psas/rocket-tracks/Documentation/poster/Rocket_Tracks_Overall.png

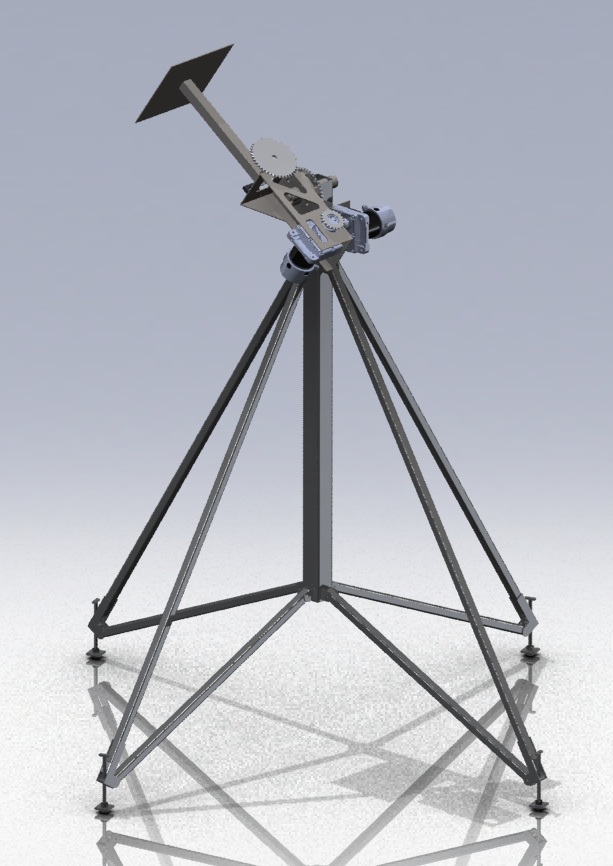
Documentation/poster/Rocket_Tracks_Overall.png
