psas/rocket-tracks/README.md

rocket-tracks
=============

CAD files for the Rocket Tracks project
