psas/rocket-tracks/Documentation/poster/RTx_pp_presentation.pptx

## RocketTracks Capstone

Rob Gaskell Robert Corkran Robin Davis

## Problem or Need

- What good is a high tech rocket if you can’t track it?
  - Current PSAS methods of tracking are limited by dependence on human eye
- Rockets move fast
  - Keeping antennas and cameras pointed at them during flight is a challenge
- RocketTracks was originally conceptualized in 2011as a mechanical structure controlled by a manual control box
  - While this was an improvement on earlier handheld models, it still left too much room for human error

Idea

Eliminate human error by adding automatic tracking capabilities to the existing RocketTracks system

## Implementation

- Create RocketTracks controller board to interface mechanical system with automatic and manual control boards
- Implement Ethernet for communication between different blocks of RocketTracks system
- Interface with Sightline SLA-1500 to add automatic tracking
- Improve control loop for manual controller and interface via Ethernet
- Implement power pre-charge circuitry
- Create safety protocols and perform FMEA analysis to protect from personal injury or damage to system

## Top-Level Requirements

- Be capable of tracking the PSAS launch vehicle throughout the duration of its boost stage of flight
- Be portable / self-powered
- Withstand exposure to rain while powered down (Excluding payload)
- Be operable in temperatures typical of Brothers, OR year-round
- Prevent single points of failure from causing injury or permanent damage to the unit or properly attached payloads
- Allow manual control of individual axes
- Interface with existing mechanical design and motor drivers
- Support remote operation
- The system will contain an API for relevant communications via Ethernet
- Interface with Sightline SLA1500 via Ethernet
- Provide power over Ethernet to payload devices

## Design & Implementation

## System Level Block Diagram

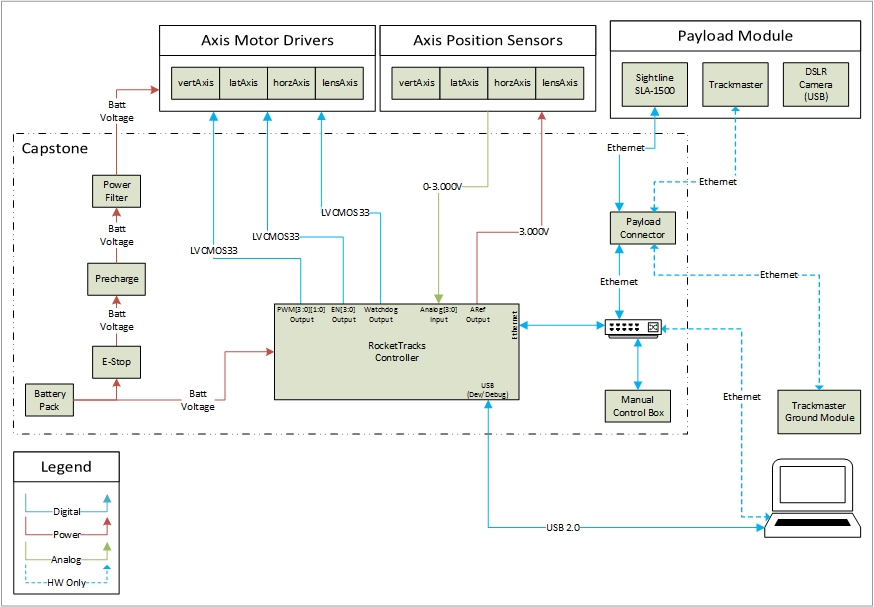
[picture p3: figure]

## RTx Controller Block Diagram

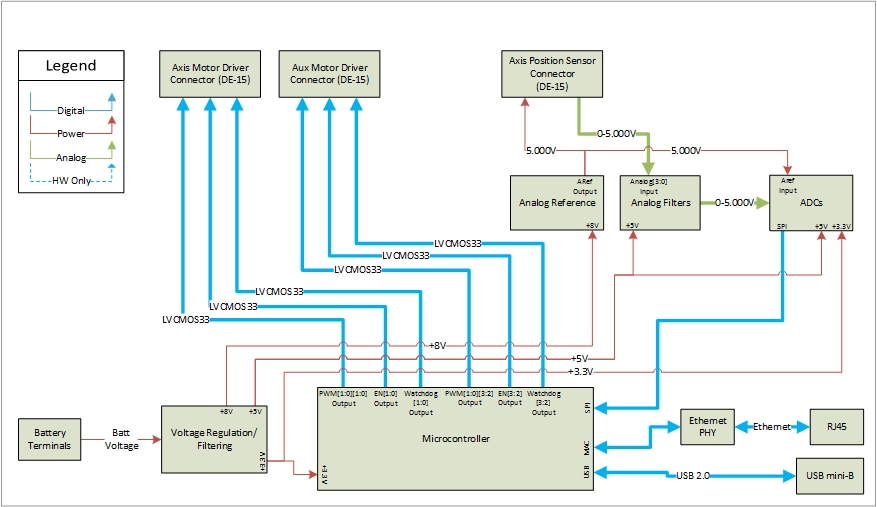
[picture p4: figure]

## Implementation: RTx Controller ADC Circuitry

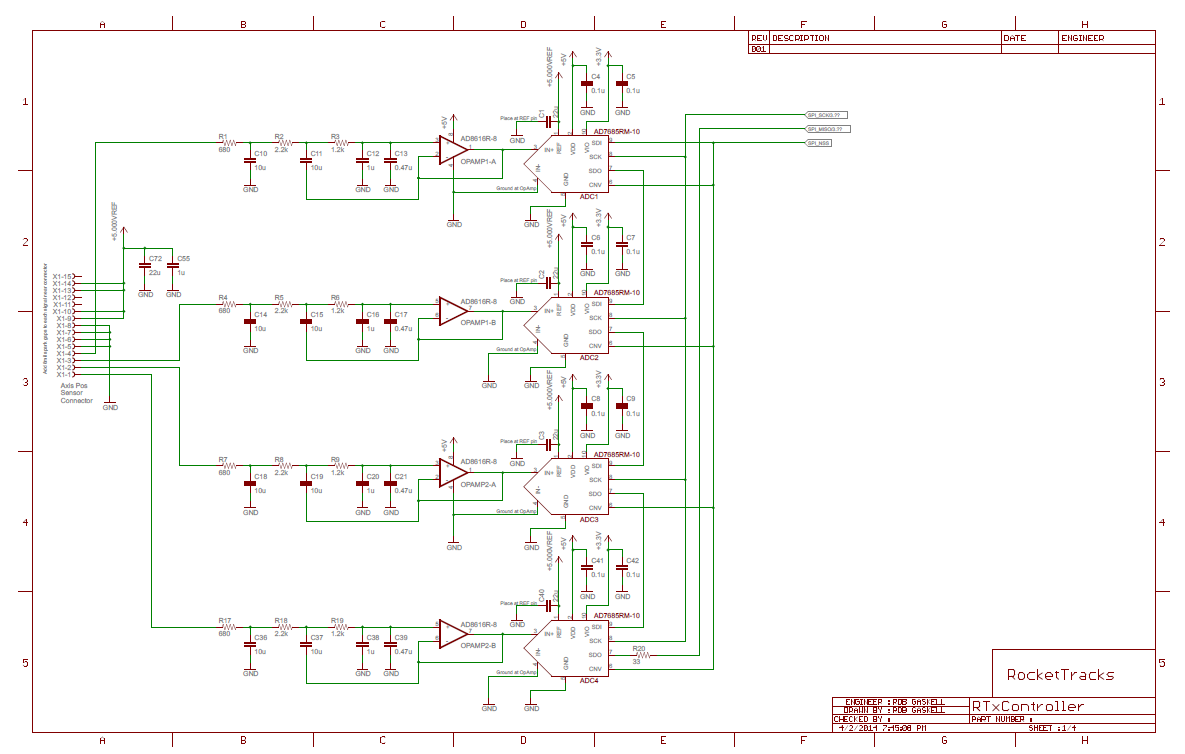
[picture p5: figure]

## Implementation: RTx Controller Power Circuitry

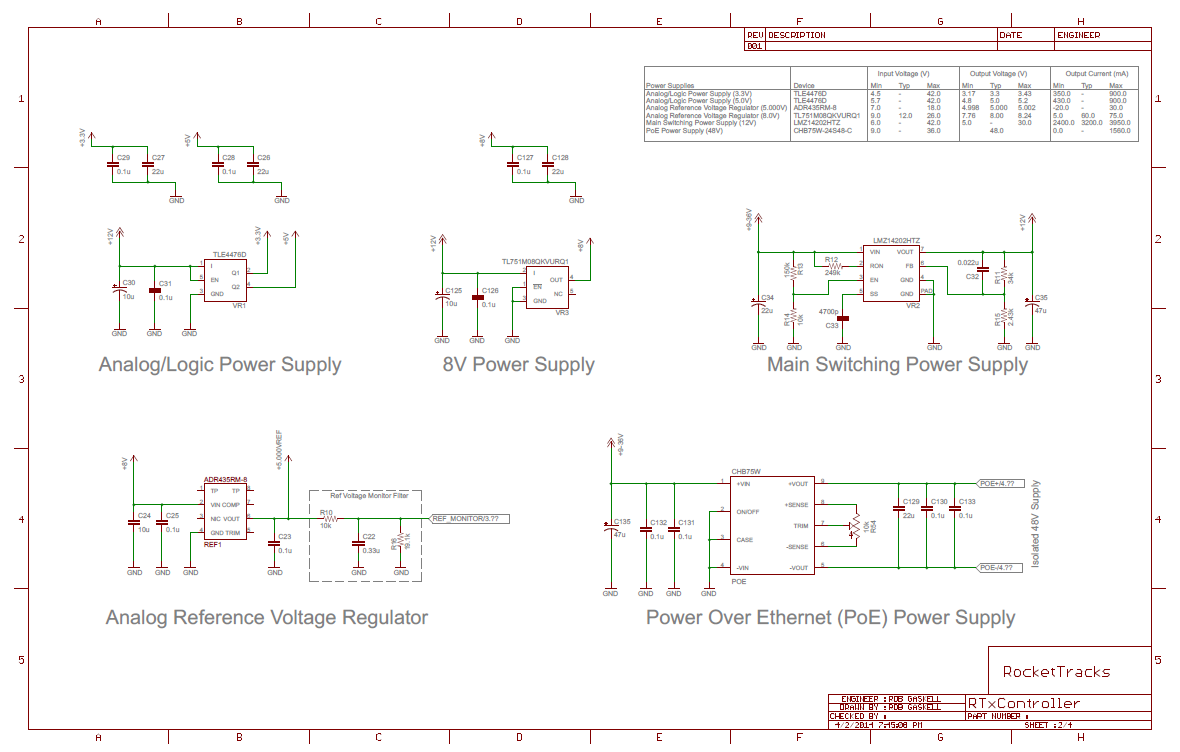
[picture p6: figure]

## Implementation: RTx Controller μC Circuitry

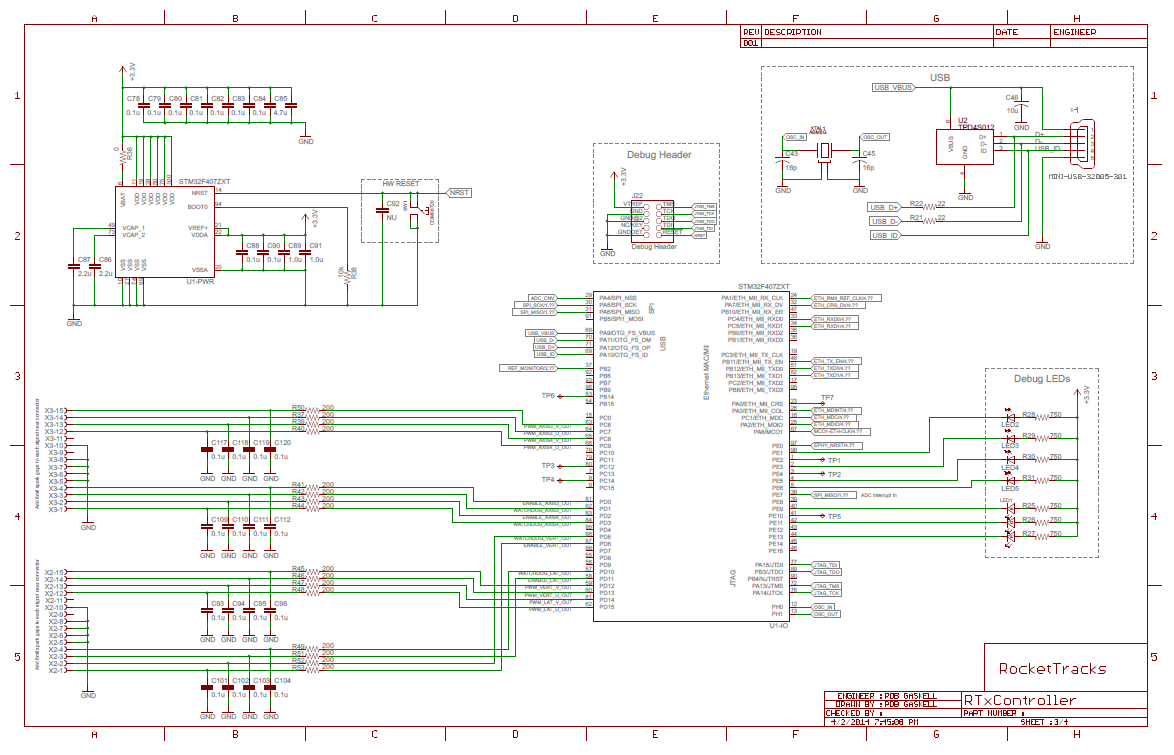
[picture p7: figure]

## Implementation: RTx Controller Ethernet Circuitry

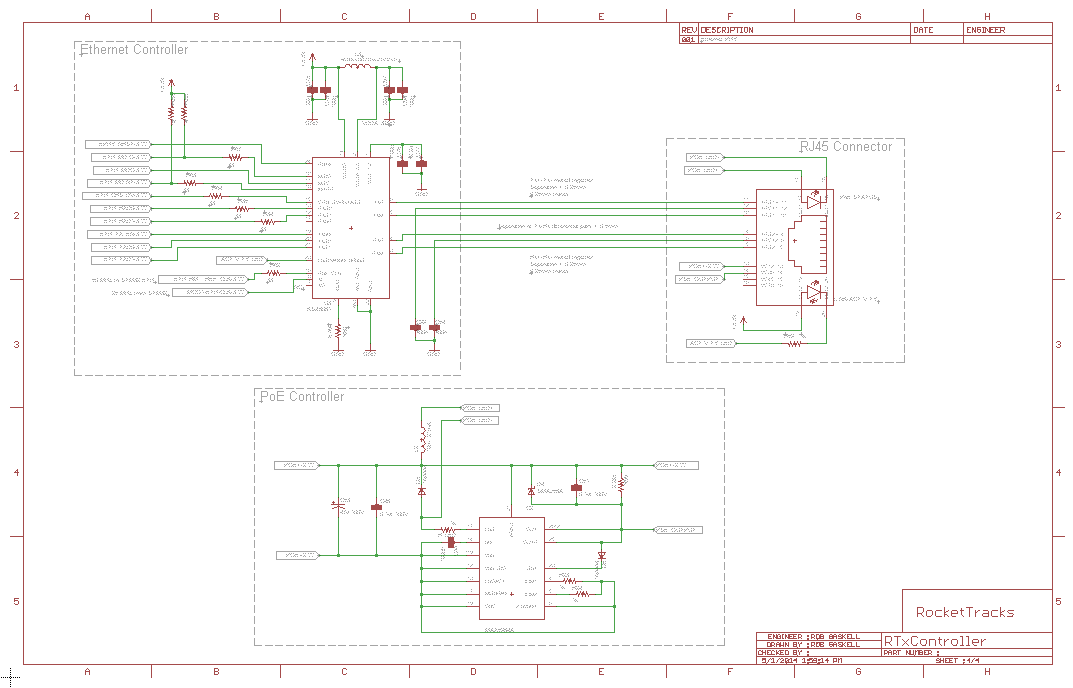
[picture p8: figure]

## Implementation: Manual Remote

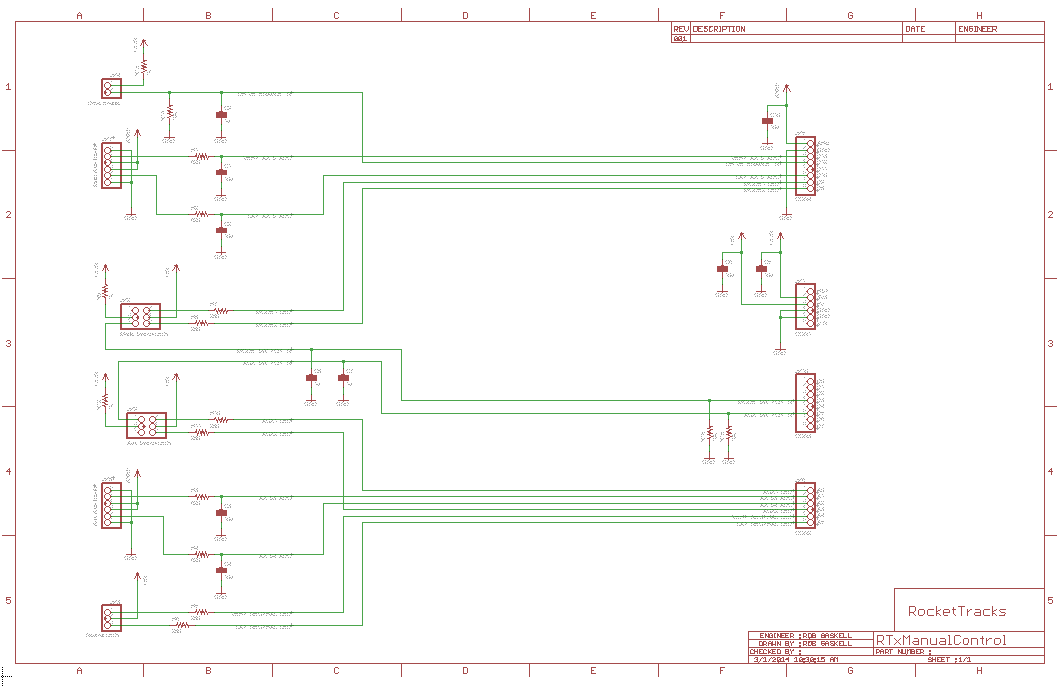
[picture p9: figure]

## Implementation: Precharge Circuit

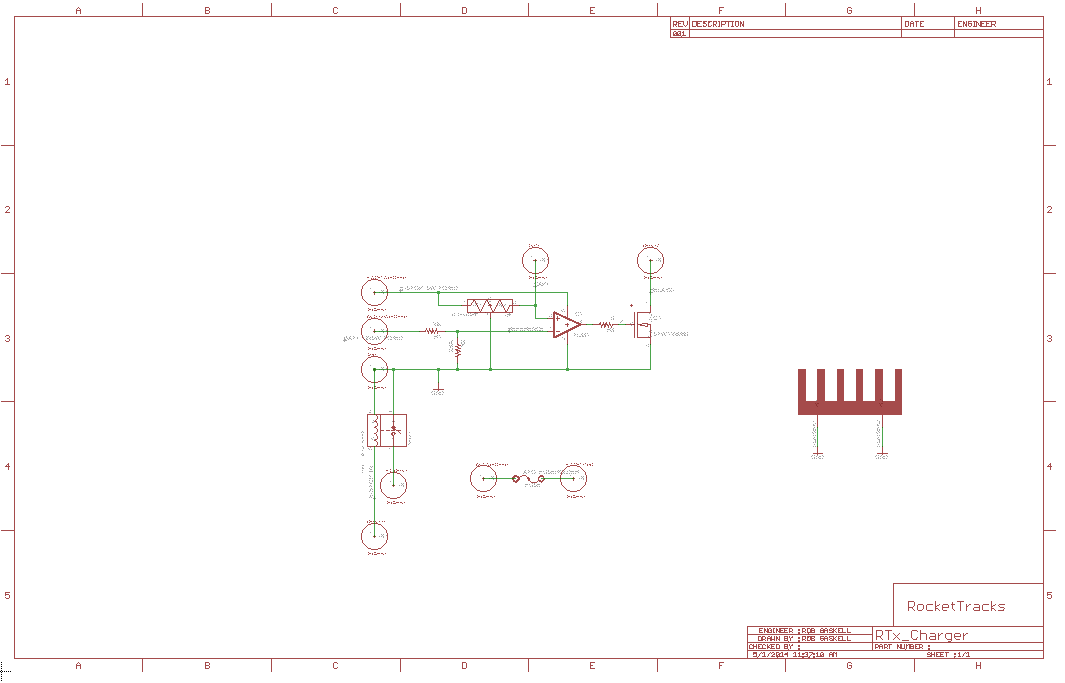
[picture p10: figure]

## Issues Encountered

## Issues Encountered: Hardware

- USB connector case not properly grounded
- Relays’ cases needed to be connected to power and isolated from enclosure
- Wrong capacitor footprint used so cap bank needs to be reworked
- Incorrect connector pinouts from motor driver boards to RTx controller
- PoE not performing at full potential

## Issues Encountered: Software

- Ethernet message passing errors
- High-latency on the receiver end of Ethernet packets
- SPI config and interrupt triggering

## Future Work/Expansion and Improvement

## Next Steps

- Test at launch 11 on July 20th
- Provide data to Sightline to improve their tracking algorithm
- Update board files to correct for issues found
- Build safety perimeter
- Design and build payload connector

Expansion and Improvement

Possibly create cellphone app to interface with system
removes need for physical proximity to mechanical structure

## Q&A
