psas/rocket-tracks/Documentation/poster/poster2.pptx

## RocketTracks

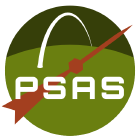
[picture p13: figure]

Portland State
Aerospace Society

Sponsor: Andrew Greenberg

Rob Gaskell, Robin Davis, Robert Corkran

Portland State
University

Advisor: Malgorzata Jeske

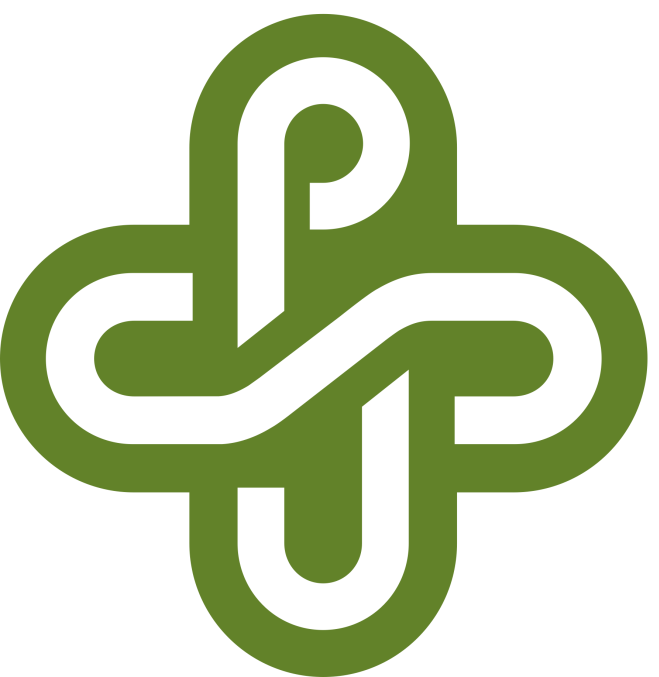
[picture p14: figure]

PROBLEM

What good is a high tech rocket if you can’t track it?
Current PSAS methods of tracking are limited by dependence on human eye.

Rockets move fast.
Keeping antennas and cameras pointed at them during flight is a challenge.

RocketTracks was originally conceptualized in 2011 as a mechanical structure controlled by a manual control box.

While this was an improvement over earlier handheld models, it still left too much room for human error.

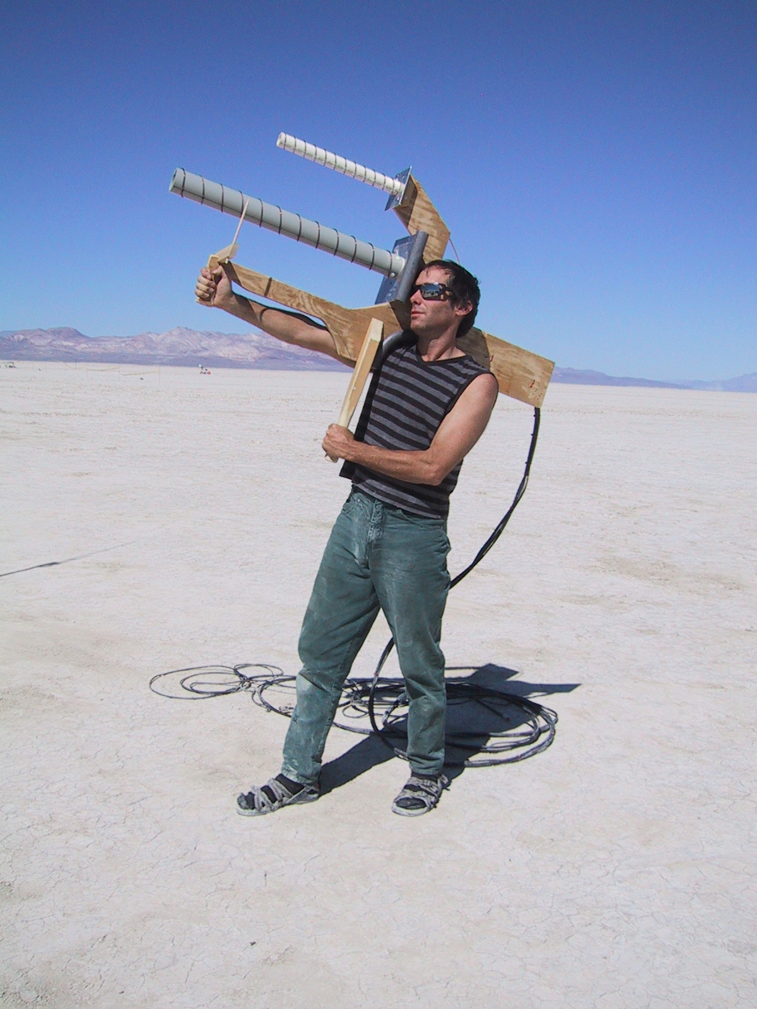
[picture p15: figure]
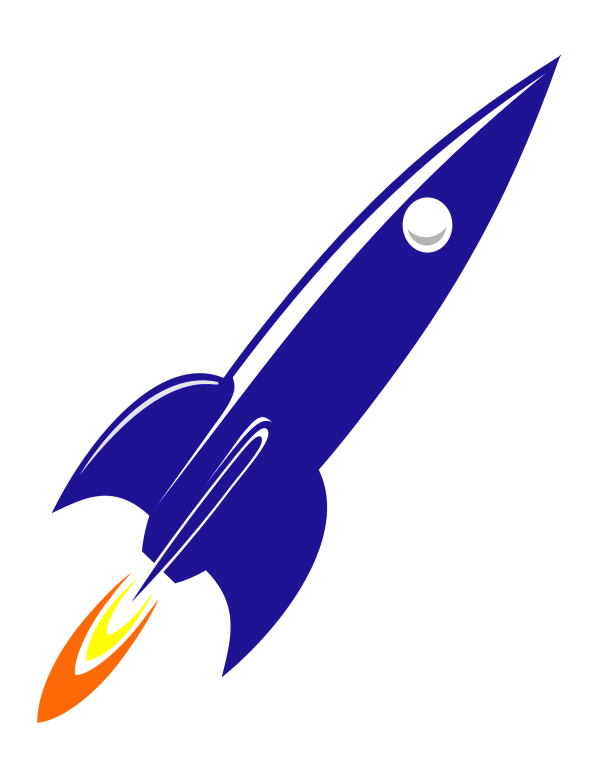
[picture p16: figure]
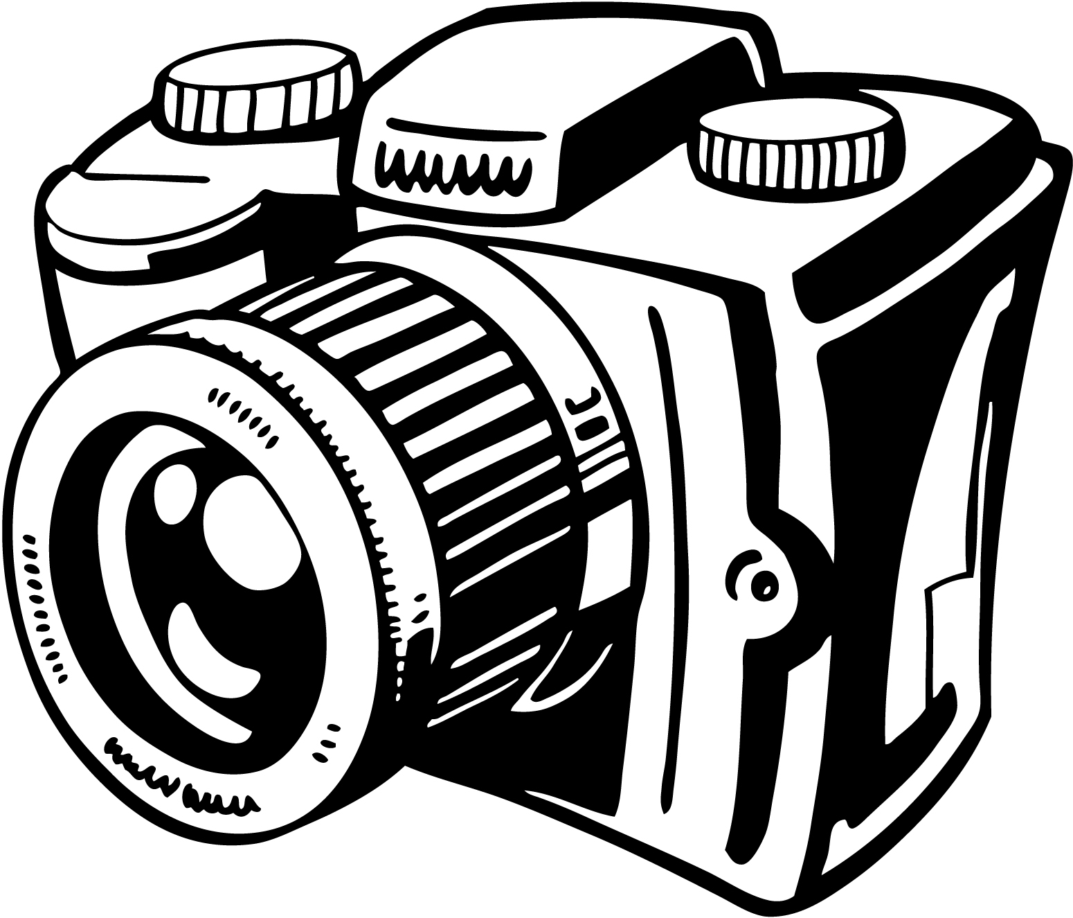
[picture p17: figure]

HOW IT WORKS

User selects mode

Manual Mode:
User can adjust the direction that RocketTracks points by turning two nobs corresponding to the horizontal and vertical axes

Automatic Mode:
- User selects object to track using laptop.
- Camera provides feedback to Sightline® as to position of the object.
- RTx Controller adjusts mechanical position accordingly

Emergency Stop
Automatic removal of power to system if:
- Big red button is pushed
- User gets too close to system
- Any single component breaks that could result in loss of system control

RTx
Controller

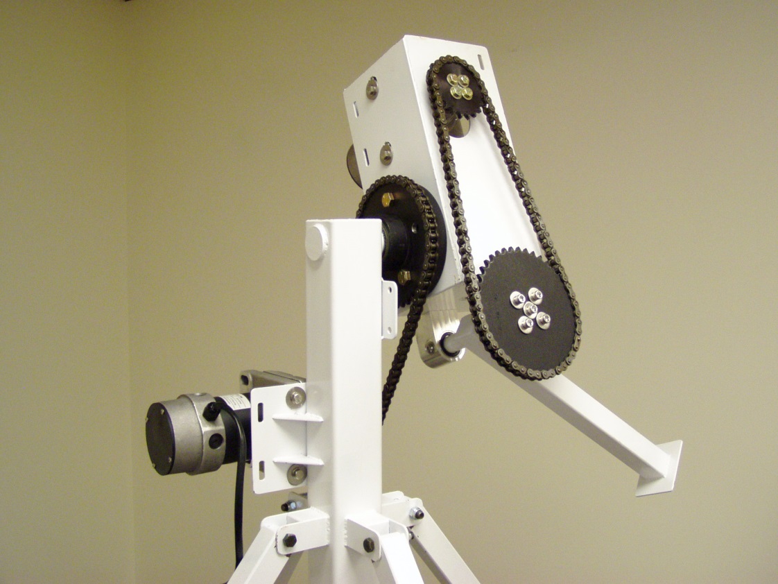
[picture p18: figure]

IDEA

Eliminate human error by adding automatic tracking capabilities to the existing RocketTracks system.

Manual
Control

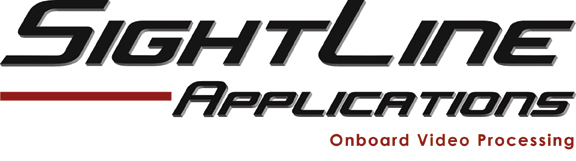
[picture p19: figure]

IMPLEMENTATION

- Create RocketTracks controller board to interface mechanical system with automatic and manual control boards
- Implement Ethernet for communication between different blocks of RocketTracks system
- Interface with Sightline SLA-1500 to add automatic tracking
- Improve control loop for manual controller and interface via Ethernet
- Create safety protocols and perform FMEA analysis to protect from personal injury or damage to system

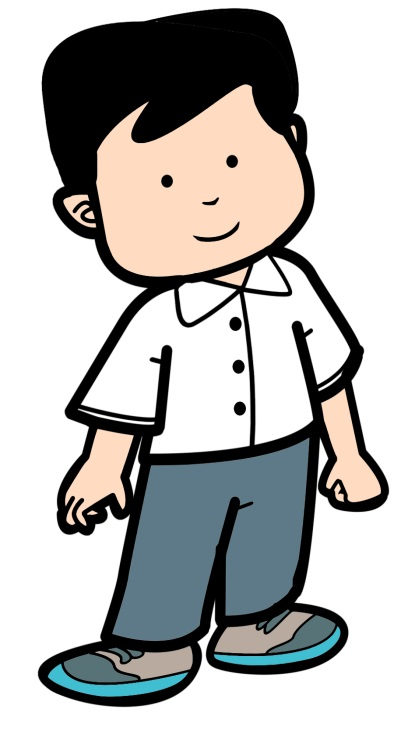
[picture p20: figure]
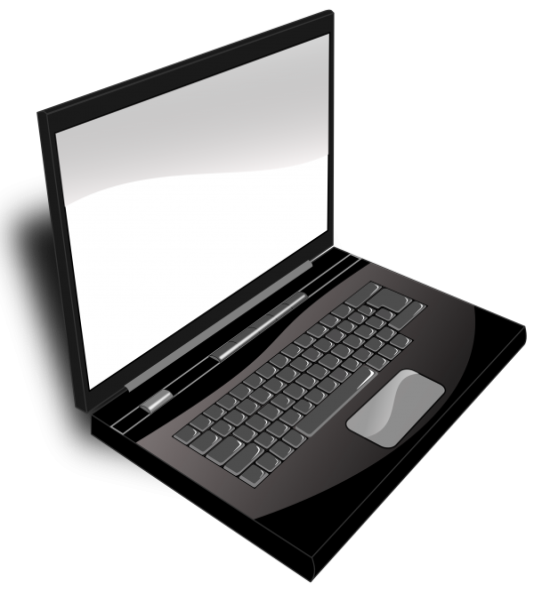
[picture p21: figure]

RTX CONTROLLER BLOCK DIAGRAM

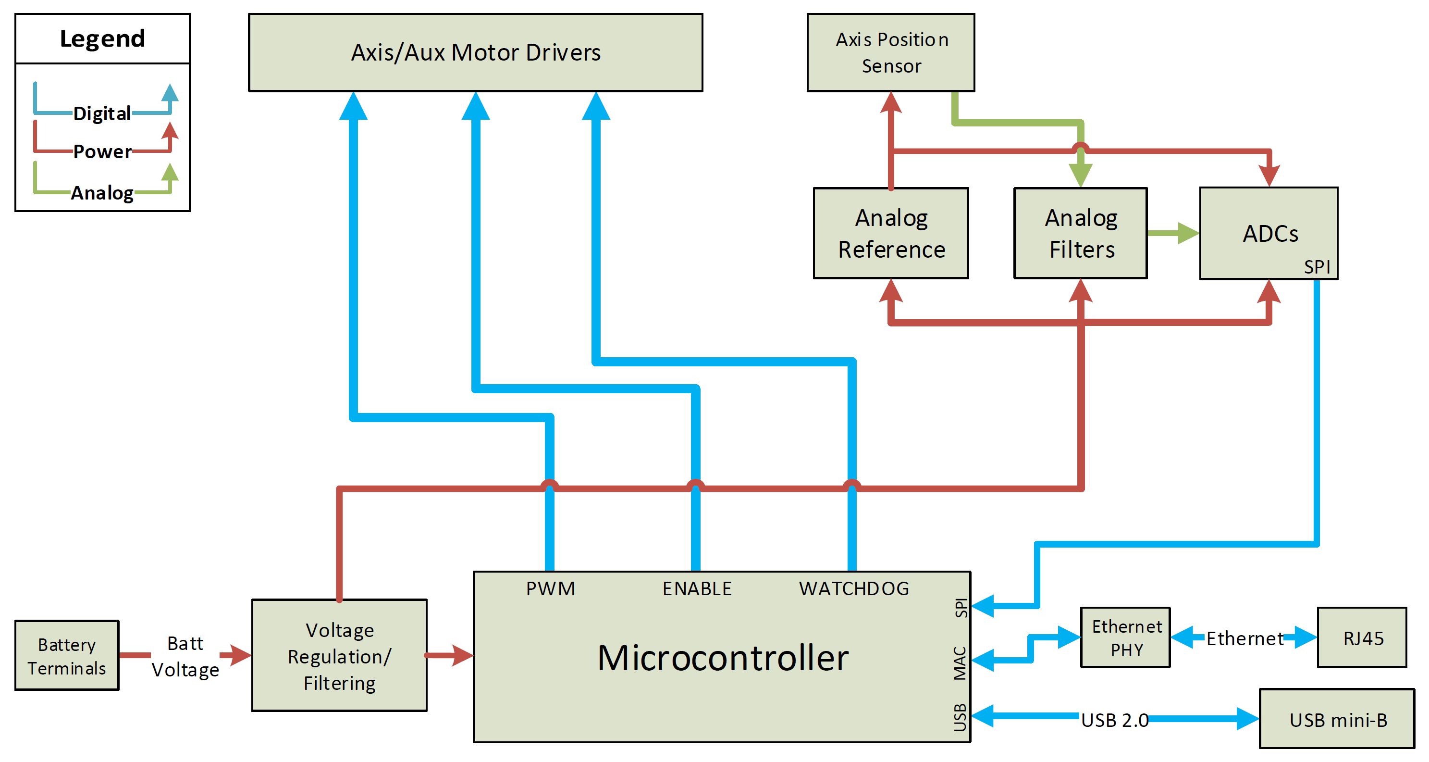
[picture p22: figure]
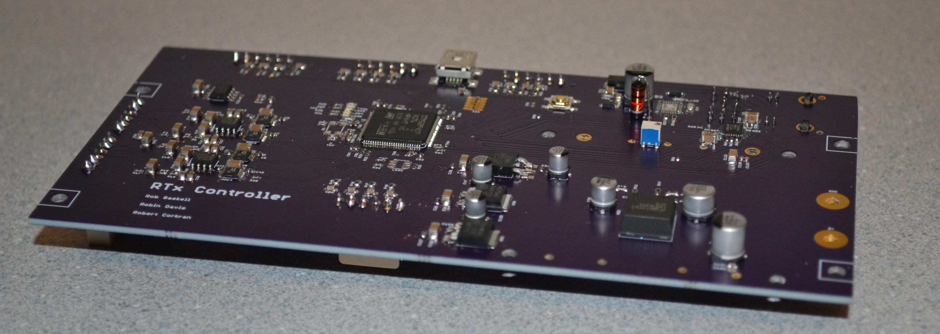
[picture p23: figure]
RTx controller board
