psas/rocket-tracks/Documentation/poster/YWMSy_Poster_V5 (4).pptx

## You Watch My Stuff

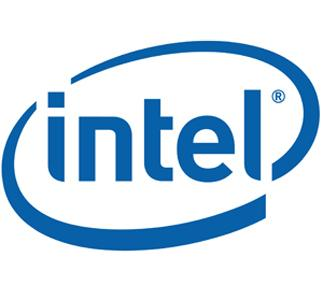
[picture p24: figure]

Sponsor: Chris Wilkerson

Team Members: Hussain Alsaffar, Richard Atwood, Amrutha Doosa, Raed Alkhaldi, Randy Duran


Adviser: Malgorzata Jeske

Theft is very common nowadays especially between college students. Today students can’t guarantee that their belongings will not be stolen while leaving it unattended. So?

Then you need YWMSy!

The Project You Watch My Stuff was Created and Sponsored by Chris Wilkerson from Intel. The Project is an Alarm Device that can be attached or placed on to any item you would like to secure. The Alarm Device is used in conjunction with a cell phone application. The phone application is used to turn “ON” the device and enable the Alarm.

A security device that will alert the user and keep a thief from stealing your belongings is a necessity in these days.

- Bluetooth Type 2 Range is about 30ft /10m in sight
- User friendly Android GUI
- Secure Communication via Bluetooth
- Alarm Triggered when device is Moved
- Panic/Finder Enabled
- Portable
- Battery life time more then 12 hours and less than122 hours

PROBLEM

Has this ever happened to you

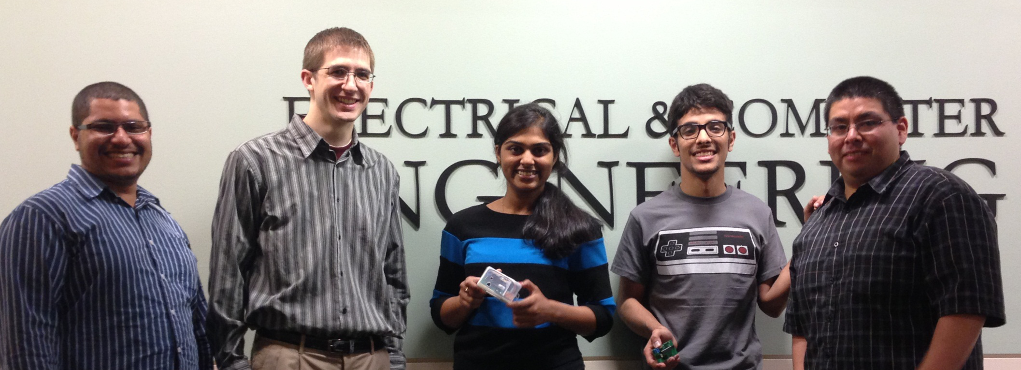
[picture p26: figure]

HYPOTHETICAL VISION

The You watch my Stuff Project has Future plans in expanding the many feature possibilities. The Future objective of this Project will be to create a smaller, affordable and Interactive device such as the designs shown below

Features:
- Pedometer
- GPS Tracker
- Waterproof package
- Small package using surface mount components
- Close to Out of Range area cell phone notification
- Rechargeable batteries

ACKNOWLEDGEMENTS

We want to thank the following people for their support and feedback on Our Progress
Sponsor: Chris Wilkerson
Adviser: Malgorzata Jeske
Professor: Mark Faust

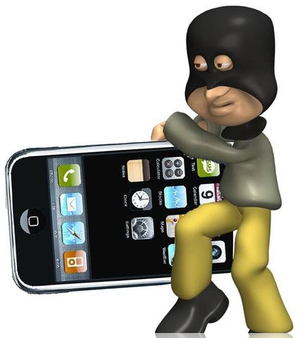
[picture p27: figure]

IMPLEMENTATION

The alarm device has a multicolor LED that Interacts with the user. Below is a chart of how the Alarm device Turns on the LED.

-Alarm is Detecting Movement
- Alarm is ‘ON’ state
- Alarm is Activated
-Triggered Alarm (Blink .5 sec)

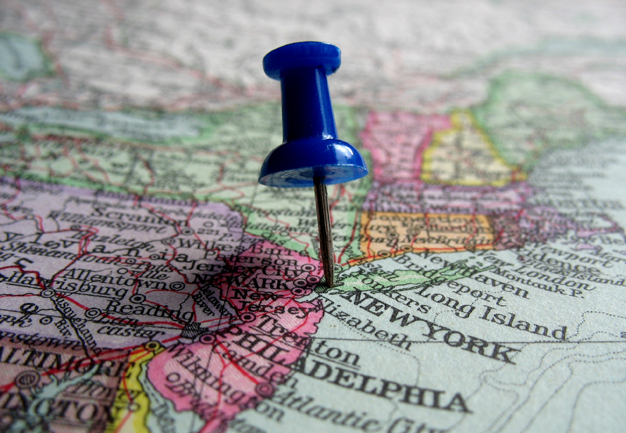
[picture p28: figure]

IDEA

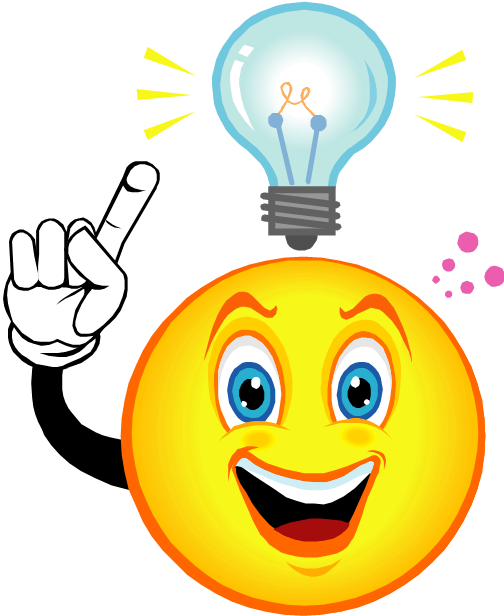
[picture p29: figure]

ANDROID APPLICATION

The Alarm device is controlled via cell phone and the Pictures below shows Graphic User Interface that controlled the Alarm device. The application has buttons to ON/OFF, Enable/Disabled and Panic the Alarm Device

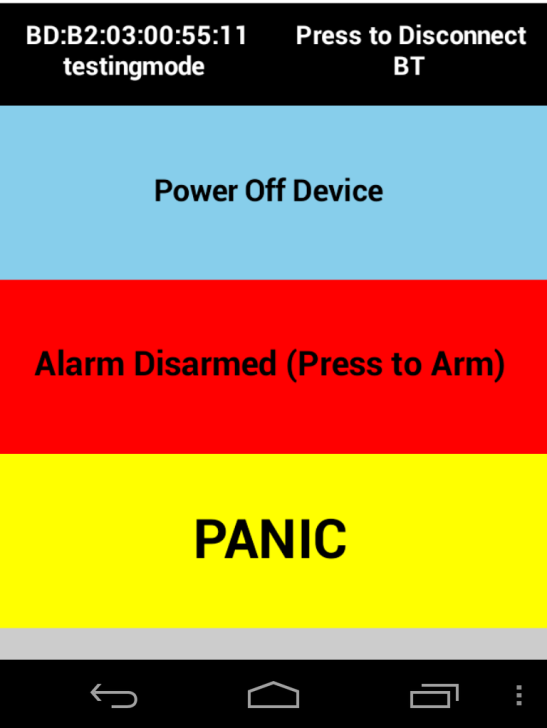
[picture p30: figure]
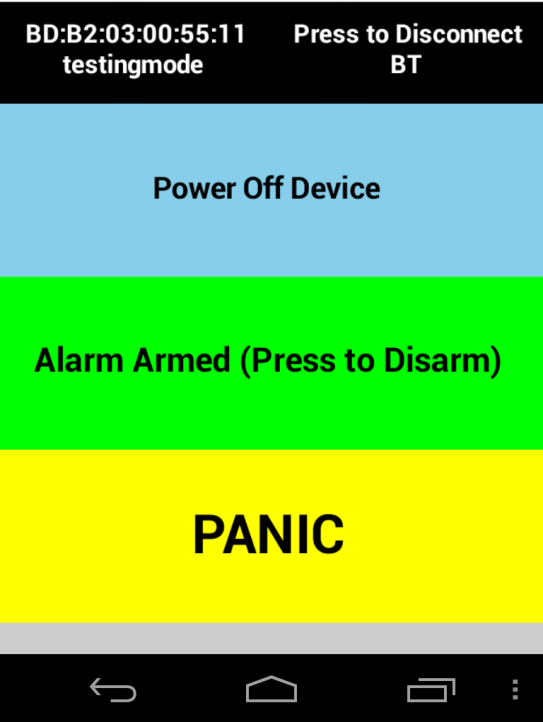
[picture p31: figure]
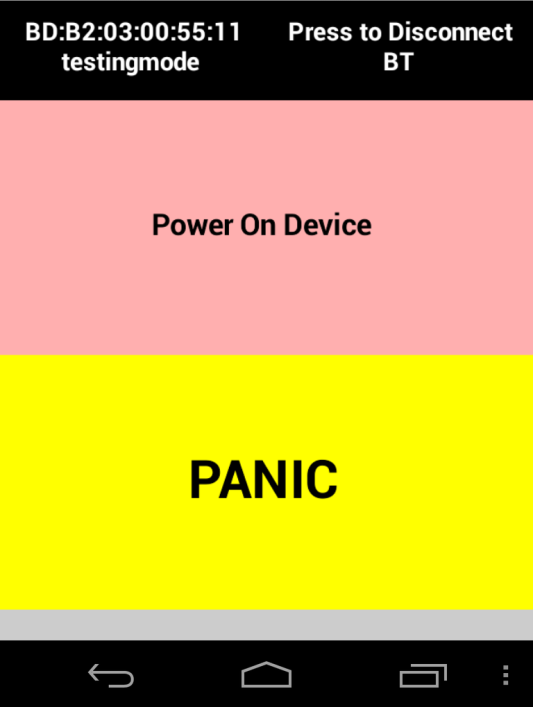
[picture p32: figure]

Pen Design

Alarm Ball Design

GOALS

DESIGN BLOCK DIAGRAM

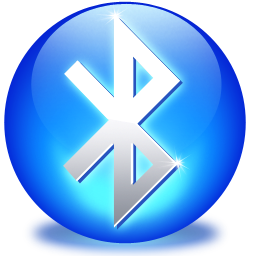
[picture p33: figure]

MCECS Department of Electrical and Computer Engineering
