psas/rocket-tracks/Documentation/RocketTracks SOP.docx

RocketTracks SOP

I. Setting up the system
1) Before approaching the RocketTracks mechanical structure:
  a. Ensure Main Power Box is disconnected from battery, if not please follow instructions for section IV before proceeding to step 2.
  b. Ensure Main Power Box is disconnected from RTx Controller Box, if not please follow instructions for section IV before proceeding to step 2.
2) Make sure the axis position sensors (D-sub connector) to RTx Controller Box (mounted on physical structure) are connected. Make sure the screws are snug.
3) Make sure motor drivers are connected to RTx Controller Box. Make sure connector is snapped into place.
4) Connect Ethernet cable from manual remote to Rtx controller port 3 or 4.
5) Optional Step: If you will be operating in Automatic Mode, connect Laptop with Sightline software installed to the RTx Controller Box via Ethernet port 3 or 4.
6) Connect Power from Main Power Box to RTx Controller Box.
7) Ensure main power switch is in OFF position.
8) Connect Main Power Box to batteries
9) Ensure E-stop button is released
10) Switch power switch to on position
11) Now that the system is on do not approach the mechanical structure. If you need to do so for any reason follow procedure from section IV first.
II. To operate in Manual mode:
1) Enable Drive enable Switch
  a. Lift guard
  b. Toggle the switch
2) Switch mode switch to manual position
3) Control using vertical and lateral axis position knobs
4) Should odd behavior occur or an emergency arise push the E-stop button and then proceed to section IV.
5) See section IV to shut system down.
III. To operate in Automatic Mode:
1) Enable Drive enable Switch
  a. Lift guard
  b. Switch the switch
2) Switch mode switch to automatic position
3) There are not currently steps for this procedure; they will be updated after the automatic tracking capabilities of RocketTracks are tested.
4) See section IV to shut system down.
IV. Shutting down the system
1) Disable the drive enable switch by closing the guard
2) Switch power to off on Main Power Box
3) Disconnect Main Power Box from battery
4) Disconnect Main Power Box from RTx Controller Box
5) Disconnect Manual Control from RTx Controller Box
6) If laptop is connected disconnect it from RTx Controller Box
