psas/rocket-tracks/Documentation/poster/rocket-512.gif

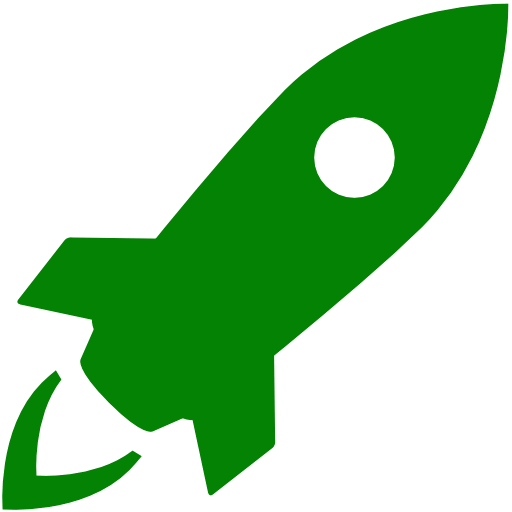
Documentation/poster/rocket-512.gif
