psas/rocket-tracks/Generic_Motor_Driver_Board/Motor Controller Board.png

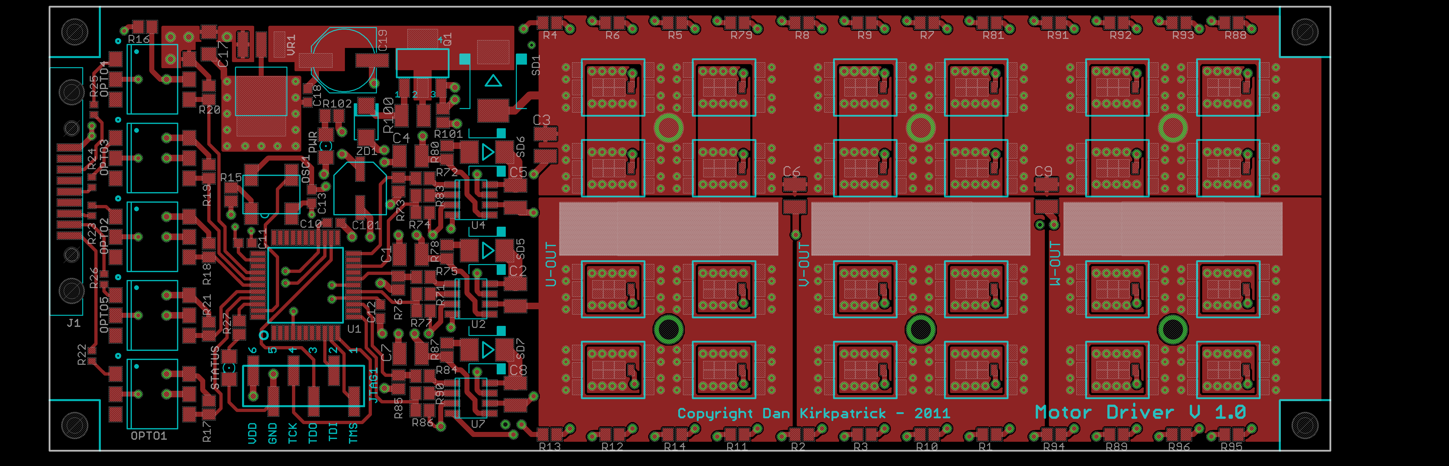
Generic_Motor_Driver_Board/Motor Controller Board.png
