psas/rocket-tracks/RTx_Controller_Board/Pictures/RTx Controller 001.JPG

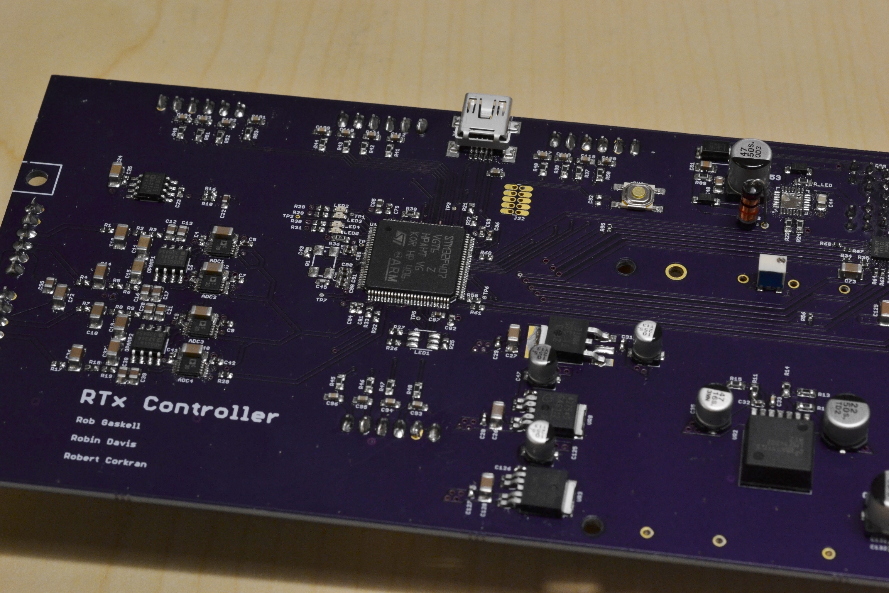
RTx_Controller_Board/Pictures/RTx Controller 001.JPG
