psas/rocket-tracks/RTx_Controller_Board/Pictures/RTx Controller 002.JPG

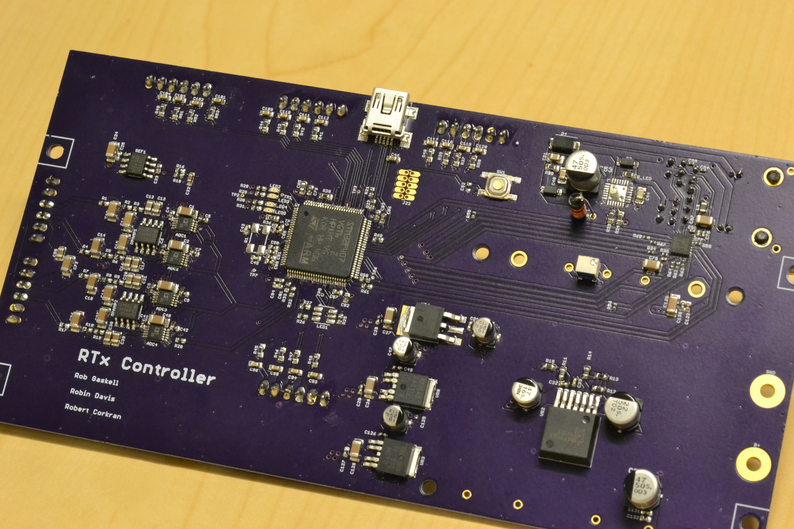
RTx_Controller_Board/Pictures/RTx Controller 002.JPG
