psas/rocket-tracks/RTx_Controller_Board/Pictures/RTx Controller 003.JPG

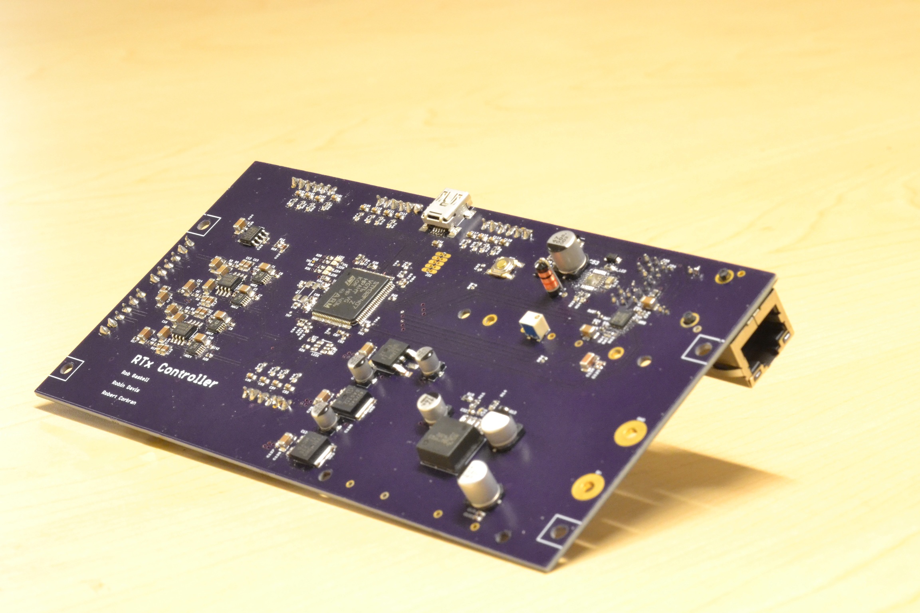
RTx_Controller_Board/Pictures/RTx Controller 003.JPG
