psas/rocket-tracks/RTx_Controller_Board/Pictures/RTx Controller 004.JPG

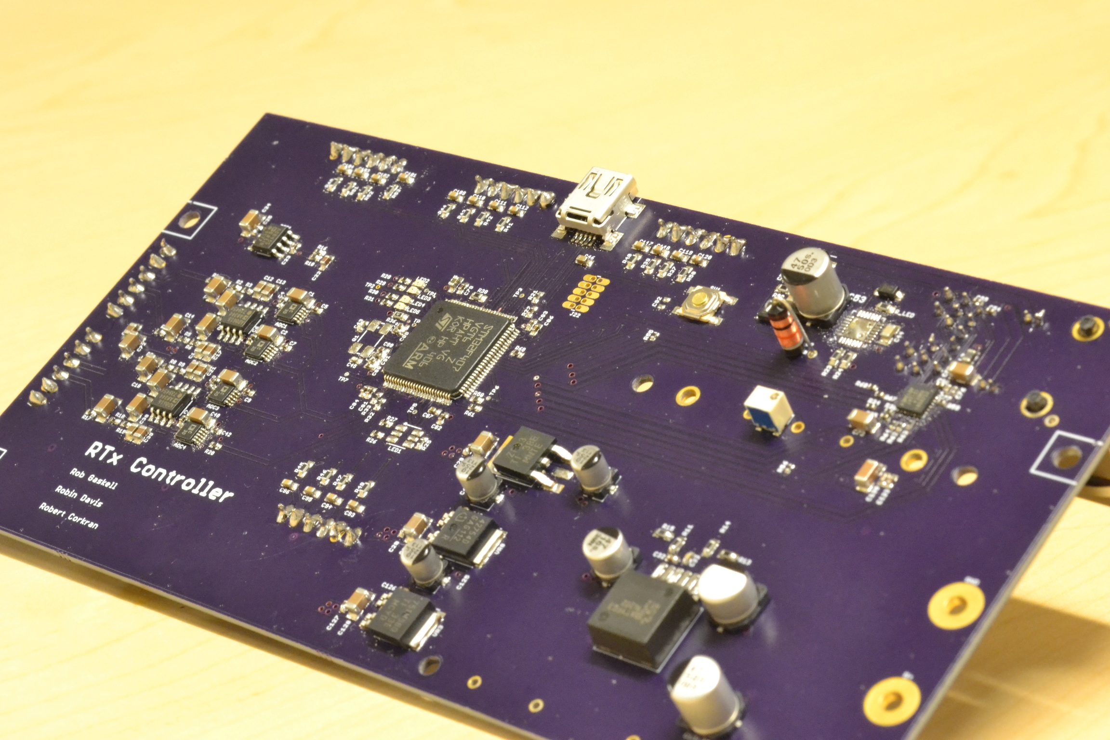
RTx_Controller_Board/Pictures/RTx Controller 004.JPG
