psas/rocket-tracks/RTx_Controller_Board/Pictures/RTx Controller 005.JPG

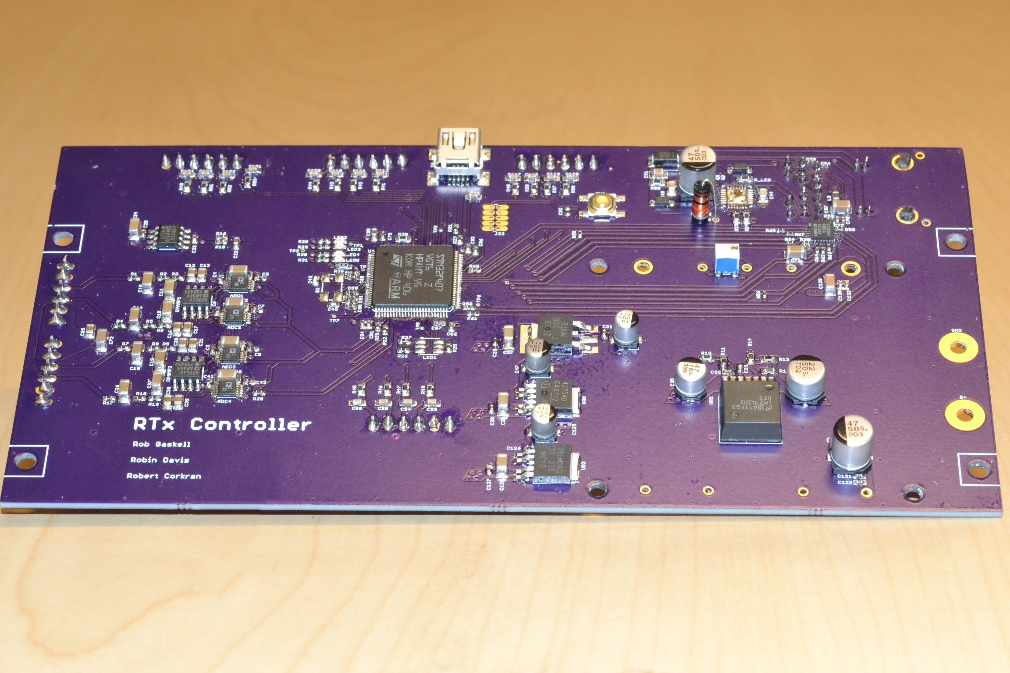
RTx_Controller_Board/Pictures/RTx Controller 005.JPG
