psas/rocket-tracks/RTx_Controller_Board/Pictures/RTx Controller 006.JPG

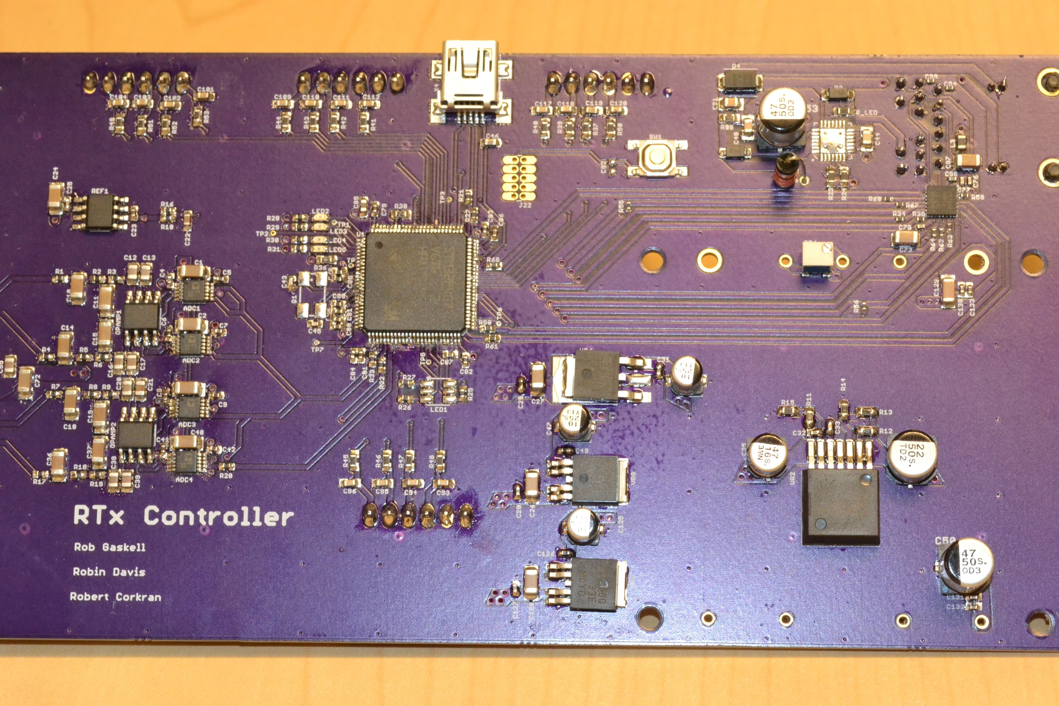
RTx_Controller_Board/Pictures/RTx Controller 006.JPG
