psas/rocket-tracks/RTx_Controller_Board/Pictures/RTx Controller 007.JPG

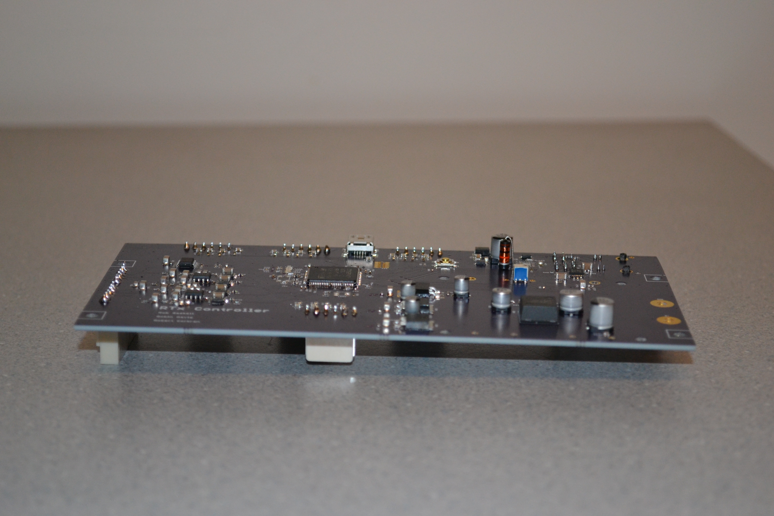
RTx_Controller_Board/Pictures/RTx Controller 007.JPG
