psas/rocket-tracks/RTx_Controller_Board/Pictures/RTx Controller 008.JPG

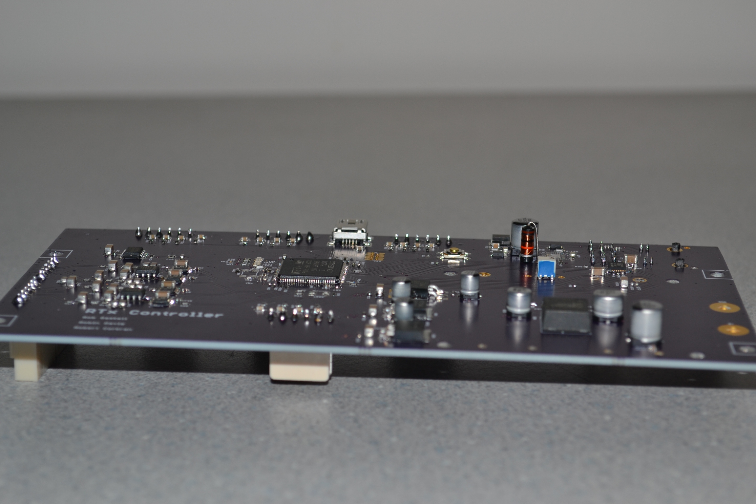
RTx_Controller_Board/Pictures/RTx Controller 008.JPG
