psas/rocket-tracks/RTx_Controller_Board/Pictures/RTx Controller 009.JPG

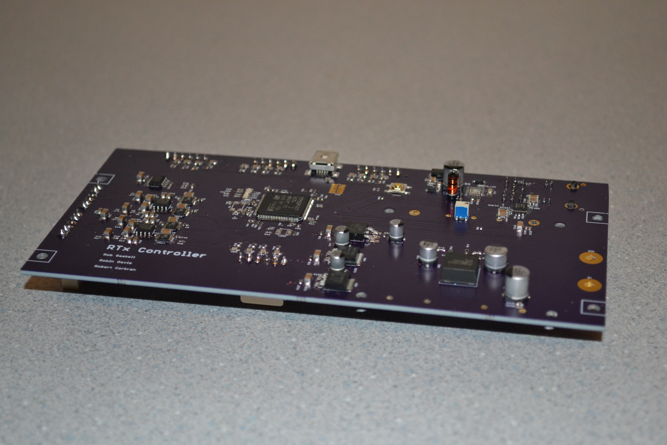
RTx_Controller_Board/Pictures/RTx Controller 009.JPG
