psas/rocket-tracks/RTx_Controller_Board/RTxControllerBoardBOM.xlsx

Sheet: Sheet1
RTx ID | Order Qty | Order PN | Notes | Value | Device | Package | Qty | Parts | Description | MF | MPN | OC_FARNELL | OC_NEWARK | TP_SIGNAL_NAME | VARIANT
1 | 10 | 1276-1119-1-ND | 0603 | 10u | C-USC0402 | C0402 | 1 | C46 | CAPACITOR, American symbol
2 | 10 | 1276-1571-1-ND |  | 4700p | C-EUC0402 | C0402 | 1 | C33 | CAPACITOR, European symbol
3 | 30 | 1276-1804-1-ND |  | 10u | C-EUC1206 | C1206 | 9 | C10, C11, C14, C15, C18, C19, C24, C36, C37 | CAPACITOR, European symbol
4 | 35 | 1276-3047-1-ND |  | 22u | C-EUC1206 | C1206 | 10 | C1, C2, C3, C26, C27, C40, C72, C128, C73, C97 | CAPACITOR, European symbol
5 | 12 | 160-1445-1-ND |  |  | LEDCHIP-LED0603 | CHIP-LED0603 | 4 | LED2, LED3, LED4, LED5 | LED
6 | 10 | 1N4448W-FDICT-ND |  | 1N4448 | 1N4448 | SOD-123 | 2 | D3, D5
7 | 3 | 296-20658-1-ND |  | TLV1117-33IKVU | TLV1117-33IKVU | PG-TO252-3-11 | 1 | VR6
8 | 3 | 296-28078-1-ND |  | TL751M08QKVURQ1 | TL751M08QKVURQ1 | PG-TO252-5-11 | 1 | VR3 | 8V power supply.
9 | 10 | 311-1142-1-ND |  | 100nF | C-EUC0805K | C0805K | 1 | C44 | CAPACITOR, European symbol
10 | 10 | 3223W-1-103-ND | Robert | 10k | TRIM_US-3223W | 3223W | 1 | R54 | POTENTIOMETER
11 | 50 | 399-1096-1-ND |  | 0.1u | C-EUC0603 | C0603 | 16 | C93, C94, C95, C96, C101, C102, C103, C104, C109, C110, C111, C112, C117, C118, C119, C120 | CAPACITOR, European symbol
12 | 10 | 399-11118-1-ND |  | 16p | C-USC0402 | C0402 | 2 | C43, C45 | CAPACITOR, American symbol
13 | 20 | 399-1284-1-ND |  | 1u | C-EUC0805 | C0805 | 5 | C12, C16, C20, C38, C55 | CAPACITOR, European symbol
14 | 10 | 399-3486-1-ND |  | 0.1uf 100V | C-EUC0805K | C0805K | 2 | C48, C51 | CAPACITOR, European symbol
15 | 10 | 445-5126-1-ND |  | 0.33u | C-EUC0603 | C0603 | 1 | C22 | CAPACITOR, European symbol
16 | 12 | 445-5942-1-ND |  | 0.1u 50V | C-EUC0402 | C0402 | 4 | C131, C132, C130, C133 | CAPACITOR, European symbol
17 | 5 | 445-5998-1-ND |  | 10u 50V | C-EUC1206 | C1206 | 1 | C129 | CAPACITOR, European symbol
18 | 15 | 445-6847-1-ND |  | 2.2u | C-EU0402-C-NOSILK | 0402-C-NOSILK | 3 | C77, C86, C87 | CAPACITOR, European symbol
19 | 3 | 490-1046-1-ND | Robert | FB0805/600R/200mA(201209-601) | L-US0805-C-NOSILK | 0805-C-NOSILK | 1 | L3 | INDUCTOR, American symbol
20 | 3 | 497-11605-ND |  | STM32F407ZXT | STM32F407ZXT | LQFP-100 | 1 | U1
21 | 10 | 507-1569-ND | Robert | 0826-1X1T-GJ-F | 0826-1X1T-GJ-F | MAGJACK-RJ45 | 1 | X8
22 | 3 | 576-4177-1-ND |  | KSZ8081 | KSZ8081 | QFN-24 | 1 | U3
23 | 10 | 587-1224-1-ND |  | 0.022u | C-EUC0402 | C0402 | 1 | C32 | CAPACITOR, European symbol
24 | 80 | 587-1227-1-ND |  | 0.1u | C-EUC0402 | C0402 | 25 | C4, C5, C6, C7, C8, C9, C23, C25, C28, C29, C31, C41, C42, C49, C78, C79, C80, C81, C82, C83, C84, C88, C90, C126, C127 | CAPACITOR, European symbol
25 | 25 | 587-1231-1-ND |  | 1.0u | C-EUC0402 | C0402 | 7 | C89, C91, C54, C75, C76, C98, C99 | CAPACITOR, European symbol
26 | 15 | 587-1282-1-ND |  | 0.47u | C-EUC0805 | C0805 | 4 | C13, C17, C21, C39 | CAPACITOR, European symbol
27 | 10 | 587-1441-1-ND |  | 4.7u | C-EUC0603 | C0603 | 1 | C85 | CAPACITOR, European symbol
28 | 3 | 670-1190-1-ND | Robin | MINI-USB-32005-301 | MINI-USB-32005-301 | 32005-301 | 1 | X4 | MINI USB-B Conector |  |  | unknown | unknown
29 | 12 | AD7685BRMZRL7CT-ND |  | AD7685RM-10 | AD7685RM-10 | MSOP-10 | 4 | ADC1, ADC2, ADC3, ADC4
30 | 6 | AD8616ARZ-REEL7CT-ND |  | AD8616R-8 | AD8616R-8 | SOIC8 | 2 | OPAMP1, OPAMP2
31 | 3 | ADR435BRZ-REEL7CT-ND |  | ADR435RM-8 | ADR435RM-8 | SOIC8 | 1 | REF1
32 | 10 | AIAP-01-103-K-TCT-ND | Robert | 10m, 21mA | L-US0204V | 0204V | 1 | L2 | INDUCTOR, American symbol
33 | 3 | CKN9104CT-ND | Robin | COM08720 | COM08720 | COM08720 | 1 | SW1
34 | 3 | LMZ14202HTZ/NOPBCT-ND |  | LMZ14202HTZ | LMZ14202HTZ | PFM-7 | 1 | VR2
35 | 3 | MAX5984AETI+-ND | Robert | MAX5984A | MAX5984 | TQFN-28 | 1 | IC2 |  |  |  |  |  |  | C
36 | 10 | P0.0GCT-ND |  | 0 | R-US_R0603 | R0603 | 1 | R36 | RESISTOR, American symbol
37 | 15 | P1.00KHCT-ND |  | 1k | R-US_R0603 | R0603 | 3 | R23, R24, R_LED | RESISTOR, American symbol
38 | 15 | P1.00KLCT-ND |  | 1k | R-US_0402-C-NOSILK | 0402-C-NOSILK | 3 | R55, R56, R59 | RESISTOR, American symbol
39 | 15 | P1.20KLCT-ND |  | 1.2k | R-US_R0402 | R0402 | 4 | R3, R6, R9, R19 | RESISTOR, American symbol
40 | 10 | P10.0KHCT-ND |  | 10k | R-US_R0603 | R0603 | 2 | R14, R38 | RESISTOR, American symbol
41 | 10 | p10.0KLCT-ND |  | 10k | R-US_R0402 | R0402 | 1 | R10 | RESISTOR, American symbol
42 | 10 | P150KHCT-ND |  | 150k | R-US_R0603 | R0603 | 1 | R13 | RESISTOR, American symbol
43 | 10 | P19.1KLCT-ND |  | 19.1k | R-US_R0402 | R0402 | 1 | R16 | RESISTOR, American symbol
44 | 15 | P2.20KLCT-ND |  | 2.2k | R-US_R0402 | R0402 | 4 | R2, R5, R8, R18 | RESISTOR, American symbol
45 | 10 | P2.20MHCT-ND |  | 2.2M | R-US_R0603 | R0603 | 1 | R99 | RESISTOR, American symbol
46 | 10 | P2.43KHCT-ND |  | 2.43k | R-US_R0603 | R0603 | 1 | R15 | RESISTOR, American symbol
47 | 55 | P200-HCT-ND |  | 200 | R-US_R0603 | R0603 | 16 | R37, R39, R40, R41, R42, R43, R44, R45, R46, R47, R48, R49, R50, R51, R52, R53 | RESISTOR, American symbol
48 | 10 | P22.0LCT-ND |  | 22 | R-US_R0402 | R0402 | 2 | R21, R22 | RESISTOR, American symbol
49 | 5 | P249KHCT-ND |  | 249k | R-US_R0603 | R0603 | 1 | R12 | RESISTOR, American symbol
50 | 55 | P33.0LCT-ND |  | 33 | R-US_R0402 | R0402 | 15 | R20, R32, R33, R34, R35, R57, R58, R61, R62, R63, R64, R65, R66, R67, R68 | RESISTOR, American symbol
51 | 10 | P34.0KHCT-ND |  | 34k | R-US_R0603 | R0603 | 1 | R11 | RESISTOR, American symbol
52 | 10 | P6.49KLCT-ND |  | 6.49k | R-US_0402-C-NOSILK | 0402-C-NOSILK | 1 | R60 | RESISTOR, American symbol
53 | 15 | P680LCT-ND |  | 680 | R-US_R0402 | R0402 | 4 | R1, R4, R7, R17 | RESISTOR, American symbol
54 | 25 | P750LCT-ND |  | 750 | R-US_R0402 | R0402 | 7 | R25, R26, R27, R28, R29, R30, R31 | RESISTOR, American symbol
55 | 10 | PCE3497CT-ND |  | 47uf 100V | CPOL-USB | PANASONIC_B | 1 | C52 | CAPACITOR, European symbol
56 | 10 | PCE3890CT-ND |  | 47u 16V | CPOL-USB | PANASONIC_B | 1 | C35 | POLARIZED CAPACITOR, American symbol
57 | 10 | PCE3895TR-ND |  | 10u | CPOL-USB | PANASONIC_B | 3 | C30, C47, C125 | POLARIZED CAPACITOR, American symbol
58 | 5 | PCE3920TR-ND |  | 22u 50V | CPOL-USB | PANASONIC_B | 1 | C34 | POLARIZED CAPACITOR, American symbol
59 | 10 | PCE3929CT-ND |  | 47u 50V | CPOL-USB | PANASONIC_B | 1 | C135 | POLARIZED CAPACITOR, American symbol
60 | 18 | S9414-ND | SWR25X |  | PINHD-1X6 | 1X06 | 6 | JP1, JP2, JP3, JP4, JP5, JP6 | PIN HEADER
61 | 12 | S9436-ND | SWH25X |  | Female-1X6 Polarized |  | 6
62 | 180 | S9473CT-ND |  |  | Connector Terminals |  | 53
63 | 3 | SMAJ58ALFTR-ND |  | SMAJ58A | SUPPRESSOR-SMBJ | SMBJ | 1 | D4 | Suppressor diode
64 | 3 | TLE42754DINCT-ND |  | TLE4275-QKVU | TLE4275-QKVU | PG-TO252-5-11 | 1 | VR8
65 | 3 |  | Andrew |  | CRYSTALCTS406 | CTS406 | 1 | Q1 | CRYSTAL |  |  | unknown | unknown
66 | 3 |  | Andrew |  | LED_RGB_PLCC-6 | PLCC-6 | 1 | LED1 | RGB LED with separate contacts for all 3 chips
67 | 3 |  | Andrew | Debug Header | 1.27MM_HDR_2X5 | 1.27MM_2X5 | 1 | J22
68 | 3 |  | Not populated | NU | C-EUC0402 | C0402 | 1 | C92 | CAPACITOR, European symbol
NON-DIGIKEY ITEMS
 | 1 | CHB75W-24S48 | http://www.psui.com/ | CHB75W-24S48 | CHB75W | CHB75W | 1 | POE

Sheet: Sheet2
Qty | Value | Device | Package | Parts | Description | MF | MPN | OC_FARNELL | OC_NEWARK | TP_SIGNAL_NAME | VARIANT
1 |  | CRYSTALCTS406 | CTS406 | Q1 | CRYSTAL |  |  | unknown | unknown
4 |  | LEDCHIP-LED0603 | CHIP-LED0603 | LED2, LED3, LED4, LED5 | LED
1 |  | LED_RGB_PLCC-6 | PLCC-6 | LED1 | RGB LED with separate contacts for all 3 chips
6 |  | PINHD-1X6 | 1X06 | JP1, JP2, JP3, JP4, JP5, JP6 | PIN HEADER
1 | 0 | R-US_R0603 | R0603 | R36 | RESISTOR, American symbol
1 | 0.022u | C-EUC0402 | C0402 | C32 | CAPACITOR, European symbol
25 | 0.1u | C-EUC0402 | C0402 | C4, C5, C6, C7, C8, C9, C23, C25, C28, C29, C31, C41, C42, C49, C78, C79, C80, C81, C82, C83, C84, C88, C90, C126, C127 | CAPACITOR, European symbol
16 | 0.1u | C-EUC0603 | C0603 | C93, C94, C95, C96, C101, C102, C103, C104, C109, C110, C111, C112, C117, C118, C119, C120 | CAPACITOR, European symbol
2 | 0.1u 50V | C-EUC0402 | C0402 | C131, C132 | CAPACITOR, European symbol
2 | 0.1u 63V | C-EUC0402 | C0402 | C130, C133 | CAPACITOR, European symbol
2 | 0.1uf 100V | C-EUC0805K | C0805K | C48, C51 | CAPACITOR, European symbol
1 | 0.33u | C-EUC0603 | C0603 | C22 | CAPACITOR, European symbol
4 | 0.47u | C-EUC0805 | C0805 | C13, C17, C21, C39 | CAPACITOR, European symbol
1 | 0826-1X1T-GJ-F | 0826-1X1T-GJ-F | MAGJACK-RJ45 | X8
2 | 1.0u | C-EUC0402 | C0402 | C89, C91 | CAPACITOR, European symbol
4 | 1.2k | R-US_R0402 | R0402 | R3, R6, R9, R19 | RESISTOR, American symbol
5 | 100n | C-EU0402-C-NOSILK | 0402-C-NOSILK | C54, C75, C76, C98, C99 | CAPACITOR, European symbol
1 | 100nF | C-EUC0805K | C0805K | C44 | CAPACITOR, European symbol
1 | 10k | R-US_R0402 | R0402 | R10 | RESISTOR, American symbol
2 | 10k | R-US_R0603 | R0603 | R14, R38 | RESISTOR, American symbol
1 | 10k | TRIM_US-3223W | 3223W | R54 | POTENTIOMETER
1 | 10m, 21mA | L-US0204V | 0204V | L2 | INDUCTOR, American symbol
9 | 10u | C-EUC1206 | C1206 | C10, C11, C14, C15, C18, C19, C24, C36, C37 | CAPACITOR, European symbol
1 | 10u | C-USC0402 | C0402 | C46 | CAPACITOR, American symbol
3 | 10u | CPOL-USB | PANASONIC_B | C30, C47, C125 | POLARIZED CAPACITOR, American symbol
1 | 150k | R-US_R0603 | R0603 | R13 | RESISTOR, American symbol
2 | 16p | C-USC0402 | C0402 | C43, C45 | CAPACITOR, American symbol
1 | 19.1k | R-US_R0402 | R0402 | R16 | RESISTOR, American symbol
2 | 1N4448 | 1N4448 | SOD-123 | D3, D5
3 | 1k | R-US_0402-C-NOSILK | 0402-C-NOSILK | R55, R56, R59 | RESISTOR, American symbol
3 | 1k | R-US_R0603 | R0603 | R23, R24, R_LED | RESISTOR, American symbol
5 | 1u | C-EUC0805 | C0805 | C12, C16, C20, C38, C55 | CAPACITOR, European symbol
1 | 2.2M | R-US_R0603 | R0603 | R99 | RESISTOR, American symbol
4 | 2.2k | R-US_R0402 | R0402 | R2, R5, R8, R18 | RESISTOR, American symbol
1 | 2.2u | C-EU0402-C-NOSILK | 0402-C-NOSILK | C77 | CAPACITOR, European symbol
2 | 2.2u | C-EUC0402 | C0402 | C86, C87 | CAPACITOR, European symbol
1 | 2.43k | R-US_R0603 | R0603 | R15 | RESISTOR, American symbol
16 | 200 | R-US_R0603 | R0603 | R37, R39, R40, R41, R42, R43, R44, R45, R46, R47, R48, R49, R50, R51, R52, R53 | RESISTOR, American symbol
2 | 22 | R-US_R0402 | R0402 | R21, R22 | RESISTOR, American symbol
2 | 22u | C-EU1206-C | 1206-C | C73, C97 | CAPACITOR, European symbol
8 | 22u | C-EUC1206 | C1206 | C1, C2, C3, C26, C27, C40, C72, C128 | CAPACITOR, European symbol
1 | 22u 50V | CPOL-USB | PANASONIC_B | C34 | POLARIZED CAPACITOR, American symbol
1 | 22u 63V | C-EUC1206 | C1206 | C129 | CAPACITOR, European symbol
1 | 249k | R-US_R0603 | R0603 | R12 | RESISTOR, American symbol
6 | 33 | R-US_0402-C-NOSILK | 0402-C-NOSILK | R34, R35, R62, R63, R64, R67 | RESISTOR, American symbol
9 | 33 | R-US_R0402 | R0402 | R20, R32, R33, R57, R58, R61, R65, R66, R68 | RESISTOR, American symbol
1 | 34k | R-US_R0603 | R0603 | R11 | RESISTOR, American symbol
1 | 4.7u | C-EUC0603 | C0603 | C85 | CAPACITOR, European symbol
1 | 4700p | C-EUC0402 | C0402 | C33 | CAPACITOR, European symbol
1 | 47u 16V | CPOL-USB | PANASONIC_B | C35 | POLARIZED CAPACITOR, American symbol
1 | 47u 50V | CPOL-USB | PANASONIC_B | C135 | POLARIZED CAPACITOR, American symbol
1 | 47uf 100V | C-EUC0805K | C0805K | C50 | CAPACITOR, European symbol
1 | 6.49k | R-US_0402-C-NOSILK | 0402-C-NOSILK | R60 | RESISTOR, American symbol
4 | 680 | R-US_R0402 | R0402 | R1, R4, R7, R17 | RESISTOR, American symbol
7 | 750 | R-US_R0402 | R0402 | R25, R26, R27, R28, R29, R30, R31 | RESISTOR, American symbol
4 | AD7685RM-10 | AD7685RM-10 | MSOP-10 | ADC1, ADC2, ADC3, ADC4
2 | AD8616R-8 | AD8616R-8 | SOIC8 | OPAMP1, OPAMP2
1 | ADR435RM-8 | ADR435RM-8 | SOIC8 | REF1
1 | CHB75W | CHB75W | CHB75W | POE
1 | COM08720 | COM08720 | COM08720 | SW1
1 | Debug Header | 1.27MM_HDR_2X5 | 1.27MM_2X5 | J22
1 | FB0805/600R/200mA(201209-601) | L-US0805-C-NOSILK | 0805-C-NOSILK | L3 | INDUCTOR, American symbol
1 | KSZ8081 | KSZ8081 | QFN-24 | U3
1 | LMZ14202HTZ | LMZ14202HTZ | PFM-7 | VR2
1 | MAX5984C | MAX5984 | TQFN-28 | IC2 |  |  |  |  |  |  | C
1 | MINI-USB-32005-301 | MINI-USB-32005-301 | 32005-301 | X4 | MINI USB-B Conector |  |  | unknown | unknown
1 | NU | C-EUC0402 | C0402 | C92 | CAPACITOR, European symbol
1 | SMAJ58A | SUPPRESSOR-SMBJ | SMBJ | D4 | Suppressor diode
1 | STM32F407ZXT | STM32F407ZXT | LQFP-100 | U1
2 | TERMINAL | TERMINAL | TERMINAL_RELAY | B+, GND
1 | TL751M08QKVURQ1 | TL751M08QKVURQ1 | PG-TO252-5-11 | VR3 | 8V power supply.
1 | TLE4275-QKVU | TLE4275-QKVU | PG-TO252-5-11 | VR8
1 | TLV1117-33IKVU | TLV1117-33IKVU | PG-TO252-3-11 | VR6
7 | TPTP06R | TPTP06R | TP06R | TP1, TP2, TP3, TP4, TP5, TP6, TP7 | Test pad
