psas/rocket-tracks/RTx_Main_Power/RTxChargerBOM.xlsx

Order Qty | Digi-Key Part Number | Notes | Value | Device | Package | Qty | Parts | Description
3 | 311-0.0LICT-ND |  | 0 | R-US_R1206 | R1206 | 1 | R3 | RESISTOR, American symbol
3 | TEH70P10R0JE-ND |  | 10 | TEH70 | TEH70 | 1 | R_CHARGE
3 | 311-10.0KFRCT-ND |  | 10k | R-US_R1206 | R1206 | 1 | R1 | RESISTOR, American symbol
3 | 311-226KFRCT-ND | Using 226k resistor which is a standard size down | 230k | R-US_R1206 | R1206 | 1 | R2 | RESISTOR, American symbol
3 | 497-4420-5-ND |  | STW11NM80 | STW11NM80 | TO-247 | 1 | Q1 | N-Channel MOSFET transistor
3 | 296-10168-1-ND |  | TL331 | TL331 | DBV-R-PDSO-G5 | 1 | IC1 | SINGLE DIFFERENTIAL COMPARATOR
3 | WA-T247-101E-ND |  | WA-T247-101E | WA-T247-101E | WA-T247-101E | 1 | HEATSINK | HEATSINK
3 | F5187-ND |  | ATO_FUSEHOLDER | FUSEATO_FUSEHOLDER | ATO_BLADE_FUSE | 1 | FUSE | Fuse Holder
3 | Z962-ND |  | G4W-1114P-US-TV8-HP | G4W-1114P-US-TV8-HP | G4W-1114P-US-TV8-HP | 1 | RELAY | SPST Relay
1 | AE10114-ND |  |  | D-Sub for enclosure
