psas/rocket-tracks/RTx_Manual_Control/RTxManualControlBOM.xlsx

RTx ID | Order Qty | Order PN | Notes | Value | Device | Package | Qty | Parts | Description
 | 21 | 311-1376-1-ND |  | 10u | C-EUC1206 | C1206 | 7 | C1, C2, C3, C4, C5, C6, C10 | CAPACITOR, European symbol
 | 10 | 311-1181-1-ND |  | 1u | C-EUC1206 | C1206 | 3 | C7, C8, C9 | CAPACITOR, European symbol
 | 10 | 311-10.0KFRCT-ND |  | 10k | R-US_R1206 | R1206 | 3 | R14, R15, R16 | RESISTOR, American symbol
 | 10 | 311-1.00KFRCT-ND |  | 1k | R-US_R1206 | R1206 | 3 | R9, R12, R13 | RESISTOR, American symbol
 | 18 | 311-280FRCT-ND |  | 280 | R-US_R1206 | R1206 | 6 | R5, R6, R7, R8, R10, R11 | RESISTOR, American symbol
 | 12 | 311-620FRCT-ND |  | 620 | R-US_R1206 | R1206 | 4 | R1, R2, R3, R4 | RESISTOR, American symbol
 | 6 | 609-3406-ND |  |  | PINHD-1X6 | 1X06 | 2 | JP1, JP6 | PIN HEADER
 | 6 | S7039-ND |  |  | Female-1X6
 | 6 | 609-3406-ND |  |  | PINHD-1X8 | 1X08 | 2 | JP5, JP10 | PIN HEADER
 | 6 | S7041-ND |  |  | Female-1X8
 | 3 | S9407-ND |  | Drive Enable | PINHD-1X2 | 1X02 | 1 | JP4 | PIN HEADER
 | 3 | S9435-ND |  |  | Female-1X2
 | 6 | S9414-ND | SWR25X |  | PINHD-1X6 Polarized | 1X06 | 2 | JP7, JP8 | PIN HEADER POLARIZED
 | 6 | S9436-ND | SWH25X |  | Female-1X6 Polarized
 | 6 | 609-2845-ND |  |  | PINHD-2X3 Polarized | 2X03 | 2 | JP2, JP9 | PIN HEADER POLARIZED
 | 6 | 609-2841-ND |  |  | Female-2X3 Polarized
 | 3 | S9411-ND | SWR25X | Neutral LEDs | PINHD-1X3 Polarized | 1X03 | 1 | JP3 | PIN HEADER POLARIZED
 | 3 | S9434-ND | SWH25X |  | Female-1X3 Polarized
