psas/rocket-tracks/Documentation/Hardware/Power Requirements - Controller Board.xlsx

Sheet: Power Supplies
Power Supplies | Device | Input Voltage (V) |  |  | Output Voltage (V) |  |  | Output Current (mA)
 |  | Min | Typ | Max | Min | Typ | Max | Min | Typ | Max
Analog/Logic Power Supply (3.3V) | TLE4476D | 4.5 | - | 42.0 | 3.17 | 3.3 | 3.43 | 350.0 | - | 900.0
Analog/Logic Power Supply (5.0V) | TLE4476D | 5.7 | - | 42.0 | 4.8 | 5.0 | 5.2 | 430.0 | - | 900.0
Analog Reference Voltage Regulator (5.000V) | ADR435RM-8 | 7.0 | - | 18.0 | 4.998 | 5.000 | 5.002 | -20.0 | - | 30.0
Analog Reference Voltage Regulator (8.0V) | TL751M08QKVURQ1 | 9.0 | 12.0 | 26.0 | 7.76 | 8.00 | 8.24 | 5.0 | 60.0 | 75.0
Main Switching Power Supply (12V) | LMZ14202HTZ | 6.0 | - | 42.0 | 5.0 | - | 30.0 | 2400.0 | 3200.0 | 3950.0
PoE Power Supply (48V) | CHB75W-24S48-C | 9.0 | - | 36.0 |  | 48.0 |  | 0.0 | - | 1560.0

Sheet: Devices
Part Description | Device | Required Voltage (V) |  |  | Required Current (mA) | Power Dissipation (mW) | Switcher/ LDO
 |  | Min | Nom | Max
ADC | AD768RM-10 | 2.3 | 5.0 | 5.5 | 3.0 | 15 | LDO
ADC | AD768RM-10 | 2.3 | 5.0 | 5.5 | 3.0 | 15 | LDO
ADC | AD768RM-10 | 2.3 | 5.0 | 5.5 | 3.0 | 15 | LDO
ADC | AD768RM-10 | 2.3 | 5.0 | 5.5 | 3.0 | 15 | LDO
OPAMP | AD8616R-8 | 2.7 |  | 5.5 | 150.0 |  | LDO
OPAMP | AD8616R-8 | 2.7 |  | 5.5 | 150.0 |  | LDO
OPAMP | AD8616R-8 | 2.7 |  | 5.5 | 150.0 |  | LDO
OPAMP | AD8616R-8 | 2.7 |  | 5.5 | 150.0 |  | LDO
MICROCONTROLLER | STM32F407 | 1.8 | 3.3 | 3.6 | 152.0 | 500 | LDO
ETHERNET PHY | KSZ8081 | 3.13 | 3.3 | 3.46 | 47.00 | 155 | LDO
PoE REGULATOR | MAX5984C | 32.0 | 54.0 | 60.0 | 740.0 | 40000 | Switcher
