psas/rocket-tracks/Generic_Motor_Driver_Board/Generic_Motor_Driver_HDL/RocketTracks/h_bridge_pad.csv

Release 8.1i - Fit O.61xd
Copyright(c) 1995-2003 Xilinx Inc. All rights reserved
8-29-2011 9:33PM
NOTE: This file is designed to be imported into a spreadsheet program
such as Microsoft Excel for viewing | printing and sorting. The comma ' | '
character is used as the data field separator.
This file is also designed to support parsing.
Input file: h_bridge.ngd
output file: h_bridge_pad.csv
Part type: xc9572xl
Speed grade: -7
Package: vq44
Pinout by Pin Number:
----- | ----- | ----- | ----- | ----- | ----- | ----- | ----- | ----- | -----
Pin Number | Signal Name | Pin Usage | Pin Name | Direction | IO Standard | IO Bank Number | {blank} | Slew Rate | Termination | {blank} | Voltage | Constraint
P1 | TIE |  | I/O/GCK3
P2 | TIE |  | I/O
P3 | TIE |  | I/O
P4 | GND |  | GND
P5 | sw3_n | O | I/O | OUTPUT
P6 | TIE |  | I/O
P7 | TIE |  | I/O
P8 | enable | I | I/O | INPUT
P9 | TDI |  | TDI
P10 | TMS |  | TMS
P11 | TCK |  | TCK
P12 | TIE |  | I/O
P13 | sw3_p | O | I/O | OUTPUT
P14 | TIE |  | I/O
P15 | VCC |  | VCCINT
P16 | TIE |  | I/O
P17 | GND |  | GND
P18 | TIE |  | I/O
P19 | sw1_n | O | I/O | OUTPUT
P20 | TIE |  | I/O
P21 | TIE |  | I/O
P22 | TIE |  | I/O
P23 | TIE |  | I/O
P24 | TDO |  | TDO
P25 | GND |  | GND
P26 | VCC |  | VCCIO
P27 | TIE |  | I/O
P28 | sw1_input | I | I/O | INPUT
P29 | sw1_p | O | I/O | OUTPUT
P30 | TIE |  | I/O
P31 | sw2_input | I | I/O | INPUT
P32 | sw2_n | O | I/O | OUTPUT
P33 | sw3_input | I | I/O/GSR | INPUT
P34 | watchdog | I | I/O/GTS2 | INPUT
P35 | VCC |  | VCCINT
P36 | TIE |  | I/O/GTS1
P37 | TIE |  | I/O
P38 | TIE |  | I/O
P39 | sw2_p | O | I/O | OUTPUT
P40 | TIE |  | I/O
P41 | TIE |  | I/O
P42 | TIE |  | I/O
P43 | clk | GCK | I/O/GCK1
P44 | TIE |  | I/O/GCK2
To preserve the pinout above for future design iterations in
Project Navigator simply execute the (Lock Pins) process
located under the (Implement Design) process in a toolbox named
(Optional Implementation Tools) or invoke PIN2UCF from the
command line. The location constraints will be written into your
specified UCF file
