psas/rocket-tracks/Documentation/Test plan.xlsx

Hardware, Firmware and System Integration Testing
Power supplies within voltages specifications
Device: | Acceptable Range (volts): | Passed:
TLE4476D | 3.17 - 3.43
TLE4476D | 4.8 - 5.2
ADR435RM-8 | 4.998 - 5.002
TL751M08QKVURQ1 | 7.76 - 8.24
LMZ14202HTZ | 11 - 13
CHB75W-24S48-C | 46 - 52
Devices power up
Device: | Power up state | Passed:
MCU | On
Ethernet PHY | On
PoE Controller | On
ADCs | On
Proper communication between devices:
Devices: | Communication: | Passed:
Motor Axis Pos Sensors to ADCs | Analog reference
ADCs to MCU | SPI
Ethernet PHY to Ethernet Switch | Ethernet
Sightline to Laptop | Ethernet
Sightline to Ethernet Switch | Ethernet
Sightline to Controller board | Ethernet
PoE Controller to Ethernet Switch | PoE+
MCU to GMDs | PWM
MCU to Ethernet PHY | RMII mode
MCU to USB | USB
RTx Controller Board
Functionality: | Expected outcome: | Passed:
Ethernet Switch
PoE: |  | Passed:
Powers on from injector
Provides power to splitter
Powers on from controller board
Provides power to splitter
Communication:
Links a laptop, Sightline and controller board
Sightline Communications:
Connection: | Data | Passed:
Laptop to Sightline | Command packets
Sightline to Controller board | Pixel position packets
RTx Controller Firmware
Timer Callbacks: | Expected outcome: | Passed:
ADC Conversion timer | Callback function begins
Control Loop timer | Callback function begins
SPI: | Expected outcome:
ADC DONE interrupt | Interrupt callback begins
SPI read | SPI read fetches ADC data
Ethernet: | Expected outcome:
Receive from Manual | Manual Packets Received
Receive from SLA | SLA Packets Received
Send to Manual | Manual Packets Sent
Digital Outputs: | Expected outcome:
PWM | PWM Outputs to GMD
Enable | Enable Outputs to GMD
Watchdog | Watchdog Outputs to GMD
Manual Control Box Firmware
Timer Callbacks: | Expected outcome: | Passed:
ADC Conversion timer | Callback function begins
Control Loop timer | Callback function begins
ADC: | Expected outcome:
ADC Conversion Callback | Interrupt callback begins
ADC Results | ADC results in range
Ethernet: | Expected outcome:
Receive from RTx | RTx Packets Received
Send to RTx | Manual Packets Sent
LED Outputs: | Expected outcome:
Neutral | Neutral LEDs Operate
Mode | Mode LEDs Operate
Aux | Aux LEDs Operate
Digital Inputs: | Expected outcome:
Enable | Enable State Correct
Mode | Mode State Correct
Aux | Aux State Correct
