psas/rocket-tracks/Documentation/FMEA/fmea_external.xlsx

Sheet: FMEA - RTx Controller
RTx Controller Board FMEA Analysis - External Influences
FMEA Ref. # | Item | Potential failure mode | Potential cause(s) | local effects of failure | next higher level effect | system level end effect | (P) Probability (estimate) | (S) Severity | Risk Level | Actions for further Investigation | Mitigation / Requirements | Fix in FW
 |  | person gets too close |  |  |  | injury | B | VI | Unacceptable |  | Create e-stop perimeter also plug in away box to controller box before plugging in batteries to away box
 |  | Something breaks and comes flying off |  |  |  | injury | A | VI | High |  | will be addressed by safety protocol - have people remain a certain distance away
 |  | dropping the unit |  |  |  | permanent damage | C | VI | Unacceptable
 |  | hooking up battery in reverse (from batteries to away box) |  |  |  | permanent damage | C | VI | Unacceptable |  | polarized connectors
 |  | hook up power in reverese (from that away to controller box) |  |  |  | permanent damage | C | VI | Unacceptable |  | polarized connectors
 |  | something gets stuck in the chain |  |  |  | permanent damage or injury | A | VI | High |  | If driving at max torque for greater than certain length of time remove power to motor? | Y

Sheet: KEY
Probability |  | Risk Level
Rating | Meaning | Probability \ Severity | I | II | III | IV | V | VI
A | Extremely Unlikely (Virtually impossible or No known occurrences on similar products or processes, with many running hours) | A | Low | Low | Low | Low | Moderate | High
B | Remote (Relatively few failures) | B | Low | Low | Low | Moderate | High | Unacceptable
C | Occasioinal (occasional failures) | C | Low | Low | Moderate | Moderate | High | Unacceptable
D | Reasonably Possible (repeated failures) | D | Low | Moderate | Moderate | High | Unacceptable | Unacceptable
E | Frequent (failure is almost inevitable) | E | Moderate | Moderate | High | Unacceptable | Unacceptable | Unacceptable
Severity (note: only grading on safety)
Rating | Meaning
I | No relevant effect on reliability or safety
II | Very minor, no damage, no injuries, only results in a maintenance action (only noticed by discriminating customers)
III | Minor, low damage, light injuries (affects very little of the system, noticed by average customer)
IV | Moderate, moderate damage, injuries possible (most customers are annoyed, mostly financial damage)
V | Critical (causes a loss of primary function; Loss of all safety Margins, 1 failure away from a catastrophe, severe damage, severe injuries, max 1 possible death )
VI | Catastrophic (product becomes inoperative; the failure may result complete unsafe operation and possible multiple deaths)
Detection
Rating | Meaning
1 | Certain - fault will be caught on test
2 | Almost certain
3 | High
4 | Moderate
5 | Low
6 | Fault is undetected by Operators or Maintainers
