psas/rocket-tracks/Documentation/FMEA/fmea_system_level.xlsx

Sheet: FMEA - RTx Controller
System Level FMEA
I. RTx Controller Board
FMEA Ref. # | Signal | Input/Output/Supply | Potential failure mode | local effects of failure | next higher level effect | system level end effect | (P) Probability (estimate) | (S) Severity | Risk Level | Actions for further Investigation | Mitigation / Requirements | Fix in FW
SYS-1 | Battery Voltage (+) | Supply | Too High | CHB75W Fails, LMZ1402 Fails | everything fails | damaged system | A | V | Moderate |  |  | N
SYS-2 | Battery Voltage (+) | Supply | Too Low |  | nothing turns on |  | A | I | Low |  |  | N
SYS-3 | Battery Voltage (+) | Supply | disconnected at board | no current | motor drivers will be powered up but the controller that drives its signals will not |  | A | II | Low |  |  | N
SYS-4 | Battery GND | Supply | disconnected at board | no current | motor drivers will be powered up but the controller that drives its signals will not |  | A | II | Low |  |  | N
SYS-5 | USB_VBUS | input | Too high (>VDD+4V) |  | pin PA9 fried |  | A | I | Low |  |  | N
SYS-6 | USB D+ | input |  | usb doesn't work | no damage |  | A | I | Low |  |  | N
SYS-7 | USB D- | input |  | usb doesn't work | no damage |  | A | I | Low |  |  | N
SYS-8 | USB_ID | input |  | usb doesn't work | no damage |  | A | I | Low |  |  | N
SYS-9 | USB GND | Supply |  | usb doesn't work | no damage |  | A | I | Low |  |  | N
SYS-10 | POE+ | Supply |  | no POE | no damage |  | A | I | Low |  |  | N
SYS-11 | PSE_OUTPUT | Supply |  | no POE | no damage |  | A | I | Low |  |  | N | notes: the case where ethernet commands are not being received from manual controlled needs to be addressed in firmware
SYS-12 | TX+ | output |  | wouldn't provide neutral indication | no damage |  | A | I | Low |  |  | N | tx - sends neutral axis indicators to manual controller to turn on leds indicating access is neutral
SYS-13 | TX- | output |  | wouldn't provide neutral indication | no damage |  | A | I | Low |  |  | N | rx - manual: enable for whole system
SYS-14 | RX+ | input |  | wouldn't receive position data from sightline, or manual controller, wouldn't receive mode data | unpredicatable motion of axes |  | A | VI | High |  | need to have a firmware fix that verifies we are receiving information via ethernet before altering position of axes | Y | - mode - manual or sightline
SYS-15 | RX- | input |  | wouldn't receive position data from sightline, or manual controller, wouldn't receive mode data | unpredicatable motion of axes |  | A | VI | High |  | need to have a firmware fix that verifies we are receiving information via ethernet before altering position of axes | Y | - position data - desired position data
SYS-16 | Ethernet GND | Supply |  | wouldn't receive position data from sightline, or manual controller, wouldn't receive mode data | unpredicatable motion of axes |  | A | VI | High |  | need to have a firmware fix that verifies we are receiving information via ethernet before altering position of axes | Y | - pixel data from sightline
SYS-17 | Lat_axis_in | input | would read 0 | think the actual position is whatever corresponds to 0 and will try to drive the axis away from that postion |  |  | A | VI | High |  | check for out of range values in FW | Y
SYS-18 | Vert_axis_in | input | would read 0 | think the actual position is whatever corresponds to 0 and will try to drive the axis away from that postion |  |  | A | VI | High |  | check for out of range values in FW | Y
SYS-19 | axis3_in | input | would read 0 | think the actual position is whatever corresponds to 0 and will try to drive the axis away from that postion |  |  | A | VI | High |  | check for out of range values in FW | Y
SYS-20 | axis4_in | input | would read 0 | think the actual position is whatever corresponds to 0 and will try to drive the axis away from that postion |  |  | A | VI | High |  | check for out of range values in FW | Y
SYS-21 | Lat_axis_agnd | Supply | would read high | think the actual position is whatever corresponds to high and will try to drive the axis away from that postion |  |  | A | VI | High |  | check for out of range values in FW | Y | notes: what happenes if potentiomeer gets into a dead zone
SYS-22 | vert_axis_agnd | Supply | would read high | think the actual position is whatever corresponds to high and will try to drive the axis away from that postion |  |  | A | VI | High |  | check for out of range values in FW | Y
SYS-23 | axis3_agnd | Supply | would read high | think the actual position is whatever corresponds to high and will try to drive the axis away from that postion |  |  | A | VI | High |  | check for out of range values in FW | Y
SYS-24 | axis4_agnd | Supply | would read high | think the actual position is whatever corresponds to 0 and will try to drive the axis away from that postion |  |  | A | VI | High |  | check for out of range values in FW | Y
SYS-25 | lat_axis_aref | Supply | would read 0 | think the actual position is whatever corresponds to 0 and will try to drive the axis away from that postion |  |  | A | VI | High |  | check for out of range values in FW | Y
SYS-26 | vert_axis_aref | Supply | would read 0 | think the actual position is whatever corresponds to 0 and will try to drive the axis away from that postion |  |  | A | VI | High |  | check for out of range values in FW | Y
SYS-27 | axis3_aref | Supply | would read 0 | think the actual position is whatever corresponds to 0 and will try to drive the axis away from that postion |  |  | A | VI | High |  | check for out of range values in FW | Y
SYS-28 | axis4_aref | Supply | would read 0 | think the actual position is whatever corresponds to 0 and will try to drive the axis away from that postion |  |  | A | VI | High |  | check for out of range values in FW | Y
SYS-29 | PWM_AXIS3_V_OUT | output | stuck high | could drive motor in a direction at max torque |  |  | A | VI | High |  |  | Y
SYS-30 | PWM_AXIS3_U_OUT | output | stuck high | could drive motor in a direction at max torque |  |  | A | VI | High |  |  | Y
SYS-31 | PWM_AXIS4_V_OUT | output | stuck high | could drive motor in a direction at max torque |  |  | A | VI | High |  |  | Y
SYS-32 | PWM_AXIS4_U_OUT | output | stuck high | could drive motor in a direction at max torque |  |  | A | VI | High |  |  | Y
SYS-33 | ENABLE_AXIS3_OUT | output | stuck high | could drive motor in a direction at max torque |  |  | A | VI | High |  |  | Y
SYS-34 | WATCHDOG_AXIS3_OUT | output | stuck high | could drive motor in a direction at max torque |  |  | A | VI | High |  |  | Y
SYS-35 | ENABLE_AXIS4_OUT | output | stuck high | could drive motor in a direction at max torque |  |  | A | VI | High |  |  | Y
SYS-36 | WATCHDOG_AXIS4_OUT | output | stuck high | could drive motor in a direction at max torque |  |  | A | VI | High |  |  | Y
SYS-37 | WATCHDOG_VERT_OUT | output | stuck high | could drive motor in a direction at max torque |  |  | A | VI | High |  |  | Y
SYS-38 | ENABLE_VERT_OUT | output | stuck high | could drive motor in a direction at max torque |  |  | A | VI | High |  |  | Y
SYS-39 | WATCHDOG_LAT_OUT | output | stuck high | could drive motor in a direction at max torque |  |  | A | VI | High |  |  | Y
SYS-40 | ENABLE_LAT_OUT | output | stuck high | could drive motor in a direction at max torque |  |  | A | VI | High |  |  | Y
SYS-41 | PWM_VERT_V_OUT | output | stuck high | could drive motor in a direction at max torque |  |  | A | VI | High |  |  | Y
SYS-42 | PWM_VERT_U_OUT | output | stuck high | could drive motor in a direction at max torque |  |  | A | VI | High |  |  | Y
SYS-43 | PWM_LAT_V_OUT | output | stuck high | could drive motor in a direction at max torque |  |  | A | VI | High |  |  | Y
SYS-44 | PWM_LAT_U_OUT | output | stuck high | could drive motor in a direction at max torque |  |  | A | VI | High |  |  | Y
SYS-45 | PWM_AXIS3_V_OUT | output | stuck low | will not be able to drive motor in one of two directions |  |  | A | I | Low |  |  | N
SYS-46 | PWM_AXIS3_U_OUT | output | stuck low | will not be able to drive motor in one of two directions |  |  | A | I | Low |  |  | N
SYS-47 | PWM_AXIS4_V_OUT | output | stuck low | will not be able to drive motor in one of two directions |  |  | A | I | Low |  |  | N
SYS-48 | PWM_AXIS4_U_OUT | output | stuck low | will not be able to drive motor in one of two directions |  |  | A | I | Low |  |  | N
SYS-49 | ENABLE_AXIS3_OUT | output | stuck low | motors wont work |  |  | A | I | Low |  |  | N
SYS-50 | WATCHDOG_AXIS3_OUT | output | stuck low | motors wont work |  |  | A | I | Low |  |  | N
SYS-51 | ENABLE_AXIS4_OUT | output | stuck low | motors wont work |  |  | A | I | Low |  |  | N
SYS-52 | WATCHDOG_AXIS4_OUT | output | stuck low | motors wont work |  |  | A | I | Low |  |  | N
SYS-53 | WATCHDOG_VERT_OUT | output | stuck low | motors wont work |  |  | A | I | Low |  |  | N
SYS-54 | ENABLE_VERT_OUT | output | stuck low | motors wont work |  |  | A | I | Low |  |  | N
SYS-55 | WATCHDOG_LAT_OUT | output | stuck low | motors wont work |  |  | A | I | Low |  |  | N
SYS-56 | ENABLE_LAT_OUT | output | stuck low | motors wont work |  |  | A | I | Low |  |  | N
SYS-57 | PWM_VERT_V_OUT | output | stuck low | will not be able to drive motor in one of two directions |  |  | A | I | Low |  |  | N
SYS-58 | PWM_VERT_U_OUT | output | stuck low | will not be able to drive motor in one of two directions |  |  | A | I | Low |  |  | N
SYS-59 | PWM_LAT_V_OUT | output | stuck low | will not be able to drive motor in one of two directions |  |  | A | I | Low |  |  | N
SYS-60 | PWM_LAT_U_OUT | output | stuck low | will not be able to drive motor in one of two directions |  |  | A | I | Low |  |  | N
SYS-61 | PWM_LAT_GND1 | Supply | disconected | motors wont work |  |  | A | I | Low |  |  | N
SYS-62 | PWM_LAT_GND2 | Supply | disconected | motors wont work |  |  | A | I | Low |  |  | N
SYS-63 | PWM_VERT_GND1 | Supply | disconected | motors wont work |  |  | A | I | Low |  |  | N
SYS-64 | PWM_VERT_GND2 | Supply | disconected | motors wont work |  |  | A | I | Low |  |  | N
SYS-65 | PWM_AXIS3_GND1 | Supply | disconected | motors wont work |  |  | A | I | Low |  |  | N
SYS-66 | PWM_AXIS3_GND2 | Supply | disconected | motors wont work |  |  | A | I | Low |  |  | N
SYS-67 | PWM_AXIS4_GND1 | Supply | disconected | motors wont work |  |  | A | I | Low |  |  | N
SYS-68 | PWM_AXIS4_GND2 | Supply | disconected | motors wont work |  |  | A | I | Low |  |  | N
II. Precharge Board
FMEA Ref. # | Signal | Input/Output | Potential failure mode | local effects of failure | next higher level effect | system level end effect | (P) Probability (estimate) | (S) Severity | Risk Level | Actions for further Investigation | Mitigation / Requirements | Fix in FW
 | E-STOP_SWITCHED | Supply | high | the system would receive power
 | E-STOP_SWITCHED | Supply | low | capcitors will not be charged | no power to system
 | BAT+_SWITCHED | Supply | low | nothing for comparator to compare against | cause a spike in current to the capacitors only if there was also a short between that signal and gnd before the batteries are plugged in so this is not a single point of failure | cause a big spark
 | GND | Supply |  | nothing would turn on |  |  |  |  |  |  | remove power to stop system
 | E-STOP_IN | input | shorted out | e-stop would not work
 | HC_RELAY- | input
 | BAT_SWITCHED | Supply |  | relay2 would not turn on | system would not receive power
 | E-STOP_PWR | Supply |  | e-stop would not work to turn off system |  |  |  |  |  |  | remove power to stop system
 | CAP+ | Supply |  | capcitors wouldn't charge
 | RELAY2- | Output |  | capcitors would remain in a continual precharge state
III. Sightline
FMEA Ref. # | Signal | Input/Output | Potential failure mode | local effects of failure | next higher level effect | system level end effect | (P) Probability (estimate) | (S) Severity | Risk Level | Actions for further Investigation | Mitigation / Requirements | Fix in FW
SYS-78 | Power | supply |  | would not receive position data from sightline | if in automatic mode could result in unpredicatable motion of axes |  | A | VI | High |  |  | Y
SYS-79 | GND | supply |  | would not receive position data from sightline | if in automatic mode could result in unpredicatable motion of axes |  | A | VI | High |  |  | Y
SYS-80 | TX+ |  |  | lose position data from sightline | if in automatic mode could result in unpredicatable motion of axes |  | A | VI | High |  |  | Y
SYS-81 | TX- |  |  | lose position data from sightline | if in automatic mode could result in unpredicatable motion of axes |  | A | VI | High |  |  | Y | notes: sitghtline uses tx but not rx with our system
SYS-82 | RX+ |  |  | lose the ability to configure the sightline device, wouldn't be able to track |  |  | A | I | Low |  |  | N
SYS-83 | RX- |  |  | lose the ability to configure the sightline device, wouldn't be able to track |  |  | A | I | Low |  |  | N
IV. Manual Remote Board
FMEA Ref. # | Signal | Input/Output | Potential failure mode | local effects of failure | next higher level effect | system level end effect | (P) Probability (estimate) | (S) Severity | Risk Level | Actions for further Investigation | Mitigation / Requirements | Fix in FW
SYS-84 | DRIVE_ENABLE_IN | Input | stuck high |  | can't disable the system |  | A | VI | High |  | If this occurs emergency stop required to remove power | N
SYS-85 | DRIVE_ENABLE_IN | Input | stuck low |  | can't enable system |  | A | I | Low |  |  | N
SYS-86 | VERT_AXIS_AGND | Supply |  | would read high | will think you want to drive it to whatever position corresponds to high |  | A | VI | High |  | need to check for out of range values | Y
SYS-87 | VERT_AXIS_AREF | Supply |  | would read 0 | will think you want to drive it to whatever position corresponds to 0 |  | A | VI | High |  | need to check for out of range values | Y
SYS-88 | VERT_AXIS_ADC | Input |  | would read 0 | will think you want to drive it to whatever position corresponds to 0 |  | A | VI | High |  | need to check for out of range values | Y
SYS-89 | LAT_AXIS_AGND | Supply |  | would read high | will think you want to drive it to whatever position corresponds to high |  | A | VI | High |  | need to check for out of range values | Y
SYS-90 | LAT_AXIS_AREF | Supply |  | would read 0 | will think you want to drive it to whatever position corresponds to 0 |  | A | VI | High |  | need to check for out of range values | Y
SYS-91 | LAT_AXIS_ADC | Input |  | would read 0 | will think you want to drive it to whatever position corresponds to 0 |  | A | VI | High |  | need to check for out of range values | Y
SYS-92 | MODE_SWITCH_IN | Input | stuck high | stuck in one of the two modes |  |  | A | I | Low |  |  | N
SYS-93 | MODE_SWITCH_IN | Input | stuck low | stuck in one of the two modes |  |  | A | I | Low |  |  | N
SYS-94 | AUX_SWITCH_IN | Input | stuck high | stuck in one of two aux |  |  | A | I | Low |  |  | N
SYS-95 | AUX_SWITCH_IN | Input | stuck low | stuck in one of two aux |  |  | A | I | Low |  |  | N
SYS-96 | AXIS3_AGND | Supply |  | would read high | will think you want to drive it to whatever position corresponds to high |  | A | VI | High |  | need to check for out of range values | Y
SYS-97 | AXIS3_AREF | Supply |  | would read 0 | will think you want to drive it to whatever position corresponds to 0 |  | A | VI | High |  | need to check for out of range values | Y
SYS-98 | AXIS3_ADC | Input |  | would read 0 | will think you want to drive it to whatever position corresponds to 0 |  | A | VI | High |  | need to check for out of range values | Y
SYS-99 | AXIS4_AGND | Supply |  | would read high | will think you want to drive it to whatever position corresponds to high |  | A | VI | High |  | need to check for out of range values | Y
SYS-100 | AXIS4_AREF | Supply |  | would read 0 | will think you want to drive it to whatever position corresponds to 0 |  | A | VI | High |  | need to check for out of range values | Y
SYS-101 | AXIS4_ADC | Input |  | would read 0 | will think you want to drive it to whatever position corresponds to 0 |  | A | VI | High |  | need to check for out of range values | Y
SYS-102 | MODE1_LED | Output |  | don't have confirmation of mode selection |  |  | A | I | Low |  |  | N
SYS-103 | MODE2_LED | Output |  | don't have confirmation of aux selection |  |  | A | I | Low |  |  | N
SYS-104 | AUX1_LED | Output |  | don't have confirmation of aux selection |  |  | A | I | Low |  |  | N
SYS-105 | AUX2_LED | Output |  | don't have confirmation of mode selection |  |  | A | I | Low |  |  | N
SYS-106 | USB power | Supply |  | unable to communicate with main RTx controller. | Wouldn't be able to communicate mode or position data |  | A | VI | High |  |  | Y
SYS-107 | USB GND | Supply |  | unable to communicate with main RTx controller. | Wouldn't be able to communicate mode or position data |  | A | VI | High |  |  | Y
SYS-108 | tx+ | Output |  | unable to communicate with main RTx controller. | Wouldn't be able to communicate mode or position data |  | A | VI | High |  |  | Y
SYS-109 | tx- | Output |  | unable to communicate with main RTx controller. | Wouldn't be able to communicate mode or position data |  | A | VI | High |  |  | Y
SYS-110 | rx+ | Input |  | wouldn't receive data via ethernet | neutral position indicator would not work |  | A | I | Low |  |  | N
SYS-111 | rx- | Input |  | wouldn't receive data via ethernet | neutral position indicator would not work |  | A | I | Low |  |  | N
SYS-112 | ethernet GND | Supply |  | unable to communicate with main RTx controller. | Wouldn't be able to communicate mode or position data |  | A | VI | High |  |  | Y
V. Motor Driver Board
FMEA Ref. # | Signal | Input/Output | Potential failure mode | local effects of failure | next higher level effect | system level end effect | (P) Probability (estimate) | (S) Severity | Risk Level | Actions for further Investigation | Mitigation / Requirements | Fix in FW
SYS-113 | PWM_AXIS3_V_OUT | input | stuck high | could drive motor in a direction at max torque |  |  | A | VI | High |  |  | Y
SYS-114 | PWM_AXIS3_U_OUT | input | stuck high | could drive motor in a direction at max torque |  |  | A | VI | High |  |  | Y
SYS-115 | PWM_AXIS4_V_OUT | input | stuck high | could drive motor in a direction at max torque |  |  | A | VI | High |  |  | Y
SYS-116 | PWM_AXIS4_U_OUT | input | stuck high | could drive motor in a direction at max torque |  |  | A | VI | High |  |  | Y
SYS-117 | PWM_AXIS3_V_OUT | input | stuck low | will not be able to drive motor in one of two directions |  |  | A | I | Low |  |  | N
SYS-118 | PWM_AXIS3_U_OUT | input | stuck low | will not be able to drive motor in one of two directions |  |  | A | I | Low |  |  | N
SYS-119 | PWM_AXIS4_V_OUT | input | stuck low | will not be able to drive motor in one of two directions |  |  | A | I | Low |  |  | N
SYS-120 | PWM_AXIS4_U_OUT | input | stuck low | will not be able to drive motor in one of two directions |  |  | A | I | Low |  |  | N
SYS-121 | ENABLE_AXIS3_OUT | input | pulled low |  |  |  | A |  | Low |  |  | N
SYS-122 | ENABLE_AXIS3_OUT | input | pulled high |  |  |  | A |  |  |  | watchdog only toggles if enabled | Y
SYS-123 | WATCHDOG_AXIS3_OUT | input | stuck high or low |  |  |  | A |  |  |  |  | N
SYS-124 | WATCHDOG_AXIS3_OUT | input | stuck high or low |  |  |  | A |  |  |  |  | N
SYS-125 | ENABLE_AXIS4_OUT | input | pulled low |  |  |  | A |  |  |  |  | N
SYS-126 | ENABLE_AXIS4_OUT | input | pulled high |  |  |  | A |  |  |  | watchdog only toggles if enabled | Y
SYS-127 | WATCHDOG_AXIS4_OUT | input | stuck high or low |  |  |  | A |  |  |  |  | N
SYS-128 | WATCHDOG_AXIS4_OUT | input | stuck high or low |  |  |  | A |  |  |  |  | N
SYS-129 | WATCHDOG_VERT_OUT | input | stuck high or low |  |  |  | A |  |  |  |  | N
SYS-130 | WATCHDOG_VERT_OUT | input | stuck high or low |  |  |  | A |  |  |  |  | N
SYS-131 | ENABLE_VERT_OUT | input | pulled low |  |  |  | A |  |  |  |  | N
SYS-132 | ENABLE_VERT_OUT | input | pulled high |  |  |  | A |  |  |  | watchdog only toggles if enabled | Y
SYS-133 | WATCHDOG_LAT_OUT | input | stuck high or low |  |  |  | A |  |  |  |  | N
SYS-134 | WATCHDOG_LAT_OUT | input | stuck high or low |  |  |  | A |  |  |  |  | N
SYS-135 | ENABLE_LAT_OUT |  | pulled low |  |  |  | A |  |  |  |  | N
SYS-136 | ENABLE_LAT_OUT | input | pulled high |  |  |  | A |  |  |  | watchdog only toggles if enabled | Y
SYS-137 | PWM_VERT_V_OUT | input | stuck high | could drive motor in a direction at max torque |  |  | A | VI | High |  |  | Y
SYS-138 | PWM_VERT_U_OUT | input | stuck high | could drive motor in a direction at max torque |  |  | A | VI | High |  |  | Y
SYS-139 | PWM_LAT_V_OUT | input | stuck high | could drive motor in a direction at max torque |  |  | A | VI | High |  |  | Y
SYS-140 | PWM_LAT_U_OUT | input | stuck high | could drive motor in a direction at max torque |  |  | A | VI | High |  |  | Y
SYS-141 | PWM_VERT_V_OUT | input | stuck low | will not be able to drive motor in one of two directions |  |  | A | I | Low |  |  | N
SYS-142 | PWM_VERT_U_OUT | input | stuck low | will not be able to drive motor in one of two directions |  |  | A | I | Low |  |  | N
SYS-143 | PWM_LAT_V_OUT | input | stuck low | will not be able to drive motor in one of two directions |  |  | A | I | Low |  |  | N
SYS-144 | PWM_LAT_U_OUT | input | stuck low | will not be able to drive motor in one of two directions |  |  | A | I | Low |  |  | N
SYS-145 | CAP+ | Supply |  | can't drive motors |  |  | A | I | Low |  |  | N
VII. Battery Supply
FMEA Ref. # | Signal | Input/Output | Potential failure mode | local effects of failure | next higher level effect | system level end effect | (P) Probability (estimate) | (S) Severity | Risk Level | Actions for further Investigation | Mitigation / Requirements | Fix in FW
SYS-146 | Battery (+) | Supply |  | nothing works |  |  | A | I | Low |  |  | N
SYS-147 | Battery GND | Supply |  | nothing works |  |  | A | I | Low |  |  | N

Sheet: KEY
Probability |  | Risk Level
Rating | Meaning | Probability \ Severity | I | II | III | IV | V | VI
A | Extremely Unlikely (Virtually impossible or No known occurrences on similar products or processes, with many running hours) | A | Low | Low | Low | Low | Moderate | High
B | Remote (Relatively few failures) | B | Low | Low | Low | Moderate | High | Unacceptable
C | Occasioinal (occasional failures) | C | Low | Low | Moderate | Moderate | High | Unacceptable
D | Reasonably Possible (repeated failures) | D | Low | Moderate | Moderate | High | Unacceptable | Unacceptable
E | Frequent (failure is almost inevitable) | E | Moderate | Moderate | High | Unacceptable | Unacceptable | Unacceptable
Severity (note: only grading on safety)
Rating | Meaning
I | No relevant effect on reliability or safety
II | Very minor, no damage, no injuries, only results in a maintenance action (only noticed by discriminating customers)
III | Minor, low damage, light injuries (affects very little of the system, noticed by average customer)
IV | Moderate, moderate damage, injuries possible (most customers are annoyed, mostly financial damage)
V | Critical (causes a loss of primary function; Loss of all safety Margins, 1 failure away from a catastrophe, severe damage, severe injuries, max 1 possible death )
VI | Catastrophic (product becomes inoperative; the failure may result complete unsafe operation and possible multiple deaths)
Detection
Rating | Meaning
1 | Certain - fault will be caught on test
2 | Almost certain
3 | High
4 | Moderate
5 | Low
6 | Fault is undetected by Operators or Maintainers
