psas/rocket-tracks/Documentation/FMEA/fmea.xlsx

Sheet: FMEA - RTx Controller
RTx Controller Board FMEA Analysis
I. Axis Position Feedback
Analog-to-Digital Converters
FMEA Ref. # | Item | Potential failure mode | Potential cause(s) | local effects of failure | next higher level effect | system level end effect | (P) Probability (estimate) | (S) Severity | Risk Level | Actions for further Investigation | Mitigation / Requirements | Fix in FW
ADC-1 | ADC1 |  |  | adc1 gives no output | unable to tell position of axis |  | A | V | Moderate | N/A | firmware fix | YES
ADC-2 | C1 | short | dielectric breakdown | short out +5VREF | unpredictable output | unable to tell position of axis | A | V | Moderate | N/A | firmware fix | YES
ADC-3 | C4 | short | dielectric breakdown | short out +5V |  |  | A | III | low | N/A | N/A
ADC-4 | C5 | short | dielectric breakdown | short out +3.3V |  |  | A | III | low | N/A | N/A
ADC-5 | ADC2 |  |  | adc2 gives no output | unable to tell position of axis |  | A | V | Moderate | N/A | firmware fix | YES
ADC-6 | C2 | short | dielectric breakdown | short out +5VREF | unpredictable output | unable to tell position of axis | A | V | Moderate | N/A | firmware fix | YES
ADC-7 | C6 | short | dielectric breakdown | short out +5V |  |  | A | III | low | N/A | N/A
ADC-8 | C7 | short | dielectric breakdown | short out +3.3V |  |  | A | III | low | N/A | N/A
ADC-9 | ADC3 |  |  | adc3 gives no output | unable to tell position of axis |  | A | V | Moderate | N/A | firmware fix | YES
ADC-10 | C3 | short | dielectric breakdown | short out +5VREF | unpredictable output | unable to tell position of axis | A | V | Moderate | N/A | firmware fix | YES
ADC-11 | C8 | short | dielectric breakdown | short out +5V |  |  | A | III | low | N/A | N/A
ADC-12 | C9 | short | dielectric breakdown | short out +3.3V |  |  | A | III | low | N/A | N/A
ADC-13 | ADC4 |  |  | adc4 gives no output | unable to tell position of axis |  | A | V | Moderate | N/A | firmware fix | YES
ADC-14 | C40 | short | dielectric breakdown | short out +5VREF | unpredictable output | unable to tell position of axis | A | V | Moderate | N/A | firmware fix | YES
ADC-15 | C41 | short | dielectric breakdown | short out +5V |  |  | A | III | low | N/A | N/A
ADC-16 | C42 | short | dielectric breakdown | short out +3.3V |  |  | A | III | Moderate | N/A | N/A
ADC-17 | R20 | open | excessive power | SDO is open | SPI/MISO3 is floating | no powition data | A | V | Moderate | N/A | firmware fix | YES
Low-Pass Filters for Feedback ADCs
FMEA Ref. # | Item | Potential failure mode | Potential cause(s) | local effects of failure | next higher level effect | system level end effect | (P) Probability (estimate) | (S) Severity | Risk Level | Actions for further Investigation | Mitigation / Requirements | Fix in FW
LPF-1 | R1 | open | excessive power | entire opamp system pulled low - no input | unreliable position data |  | A | V | Moderate | N/A | firmware fix | YES
LPF-2 | R2 | open | excessive power | no input to opamp | unreliable position data |  | A | V | Moderate | N/A | firmware fix | YES
LPF-3 | R3 | open | excessive power | capicitors will discharge and '+' on opamp will be pulled low | unreliable position data |  | A | V | Moderate | N/A | firmware fix | YES
LPF-4 | C10 | short | dielectric breakdown | entire opamp system pulled low - no input | unreliable position data |  | A | V | Moderate | N/A | firmware fix | YES
LPF-5 | C11 | short | dielectric breakdown | entire opamp system pulled low - no input | unreliable position data |  | A | V | Moderate | N/A | firmware fix | YES
LPF-6 | C12 | short | dielectric breakdown | +' on opamp shorted out | unreliable position data |  | A | V | Moderate | N/A | firmware fix | YES
LPF-7 | C13 | short | dielectric breakdown | +' on opamp shorted out | unreliable position data |  | A | V | Moderate | N/A | firmware fix | YES
LPF-8 | OPAMP1-A | fail output high or fail output low |  | filter to ADC1 fails | unreliable position data |  | A | V | Moderate | N/A | firmware fix | YES
LPF-9 | R4 | open | excessive power | entire opamp system pulled low - no input | unreliable position data |  | A | V | Moderate | N/A | firmware fix | YES
LPF-10 | R5 | open | excessive power | no input to opamp | unreliable position data |  | A | V | Moderate | N/A | firmware fix | YES
LPF-11 | R6 | open | excessive power | capicitors will discharge and '+' on opamp will be pulled low | unreliable position data |  | A | V | Moderate | N/A | firmware fix | YES
LPF-12 | C14 | short | dielectric breakdown | entire opamp system pulled low - no input | unreliable position data |  | A | V | Moderate | N/A | firmware fix | YES
LPF-13 | C15 | short | dielectric breakdown | entire opamp system pulled low - no input | unreliable position data |  | A | V | Moderate | N/A | firmware fix | YES
LPF-14 | C16 | short | dielectric breakdown | +' on opamp shorted out | unreliable position data |  | A | V | Moderate | N/A | firmware fix | YES
LPF-15 | C17 | short | dielectric breakdown | +' on opamp shorted out | unreliable position data |  | A | V | Moderate | N/A | firmware fix | YES
LPF-16 | OPAMP1-B | fail output high or fail output low |  | filter to ADC2 fails | unreliable position data |  | A | V | Moderate | N/A | firmware fix | YES
LPF-17 | R7 | open | excessive power | entire opamp system pulled low - no input | unreliable position data |  | A | V | Moderate | N/A | firmware fix | YES
LPF-18 | R8 | open | excessive power | no input to opamp | unreliable position data |  | A | V | Moderate | N/A | firmware fix | YES
LPF-19 | R9 | open | excessive power | capicitors will discharge and '+' on opamp will be pulled low | unreliable position data |  | A | V | Moderate | N/A | firmware fix | YES
LPF-20 | C18 | short | dielectric breakdown | entire opamp system pulled low - no input | unreliable position data |  | A | V | Moderate | N/A | firmware fix | YES
LPF-21 | C19 | short | dielectric breakdown | entire opamp system pulled low - no input | unreliable position data |  | A | V | Moderate | N/A | firmware fix | YES
LPF-22 | C20 | short | dielectric breakdown | +' on opamp shorted out | unreliable position data |  | A | V | Moderate | N/A | firmware fix | YES
LPF-23 | C21 | short | dielectric breakdown | +' on opamp shorted out | unreliable position data |  | A | V | Moderate | N/A | firmware fix | YES
LPF-24 | OPAMP2-A | fail output high or fail output low |  | filter to ADC3 fails | unreliable position data |  | A | V | Moderate | N/A | firmware fix | YES
LPF-25 | R17 | open | excessive power | entire opamp system pulled low - no input | unreliable position data |  | A | V | Moderate | N/A | firmware fix | YES
LPF-26 | R18 | open | excessive power | no input to opamp | unreliable position data |  | A | V | Moderate | N/A | firmware fix | YES
LPF-27 | R19 | open | excessive power | capicitors will discharge and '+' on opamp will be pulled low | unreliable position data |  | A | V | Moderate | N/A | firmware fix | YES
LPF-28 | C36 | short | dielectric breakdown | entire opamp system pulled low - no input | unreliable position data |  | A | V | Moderate | N/A | firmware fix | YES
LPF-29 | C37 | short | dielectric breakdown | entire opamp system pulled low - no input | unreliable position data |  | A | V | Moderate | N/A | firmware fix | YES
LPF-30 | C38 | short | dielectric breakdown | +' on opamp shorted out | unreliable position data |  | A | V | Moderate | N/A | firmware fix | YES
LPF-31 | C39 | short | dielectric breakdown | +' on opamp shorted out | unreliable position data |  | A | V | Moderate | N/A | firmware fix | YES
LPF-32 | OPAMP2-B | fail output high or fail output low |  | filter to ADC4 fails | unreliable position data |  | A | V | Moderate | N/A | firmware fix | YES
II. Microcontroller
FMEA Ref. # | Item | Potential failure mode | Potential cause(s) | local effects of failure | next higher level effect | system level end effect | (P) Probability (estimate) | (S) Severity | Risk Level | Actions for further Investigation | Mitigation / Requirements | Fix in FW
MC-1 | R36 | open | excessive power | VBAT floating
MC-2 | R38 | open | excessive power | BOOT0 floating
MC-3 | R168 | open | excessive power | VTREF on debug header floating
MC-4 | C78 | short | dielectric breakdown | +3.3V' shorted to GND
MC-5 | C79 | short | dielectric breakdown | +3.3V' shorted to GND
MC-6 | C80 | short | dielectric breakdown | +3.3V' shorted to GND
MC-7 | C81 | short | dielectric breakdown | +3.3V' shorted to GND
MC-8 | C82 | short | dielectric breakdown | +3.3V' shorted to GND
MC-9 | C83 | short | dielectric breakdown | +3.3V' shorted to GND
MC-10 | C84 | short | dielectric breakdown | +3.3V' shorted to GND
MC-11 | C85 | short | dielectric breakdown | +3.3V' shorted to GND
MC-12 | C86 | short | dielectric breakdown | VCAP_2 shorted to GND
MC-13 | C87 | short | dielectric breakdown | VCAP_1 shorted to GND
MC-14 | C88 | short | dielectric breakdown | +3.3V' shorted to GND
MC-15 | C89 | short | dielectric breakdown | +3.3V' shorted to GND
MC-16 | C90 | short | dielectric breakdown | +3.3V' shorted to GND
MC-17 | C91 | short | dielectric breakdown | +3.3V' shorted to GND
MC-18 | C92 | short | dielectric breakdown | reset constantly pulled low (note that C92 is a no-stuff so extremely low propability)
MC-19 | SW1 | open |  | unable to trigger HW reset
MC-20 | J22 | plugged in backwards | user error |  |  |  |  |  |  |  | Use connector with tab
MC-21 | U1 |  |  |  | nothing will work
MC-22 | R50 | short | excessive power | PWM_AXIS3_V_OUT <- floating
MC-23 | R37 | short | excessive power | PWM_AXIS3_U_OUT <- floating
MC-24 | R39 | short | excessive power | PWM_AXIS4_V_OUT <- floating
MC-25 | R40 | short | excessive power | PWM_AXIS4_U_OUT <- floating
MC-26 | C117 | open | dielectric breakdown | no stuff, but if placed and shorted will gnd signal
MC-27 | C118 | open | dielectric breakdown | no stuff, but if placed and shorted will gnd signal
MC-28 | C119 | open | dielectric breakdown | no stuff, but if placed and shorted will gnd signal
MC-29 | C120 | open | dielectric breakdown | no stuff, but if placed and shorted will gnd signal
MC-30 | C121 | open | dielectric breakdown | no stuff, but if placed and shorted will gnd signal
MC-31 | C122 | open | dielectric breakdown | no stuff, but if placed and shorted will gnd signal
MC-32 | C123 | open | dielectric breakdown | no stuff, but if placed and shorted will gnd signal
MC-33 | C124 | open | dielectric breakdown | no stuff, but if placed and shorted will gnd signal
MC-34 | R41 | short | excessive power | ENABLE_AXIS3_OUT <-floating (or pulled low if no stuff caps are placed)
MC-35 | R42 | short | excessive power | WATCHDOG_AXIS3_OUT <- floating (or pulled low if no stuff caps are placed)
MC-36 | R43 | short | excessive power | ENABLE_AXIS4_OUT <- floating (or pulled low if no stuff caps are placed)
MC-37 | R44 | short | excessive power | EATCHDOG_AXIS4_OUT <- floating (or pulled low if no stuff caps are placed)
MC-38 | C109 | open | dielectric breakdown | no stuff, but if placed and shorted will gnd signal
MC-39 | C110 | open | dielectric breakdown | no stuff, but if placed and shorted will gnd signal
MC-40 | C111 | open | dielectric breakdown | no stuff, but if placed and shorted will gnd signal
MC-41 | C112 | open | dielectric breakdown | no stuff, but if placed and shorted will gnd signal
MC-42 | C113 | open | dielectric breakdown | no stuff, but if placed and shorted will gnd signal
MC-43 | C114 | open | dielectric breakdown | no stuff, but if placed and shorted will gnd signal
MC-44 | C115 | open | dielectric breakdown | no stuff, but if placed and shorted will gnd signal
MC-45 | C116 | open | dielectric breakdown | no stuff, but if placed and shorted will gnd signal
MC-46 | R45 | short | excessive power | PWM_VERT_V_OUT <- floating (or pulled low if no stuff caps are placed)
MC-47 | R46 | short | excessive power | PMW_VERT_U_OUT <- floating (or pulled low if no stuff caps are placed)
MC-48 | R47 | short | excessive power | PWM_LAT_V_OUT <- floating (or pulled low if no stuff caps are placed)
MC-49 | R48 | short | excessive power | PWM_LAT_U_OUT <- floating (or pulled low if no stuff caps are placed)
MC-50 | C93 | open | dielectric breakdown | no stuff, but if placed and shorted will gnd signal
MC-51 | C94 | open | dielectric breakdown | no stuff, but if placed and shorted will gnd signal
MC-52 | C95 | open | dielectric breakdown | no stuff, but if placed and shorted will gnd signal
MC-53 | C96 | open | dielectric breakdown | no stuff, but if placed and shorted will gnd signal
MC-54 | C97 | open | dielectric breakdown | no stuff, but if placed and shorted will gnd signal
MC-55 | C98 | open | dielectric breakdown | no stuff, but if placed and shorted will gnd signal
MC-56 | C99 | open | dielectric breakdown | no stuff, but if placed and shorted will gnd signal
MC-57 | C100 | open | dielectric breakdown | no stuff, but if placed and shorted will gnd signal
MC-58 | R49 | short | excessive power | WATCHDOG_LAT_OUT <- floating (or pulled low if no stuff caps are placed)
MC-59 | R51 | short | excessive power | ENABLE_LAT_OUT <- floating (or pulled low if no stuff caps are placed)
MC-60 | R52 | short | excessive power | WATCHDOG_VERT_OUT <-floating (or pulled low if no stuff caps are placed)
MC-61 | R53 | short | excessive power | ENABLE_VERT_OUT <- floating (or pulled low if no stuff caps are placed)
MC-62 | C101 | open | dielectric breakdown | no stuff, but if placed and shorted will gnd signal
MC-63 | C102 | open | dielectric breakdown | no stuff, but if placed and shorted will gnd signal
MC-64 | C103 | open | dielectric breakdown | no stuff, but if placed and shorted will gnd signal
MC-65 | C104 | open | dielectric breakdown | no stuff, but if placed and shorted will gnd signal
MC-66 | C105 | open | dielectric breakdown | no stuff, but if placed and shorted will gnd signal
MC-67 | C106 | open | dielectric breakdown | no stuff, but if placed and shorted will gnd signal
MC-68 | C107 | open | dielectric breakdown | no stuff, but if placed and shorted will gnd signal
MC-69 | C108 | open | dielectric breakdown | no stuff, but if placed and shorted will gnd signal
MC-70 | X2
MC-71 | X3
III. Ethernet Port
Ethernet PHY
FMEA Ref. # | Item | Potential failure mode | Potential cause(s) | local effects of failure | next higher level effect | system level end effect | (P) Probability (estimate) | (S) Severity | Risk Level | Actions for further Investigation | Mitigation / Requirements | Fix in FW
EP-1 | IC2
EP-2 | JP1
EP-3 | R23 | open | excessive power | TD+,TD- outputs would be useless | no data being sent via ethernet | unable to receive desired position
EP-4 | R24 | open | excessive power | TD+,TD- outputs would be useless | no data being sent via ethernet | unable to receive desired position
EP-5 | R26 | open | excessive power | RBIAS floating | no data being sent via ethernet | unable to receive desired position
EP-6 | R27 | open | excessive power | RESERVED would float | no data being sent via ethernet | unable to receive desired position
EP-7 | R30 | open | excessive power | RD-, RD+ useless | no data being sent via ethernet
EP-8 | R31 | open | excessive power | RD-, RD+ useless | no data being sent via ethernet
EP-9 | R33 | open | excessive power | SW_STRAP floating | no data being sent via ethernet
EP-10 | R34 | open | excessive power | RESET floating | no data being sent via ethernet
EP-11 | R35 | open | excessive power | INT_PWDN floating | no data being sent via ethernet
EP-12 | C52 | short | dielectric breakdown | +3.3V' shorted to GND | no data being sent via ethernet
EP-13 | C53 | short | dielectric breakdown | +3.3V' shorted to GND | no data being sent via ethernet
EP-14 | C56 | short | dielectric breakdown | +3.3V' shorted to GND | no data being sent via ethernet
EP-15 | C57 | short | dielectric breakdown | +3.3V' shorted to GND | no data being sent via ethernet
EP-16 | C58 | short | dielectric breakdown | +3.3V' shorted to GND | no data being sent via ethernet
EP-17 | C59 | short | dielectric breakdown | +3.3V' shorted to GND | no data being sent via ethernet
EP-18 | C60 | short | dielectric breakdown | +3.3V' shorted to GND | no data being sent via ethernet
EP-19 | C61 | short | dielectric breakdown | +3.3V' shorted to GND | no data being sent via ethernet
EP-20 | C62 | short | dielectric breakdown | +3.3V' shorted to GND | no data being sent via ethernet
EP-21 | C63 | short | dielectric breakdown | +3.3V' shorted to GND | no data being sent via ethernet
EP-22 | C64 | short | dielectric breakdown | +3.3V' shorted to GND | no data being sent via ethernet
EP-23 | C65 | short | dielectric breakdown | +3.3V' shorted to GND | no data being sent via ethernet
EP-24 | C66 | short | dielectric breakdown | +3.3V' shorted to GND | no data being sent via ethernet
EP-25 | C67 | short | dielectric breakdown | +3.3V' shorted to GND | no data being sent via ethernet
EP-26 | C68 | short | dielectric breakdown | PFBOUT, PFBIN1, PFBIN2 grounded
EP-27 | C69 | short | dielectric breakdown | PFBOUT, PFBIN1, PFBIN2 grounded
EP-28 | C70 | short | dielectric breakdown | PFBOUT, PFBIN1, PFBIN2 grounded
EP-29 | C71 | short | dielectric breakdown | PFBOUT, PFBIN1, PFBIN2 grounded
Ethernet Connector
FMEA Ref. # | Item | Potential failure mode | Potential cause(s) | local effects of failure | next higher level effect | system level end effect | (P) Probability (estimate) | (S) Severity | Risk Level | Actions for further Investigation | Mitigation / Requirements | Fix in FW
EC-1 | X8
EC-2 | R25 | open | excessive power
EC-3 | R28 | open | excessive power
EC-4 | R29 | open | excessive power
EC-5 | R32 | open | excessive power
EC-6 | C44 | short | dielectric breakdown
EC-7 | C48 | short | dielectric breakdown
EC-8 | C50 | short | dielectric breakdown
EC-9 | C51 | short | dielectric breakdown
PoE
FMEA Ref. # | Item | Potential failure mode | Potential cause(s) | local effects of failure | next higher level effect | system level end effect | (P) Probability (estimate) | (S) Severity | Risk Level | Actions for further Investigation | Mitigation / Requirements | Fix in FW
POE-1 | IC1 |  |  | PoE will not function properly | devices not power, not receiving feedback |  |  |  |  |  | hardware fix (check periodically to confirm) | Yes
POE-2 | F1 |  |  | PoE will not function properly | devices not power, not receiving feedback |  |  |  |  |  | hardware fix (check periodically to confirm) | Yes
POE-3 | LED1
POE-4 | L1 |  |  | PoE will not function properly | devices not power, not receiving feedback |  |  |  |  |  | hardware fix (check periodically to confirm) | Yes
POE-5 | C43 | short | dielectric breakdown | PoE will not function properly | devices not power, not receiving feedback |  |  |  |  |  | hardware fix (check periodically to confirm) | Yes
POE-6 | C47 | short | dielectric breakdown | PoE will not function properly | devices not power, not receiving feedback |  |  |  |  |  | hardware fix (check periodically to confirm) | Yes
POE-7 | C49 | short | dielectric breakdown | PoE will not function properly | devices not power, not receiving feedback |  |  |  |  |  | hardware fix (check periodically to confirm) | Yes
POE-8 | D1 |  |  | PoE will not function properly | devices not power, not receiving feedback |  |  |  |  |  | hardware fix (check periodically to confirm) | Yes
POE-9 | D2 |  |  | PoE will not function properly | devices not power, not receiving feedback |  |  |  |  |  | hardware fix (check periodically to confirm) | Yes
POE-10 | R_LED1
POE-11 | POE |  |  | PoE will not function properly | devices not power, not receiving feedback |  |  |  |  |  | hardware fix (check periodically to confirm) | Yes
POE-12 | C135
POE-13 | C132
POE-14 | C131
POE-15 | R54
POE-16 | C129
POE-17 | C130
POE-18 | C133
IV. USB
FMEA Ref. # | Item | Potential failure mode | Potential cause(s) | local effects of failure | next higher level effect | system level end effect | (P) Probability (estimate) | (S) Severity | Risk Level | Actions for further Investigation | Mitigation / Requirements | Fix in FW
USB-1 | R21 | open | excessive power | cannot connect via usb | cannot program microcontroller |  | A | I | low | N/A | if failure, replace copmonenet
USB-2 | R22 | open | excessive power | cannot connect via usb | cannot program microcontroller |  | A | I | low | N/A | if failure, replace copmonenet
USB-3 | C45 | short | dielectric breakdown | no esd protection |  |  | A | I | low | N/A | if failure, replace copmonenet
USB-4 | C46 | short | dielectric breakdown | no esd protection |  |  | A | I | low | N/A | if failure, replace copmonenet
USB-5 | U2 | internal diode breakdown |  | no esd protection |  |  | A | I | low | N/A | if failure, replace copmonenet
USB-6 | X4 | pin breaks |  | cannot connect via usb | cannot program microcontroller |  | A | I | low | N/A | if failure, replace copmonenet
V. Supply Voltage Regulation / Filtering
FMEA Ref. # | Item | Potential failure mode | Potential cause(s) | local effects of failure | next higher level effect | system level end effect | (P) Probability (estimate) | (S) Severity | Risk Level | Actions for further Investigation | Mitigation / Requirements | Fix in FW
SV-1 | C30 | short | dielectric breakdown | +12V shorted to GND
SV-2 | C31 | short | dielectric breakdown | +12V shorted to GND
SV-3 | VR1 |  |  | would not receive +3.3V or +5V supply | no +3.3V or +5.5V supplied
SV-4 | C125 | short | dielectric breakdown | +12V shorted to GND
SV-5 | C126 | short | dielectric breakdown | +12V shorted to GND
SV-6 | VR3 |  |  | would not receive +8V supply | no +8V supplied
SV-7 | C34 | short | dielectric breakdown | +9-36V shorted to GND
SV-8 | R13 | open | excessive power | EN pulled low | VR2 not enabled
SV-9 | R14 | open | excessive power | EN pulled high | VR2 likely to break? too high of voltage
SV-10 | R12 | open | excessive power | RON floating | on time not set
SV-11 | C33 | short | dielectric breakdown | SS shorted to GND
SV-12 | C32 | short | dielectric breakdown | VOUT shorted to FB
SV-13 | R11 | open | excessive power
SV-14 | R15 | open | excessive power
SV-15 | C35 | short | dielectric breakdown | +12V shorted to GND
SV-16 | VR2
SV-17 | C24 | short | dielectric breakdown | +8V shorted to GND
SV-18 | C25 | short | dielectric breakdown | +8V shorted to GND
SV-19 | REF1
SV-20 | C23 | short | dielectric breakdown | +5.00VREF shorted to GND
SV-21 | R10 | open | excessive power
SV-22 | C22 | short | dielectric breakdown
SV-23 | R16 | open | excessive power
SV-24 | C29 | open | dielectric breakdown | +3.3V' shorted to GND
SV-25 | C27 | open | dielectric breakdown | +3.3V' shorted to GND
SV-26 | C28 | open | dielectric breakdown | +5V' shorted to GND
SV-27 | C26 | open | dielectric breakdown | +5V' shorted to GND
SV-28 | C127 | open | dielectric breakdown | +8V shorted to GND
SV-29 | C128 | open | dielectric breakdown | +8V shorted to GND

Sheet: FMEA - Manual Remote
Rocket Tracks FMEA Analysis
Manual Remote Board
FMEA Ref. # | Item | Potential failure mode | Potential cause(s) | local effects of failure | next higher level effect | system level end effect | (P) Probability (estimate) | (S) Severity | Risk Level | Actions for further Investigation | Mitigation / Requirements | Fix in FW
MR-1 | R1 | open | excessive power | vert_axis_adc would float |  |  | A | II | low | N/A | N/A
MR-2 | R2 | open | excessive power | Lat_axis_adc would float |  |  | A | II | low | N/A | N/A
MR-3 | R3 | open | excessive power | axis3_adc would float |  |  | A | II | low | N/A | N/A
MR-4 | R4 | open | excessive power | axis4_adc would float |  |  | A | II | low | N/A | N/A
MR-5 | R5 | open | excessive power | vert_neatural_LED would float | led would not work |  | A | I | low | N/A | N/A
MR-6 | R6 | open | excessive power | lat_neatral_LED would float | led would not work |  | A | I | low | N/A | N/A
MR-7 | R7 | open | excessive power | mode1_LED would float | led would not work |  | A | I | low | N/A | N/A
MR-8 | R8 | open | excessive power | mode2_LED would float | led would not work |  | A | I | low | N/A | N/A
MR-9 | R9 | open | excessive power | mode_switch_in will always be pulled low | will always be stuck in one of the two modes |  | A | I | low | N/A | N/A
MR-10 | R10 | open | excessive power | aux1_LED would float | led would not work |  | A | I | low | N/A | N/A
MR-11 | R11 | open | excessive power | aux2_LED would float | led would not work |  | A | I | low | N/A | N/A
MR-12 | R12 | open | excessive power | aux_switch_in pulled low | will always be stuck in one of the two modes |  | A | I | low | N/A | N/A
MR-13 | R13 | open | excessive power | drive enable always pulled low | Rtx motor drivers will always be disabled | Manual mode will not work | A | I | low | N/A | N/A
MR-14 | R14 | open | excessive power | floating trace when not enabled | could result in enabling motor drivers when not wanted |  | A | III | low | N/A | Use Active Pull-Down on GPIO (Recalculate external pull-down value) | YES
MR-15 | R15 | open | excessive power | floating trace when not enabled | not sure which mode it will be in |  | A | I | low | N/A | N/A
MR-16 | R16 | open | excessive power | floating trace when not enabled | not sure which mode it will be in |  | A | I | low | N/A | N/A
MR-17 | C1 | short | dielectric breakdown | vert_axis_adc pulled low |  |  | A | I | low | N/A | N/A
MR-18 | C2 | short | dielectric breakdown | Lat_axis_adc pulled low |  |  | A | I | low | N/A | N/A
MR-19 | C3 | short | dielectric breakdown | axis3_adc pulled low |  |  | A | I | low | N/A | N/A
MR-20 | C4 | short | dielectric breakdown | axis4_adc pulled low |  |  | A | I | low | N/A | N/A
MR-21 | C5 | short | dielectric breakdown | Aref shorted to GND | power supply shorted out | Manual mode will not work | A | III | low | N/A | N/A
MR-22 | C6 | short | dielectric breakdown | "+5V" shorted to GND | power supply shorted out | Manual mode will not work | A | III | low | N/A | N/A
MR-23 | C7 | short | dielectric breakdown | aux_switch_in pulled low | will always be stuck in one of the two modes |  | A | I | low | N/A | N/A
MR-24 | C8 | short | dielectric breakdown | mode_switch_in pulled low | will always be stuck in one of the two modes |  | A | I | low | N/A | N/A
MR-25 | C9 | short | dielectric breakdown | drive enable pulled low | Rtx motor drivers will always be disabled | Manual mode will not work | A | I | low | N/A | N/A
MR-26 | C10 | short | dielectric breakdown | "+3.3V" shorted to GND | power supply shorted out | Manual mode will not work | A | III | low | N/A | N/A
MR-27 | JP1 (CON1) | N/A | N/A | N/A | N/A | N/A | N/A | N/A | N/A | N/A | N/A
MR-28 | JP2 (mode switch/LEDs) | plugged in backwards | human error | improper connectivity | shorting power supplies together | manual mode will not work | C | IV | moderate | N/A | use connector with tab
MR-29 | JP3(Neutral LEDs) | plugged in backwards | human error | LEDs not functioning properly |  |  | A | I | low | N/A | N/A
MR-30 | JP4 (drive enable switch) | fails open | excessive power | drive enable always pulled low | Rtx motor drivers will always be disabled | Manual mode will not work | A | I | low | N/A | N/A
MR-31 | JP5 (CON4) | N/A | N/A | N/A | N/A | N/A | N/A | N/A | N/A | N/A | N/A
MR-32 | JP6 (CON2) | N/A | N/A | N/A | N/A | N/A | N/A | N/A | N/A | N/A | N/A
MR-33 | JP7 (Main axis inputs) | plugged in backwards | human error | power and gnd shorted | board wont function | manual mode will not work | C | IV | Moderate | N/A | use connector with tab
MR-34 | JP8 (Aux Axis Inputs) | plugged in backwards | human error | power and gnd shorted | board wont function | manual mode will not work | C | IV | Moderate | N/A | use connector with tab
MR-35 | JP9 (aux switch/ LEDs) | plugged in backwards | human error | improper connectivity | shorting power supplies together | manual mode will not work | C | IV | Moderate | N/A | use connector with tab
MR-36 | JP10 (CON3) | N/A | N/A | N/A | N/A | N/A | N/A | N/A | N/A | N/A | N/A

Sheet: KEY
Probability |  | Risk Level
Rating | Meaning | Probability \ Severity | I | II | III | IV | V | VI
A | Extremely Unlikely (Virtually impossible or No known occurrences on similar products or processes, with many running hours) | A | Low | Low | Low | Low | Moderate | High
B | Remote (Relatively few failures) | B | Low | Low | Low | Moderate | High | Unacceptable
C | Occasioinal (occasional failures) | C | Low | Low | Moderate | Moderate | High | Unacceptable
D | Reasonably Possible (repeated failures) | D | Low | Moderate | Moderate | High | Unacceptable | Unacceptable
E | Frequent (failure is almost inevitable) | E | Moderate | Moderate | High | Unacceptable | Unacceptable | Unacceptable
Severity (note: only grading on safety)
Rating | Meaning
I | No relevant effect on reliability or safety
II | Very minor, no damage, no injuries, only results in a maintenance action (only noticed by discriminating customers)
III | Minor, low damage, light injuries (affects very little of the system, noticed by average customer)
IV | Moderate, moderate damage, injuries possible (most customers are annoyed, mostly financial damage)
V | Critical (causes a loss of primary function; Loss of all safety Margins, 1 failure away from a catastrophe, severe damage, severe injuries, max 1 possible death )
VI | Catastrophic (product becomes inoperative; the failure may result complete unsafe operation and possible multiple deaths)
Detection
Rating | Meaning
1 | Certain - fault will be caught on test
2 | Almost certain
3 | High
4 | Moderate
5 | Low
6 | Fault is undetected by Operators or Maintainers
