psas/rocket-tracks/Documentation/poster/Poster block diagram.pdf

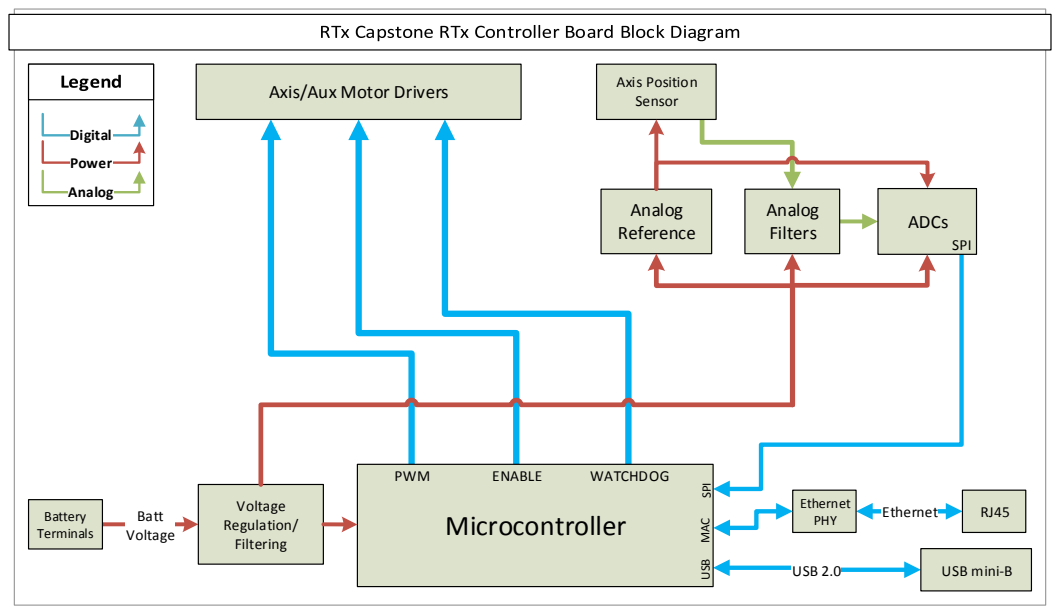
[picture p57: page 1]
Ethernet; Digital; Power; Analog; USB 2.0; Batt Voltage; Ethernet PHY; Axis Position; RJ45 Voltage Regulation/ Filtering; USB mini-B; Battery Terminals; Analog Reference; Filters; ADCs; SPI; Microcontroller; PWM; ENABLE; WATCHDOG

Sensor Axis/Aux Motor Drivers

USB SPI MAC
