psas/rocket-tracks/Documentation/poster/RTx Block Diagram.pdf

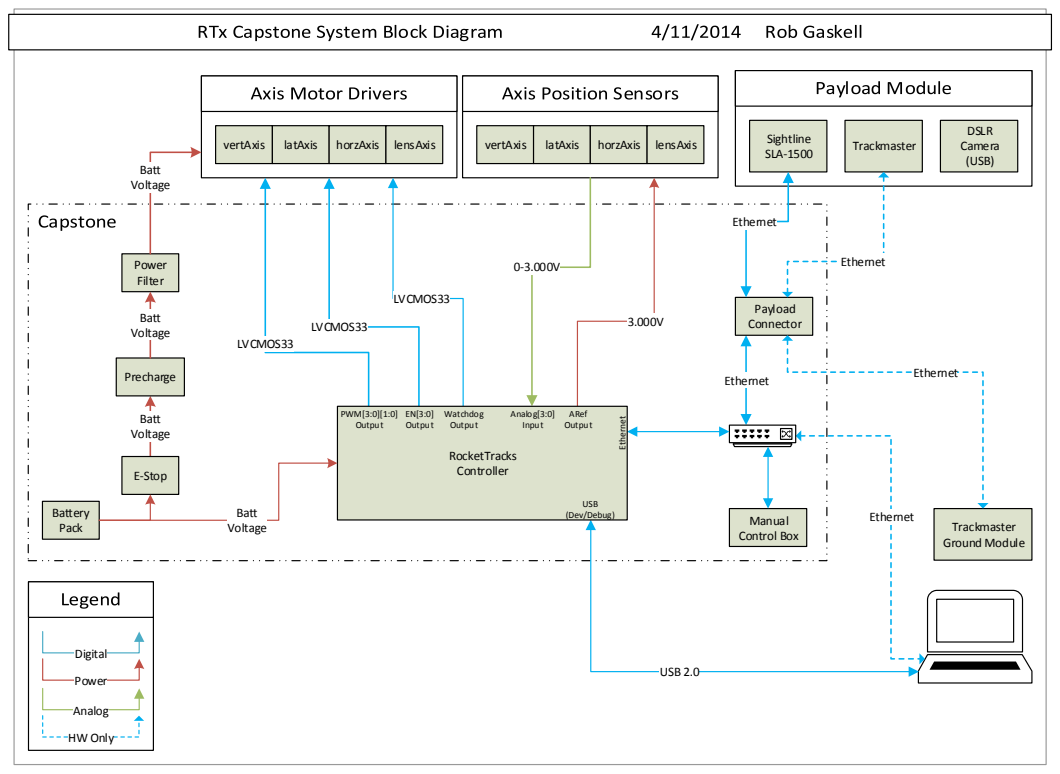
[picture p58: page 1]
vertAxis; latAxis; horzAxis; Sightline; SLA-1500; Battery Pack; Batt Voltage; Ethernet; E-Stop; Digital; Power; Analog; DSLR Camera (USB); HW Only; Trackmaster; Payload Connector; Trackmaster Ground Module; USB 2.0; Power Filter; LVCMOS33; lensAxis; RocketTracks Controller; PWM[3:0][1:0] Output; EN[3:0] Output; Analog[3:0] Input; ARef Output; Watchdog Output; USB; (Dev/Debug); Manual; Control Box; Precharge

LVCMOS33
