psas/rocket-tracks/Documentation/Hardware/RTx Controller Block Diagram.pdf

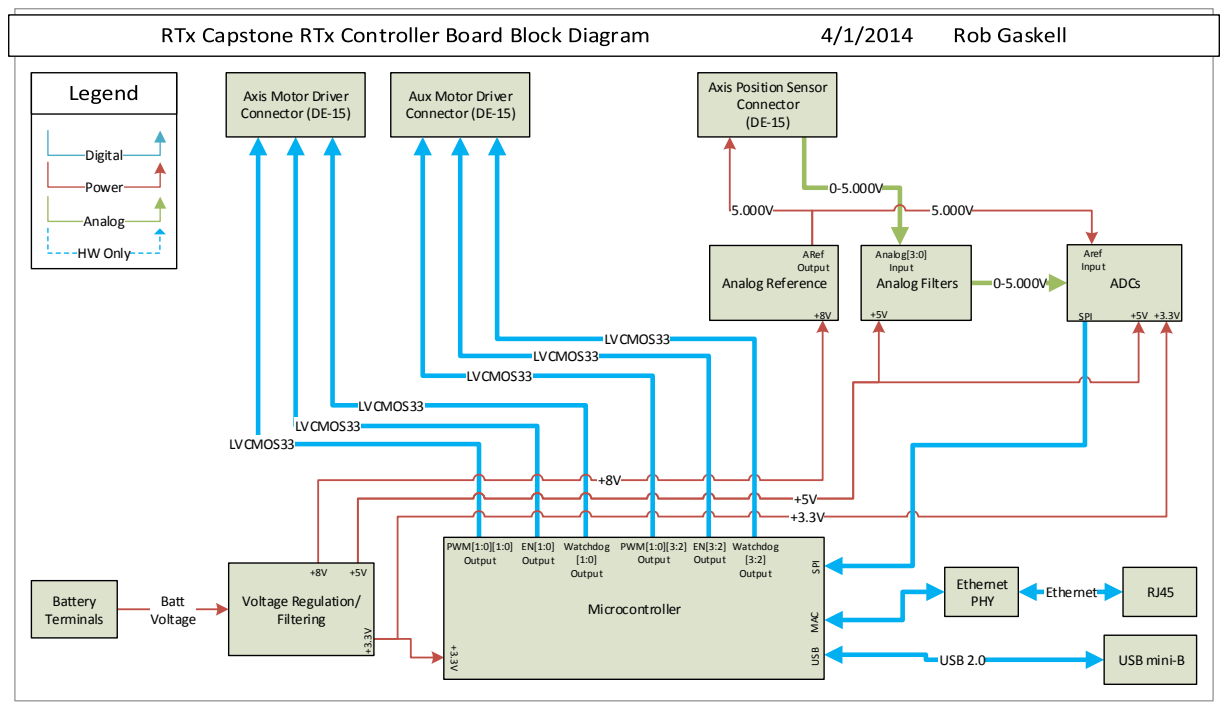
[picture p59: page 1]
Ethernet; Digital; Power; Analog; HW Only; USB 2.0; LVCMOS33; Batt Voltage; Ethernet PHY; RJ45 Voltage Regulation/; Filtering; USB mini-B; Battery Terminals; Analog Reference; ARef Output; Analog Filters; Analog[3:0] Input; ADCs; SPI; Aref Input; Microcontroller; PWM[1:0][1:0] Output; EN[1:0] Output; Watchdog [1:0] Output; PWM[1:0][3:2] Output; EN[3:2] Output; Watchdog [3:2] Output

Axis Position Sensor
Connector

Axis Motor Driver
Connector (DE-15)

Aux Motor Driver

LVCMOS33

USB SPI MAC
