psas/rocket-tracks/RTx_Main_Power/E-Stop Control.pdf

# E-Stop

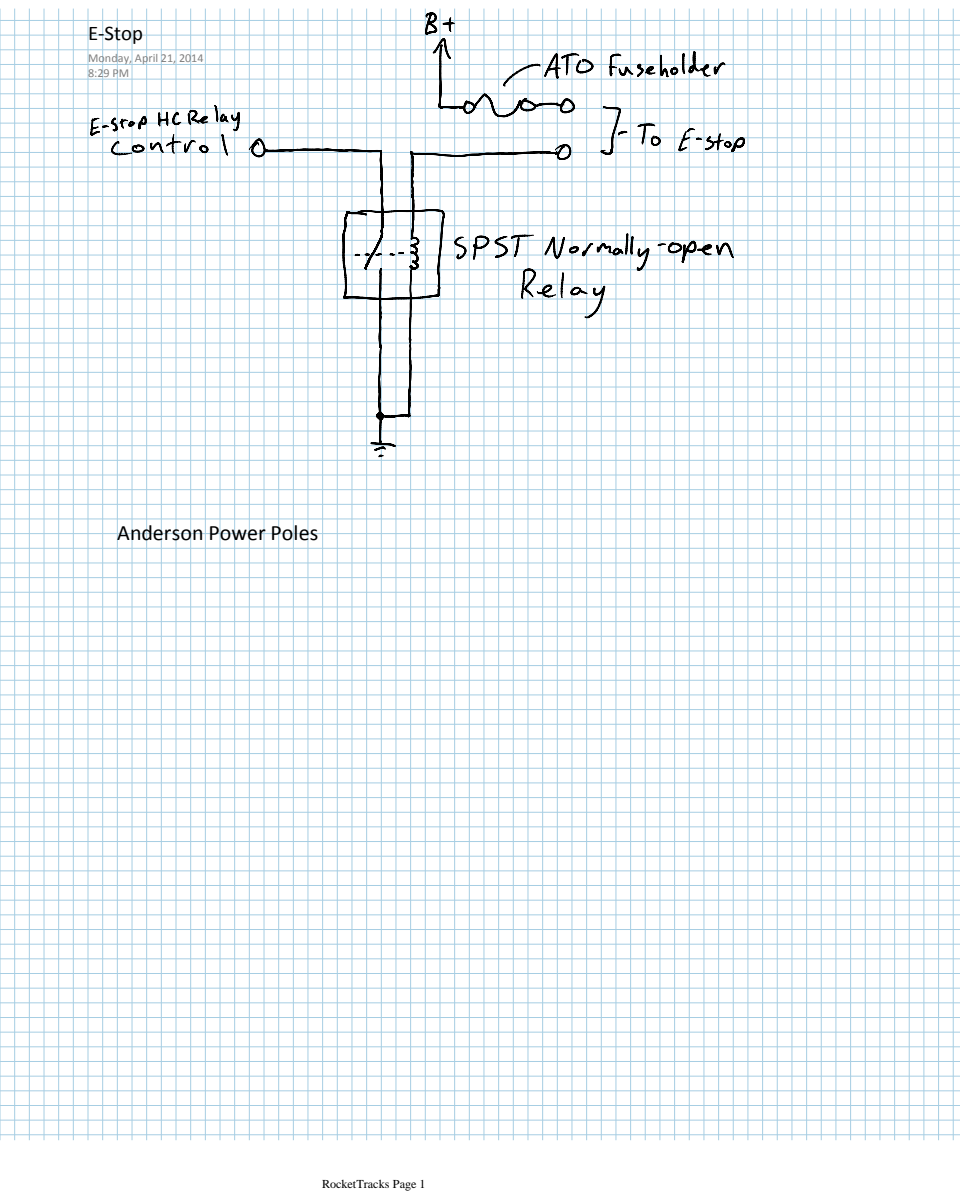
[picture p60: page 1]
Monday, April 21, 2014 8:29 PM; RocketTracks Page 1

Anderson Power Poles

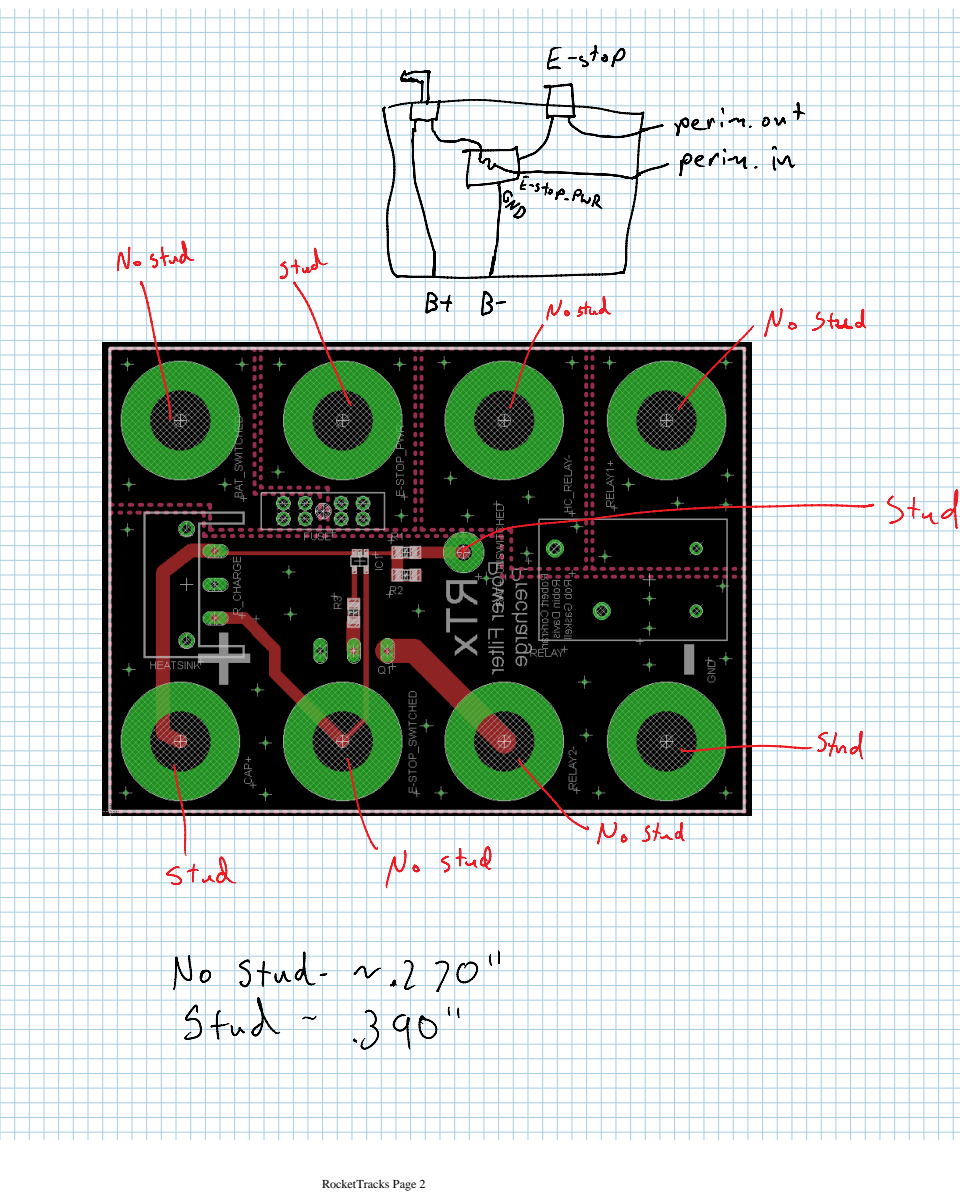
[picture p61: page 2]
RocketTracks Page 2
