psas/rocket-tracks/RTx_Controller_Board/RTxController.pdf

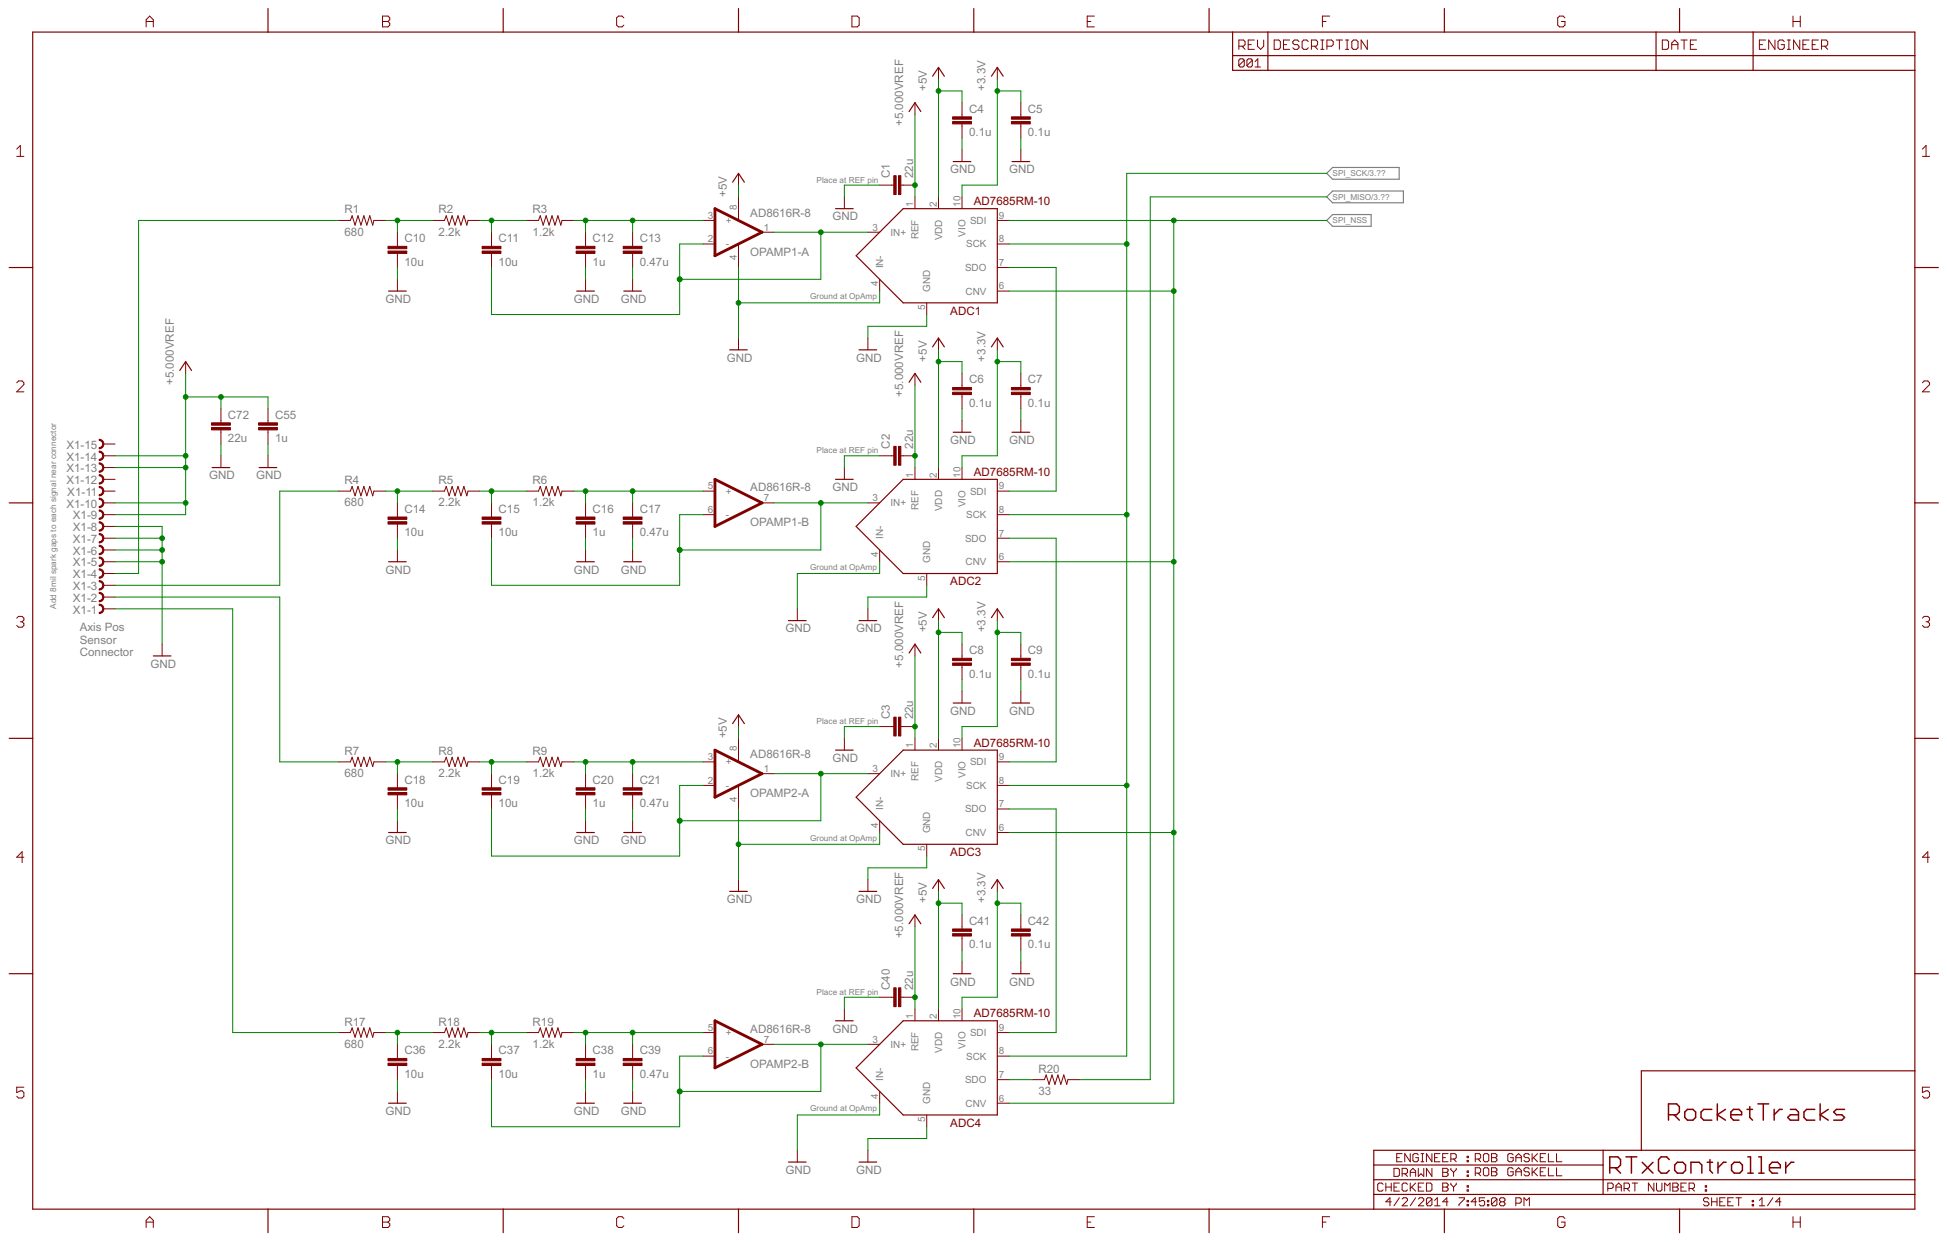
[picture p62: page 1]

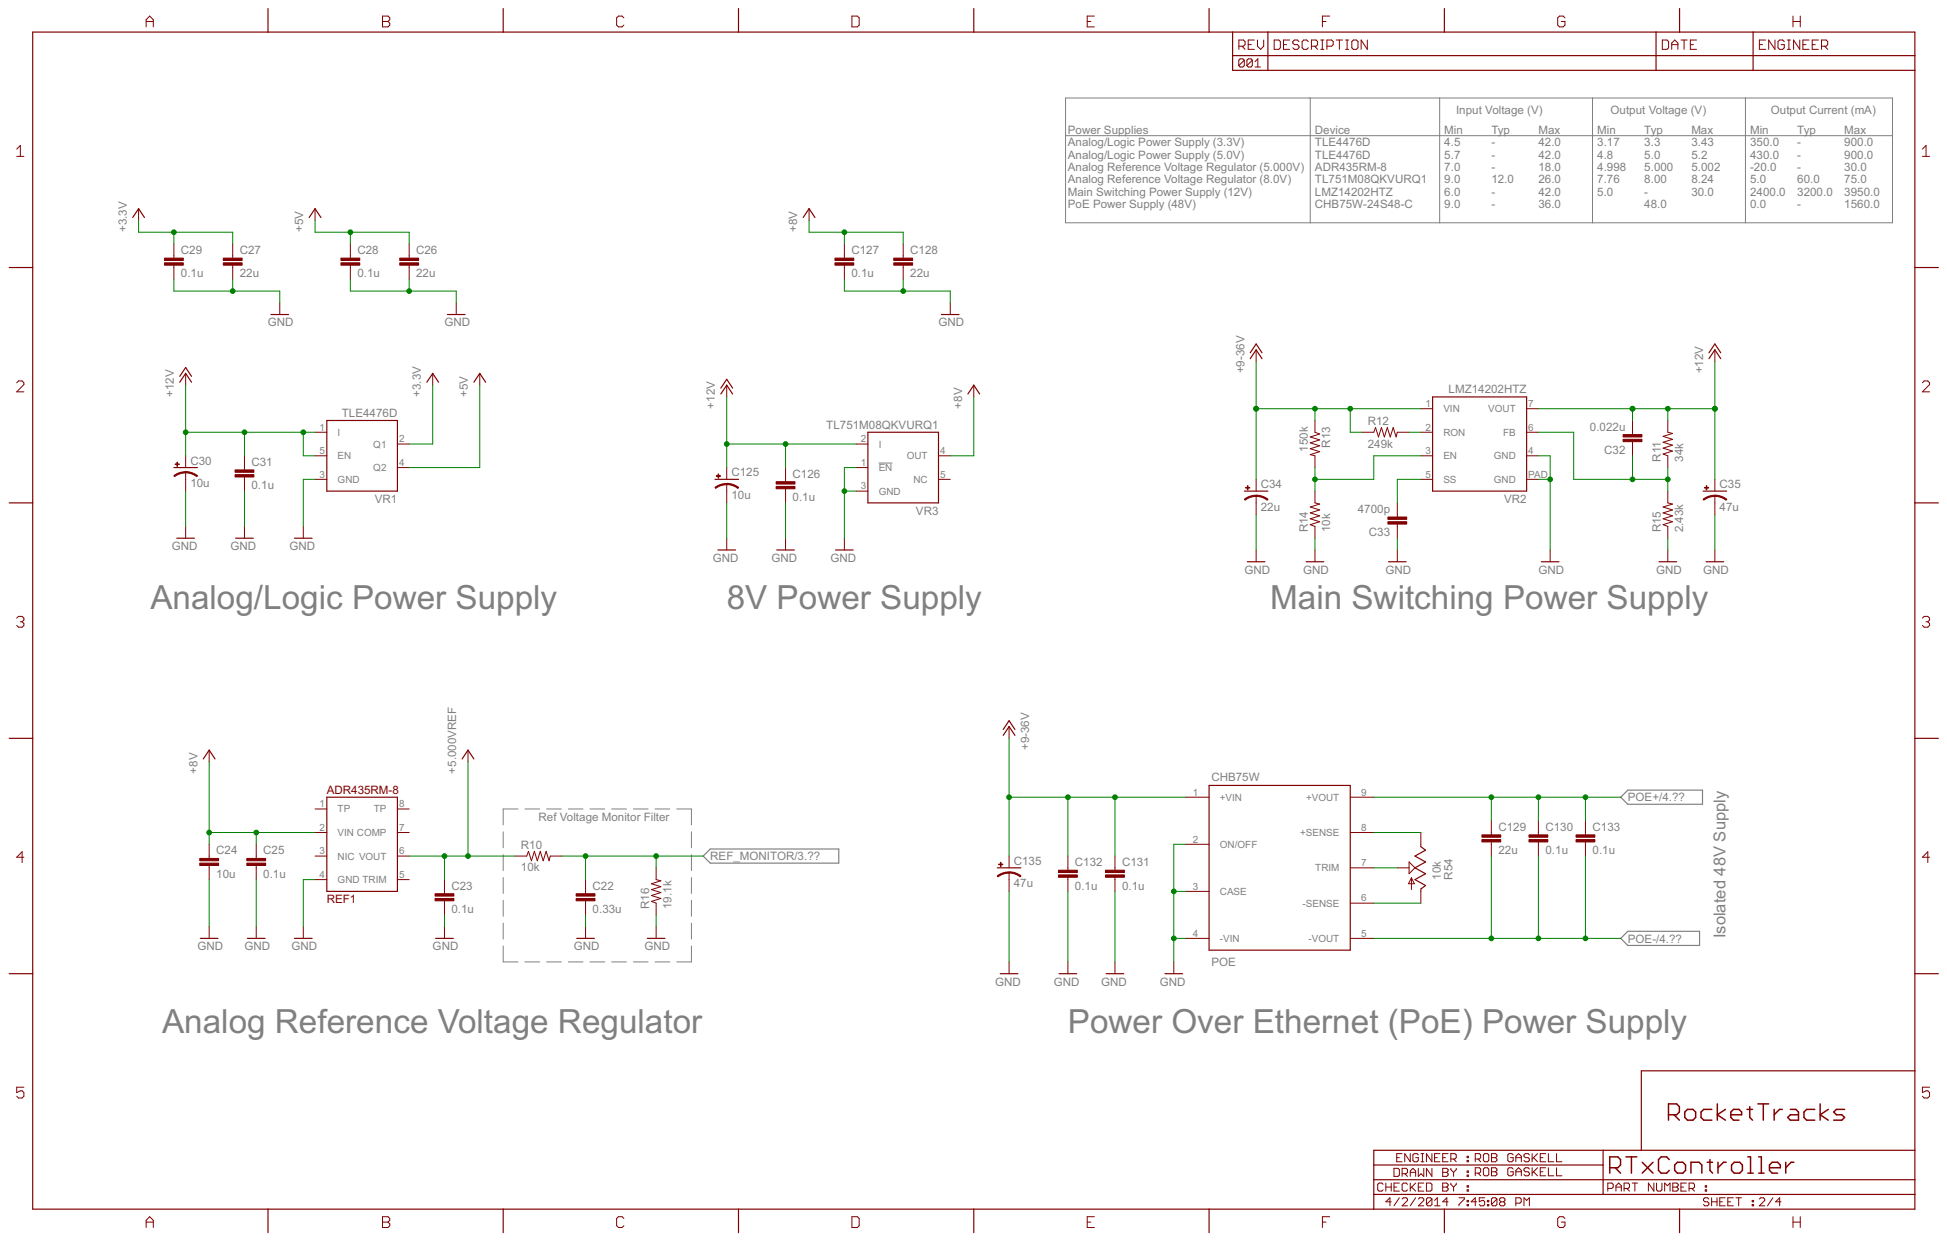
[picture p63: page 2]

Power Supplies Analog/Logic Power Supply (3.3V) | Device TLE4476D | Input Voltage (V) Min Typ | Output Voltage (V) Min Typ Max 3.43 | Output Current (mA) Min Typ
Analog/Logic Power Supply (5.0V) Analog Reference Voltage Regulator (5.000V) Analog Reference Voltage Regulator (8.0V) Main Switching Power Supply (12V) PoE Power Supply (48V) | TLE4476D ADR435RM-8 TL751M08QKVURQ1 LMZ14202HTZ CHB75W-24S48-C | - Max 42.0 4.5 -5.7 -42.0 7.0 -12.0 18.0 9.0 26.0 6.0 -42.0 9.0 36.0 | 3.17 3.3 4.8 5.0 5.2 4.998 5.000 5.002 7.76 8.00 8.24 5.0 -48.0 30.0 | - Max 900.0 350.0 -430.0 -900.0 -20.0 -60.0 30.0 5.0 75.0 2400.0 3200.0 3950.0 0.0 1560.0

Ref Voltage Monitor Filter

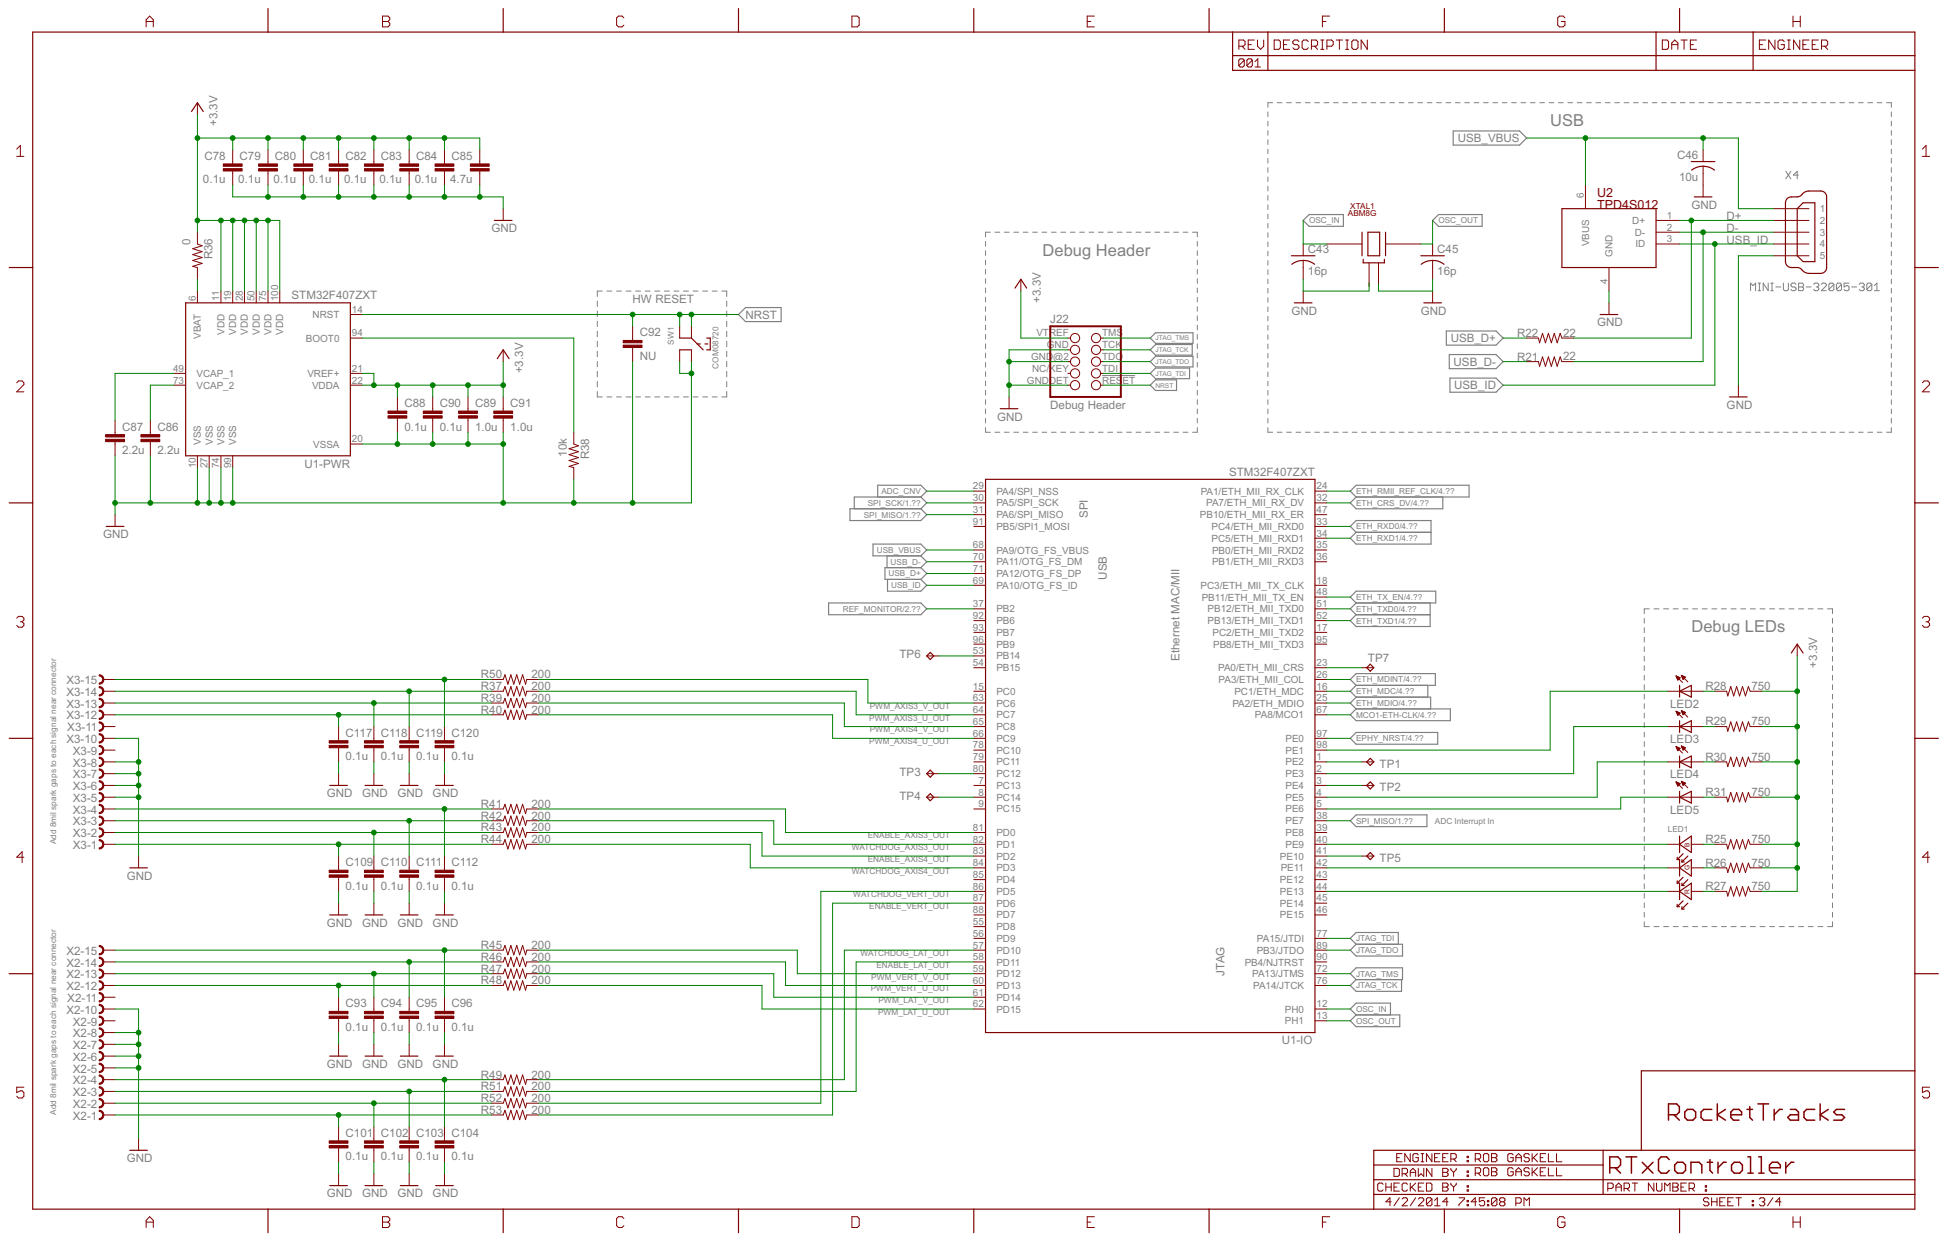
[picture p64: page 3]

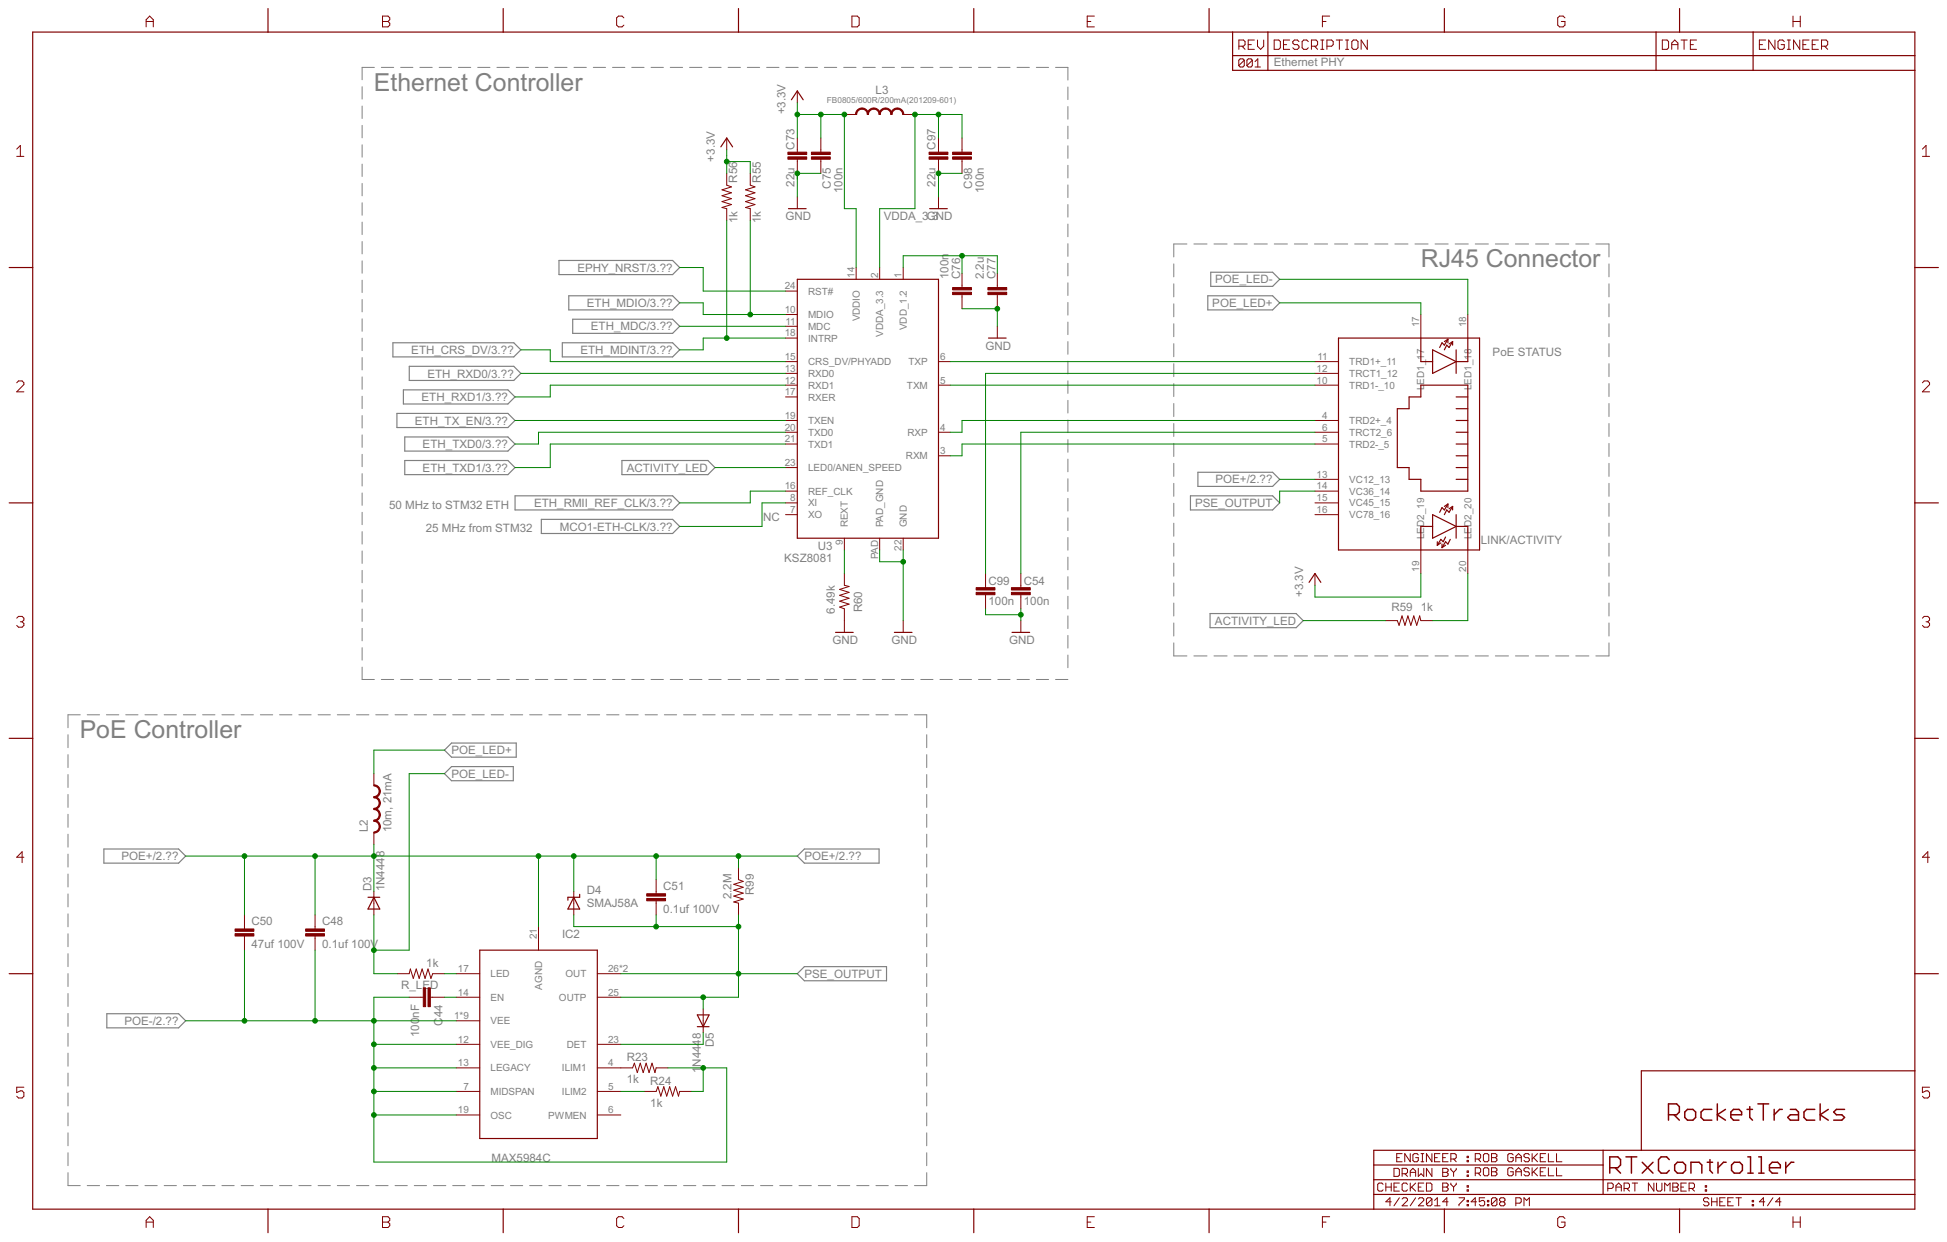
[picture p65: page 4]
