psas/rocket-tracks/Documentation/Firmware/Manual Peripherals.pdf

# Manual Peripherals

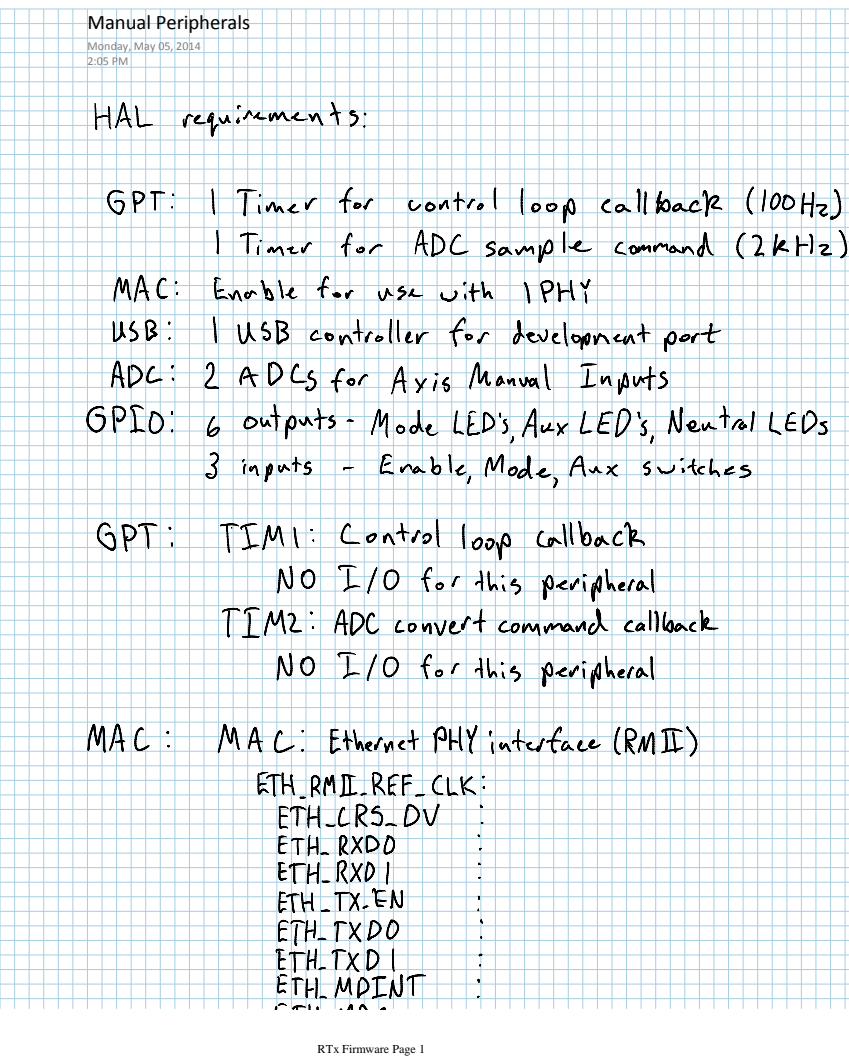
[picture p66: page 1]

Monday, May 05, 2014
2:05 PM

RTx Firmware Page 1

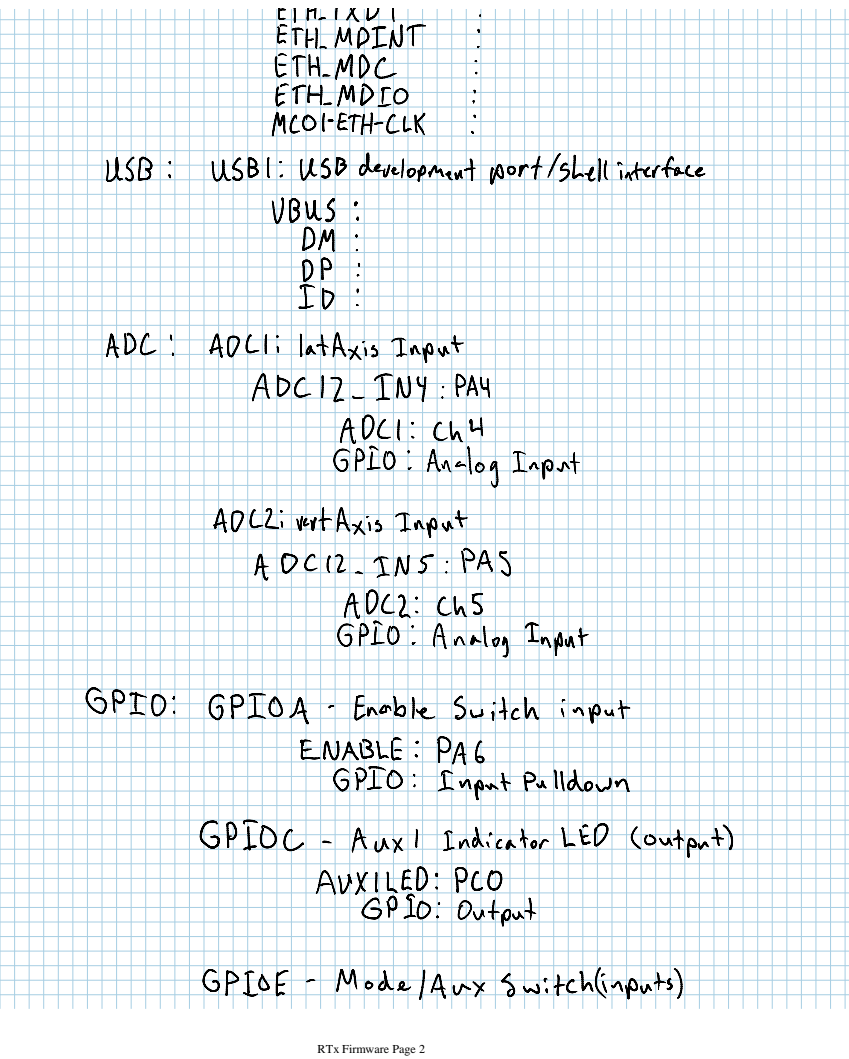
[picture p67: page 2]

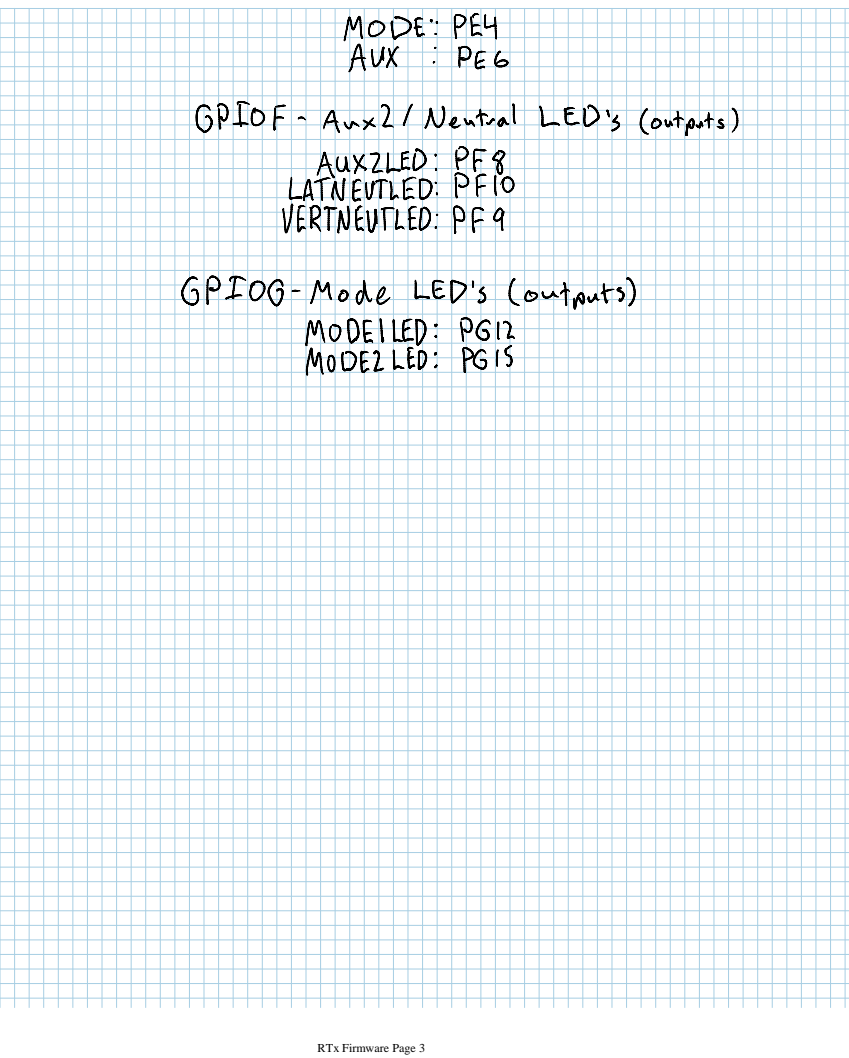
[picture p68: page 3]
