psas/rocket-tracks/Documentation/Firmware/RTx Controller Peripherals.pdf

# Peripherals

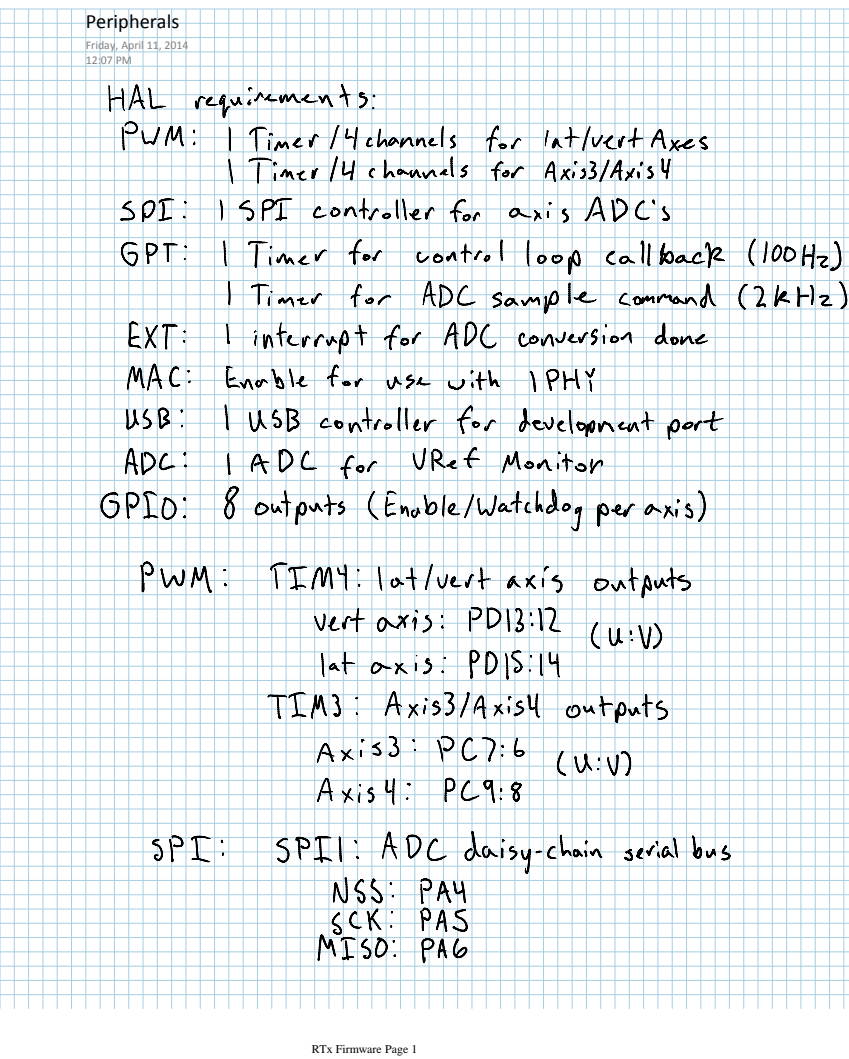
[picture p69: page 1]
Friday, April 11, 2014 12:07 PM

RTx Firmware Page 1

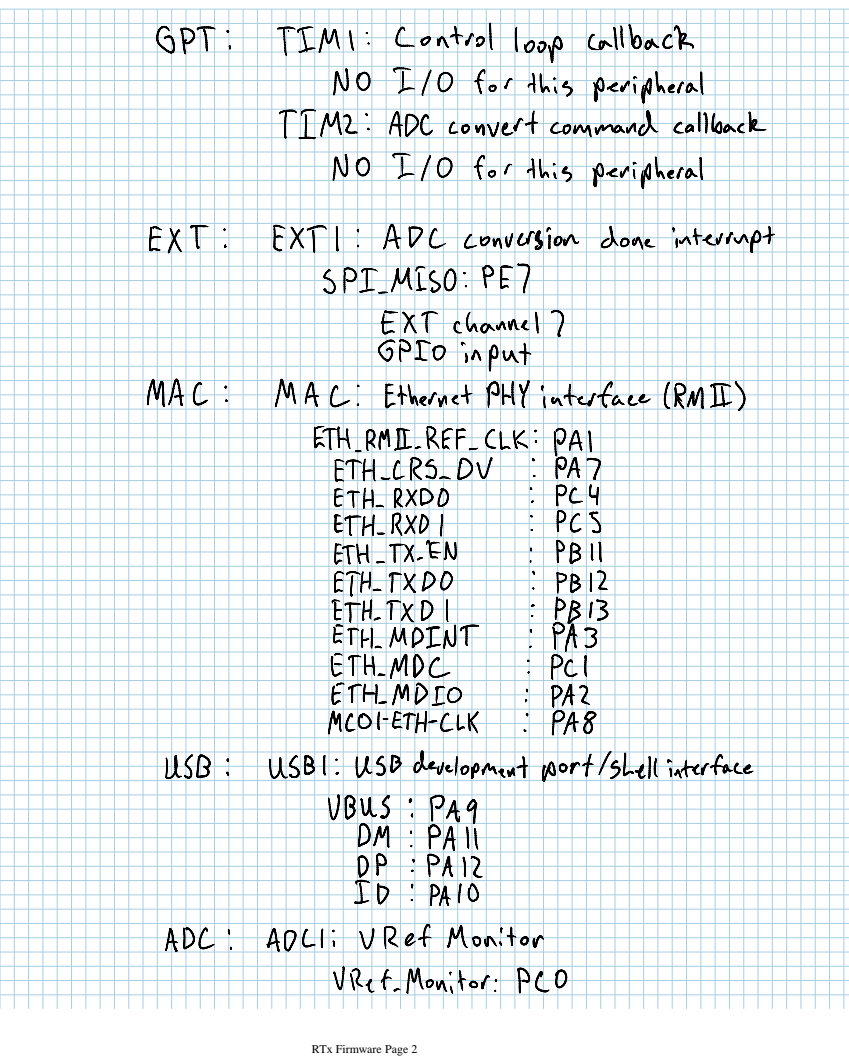
[picture p70: page 2]

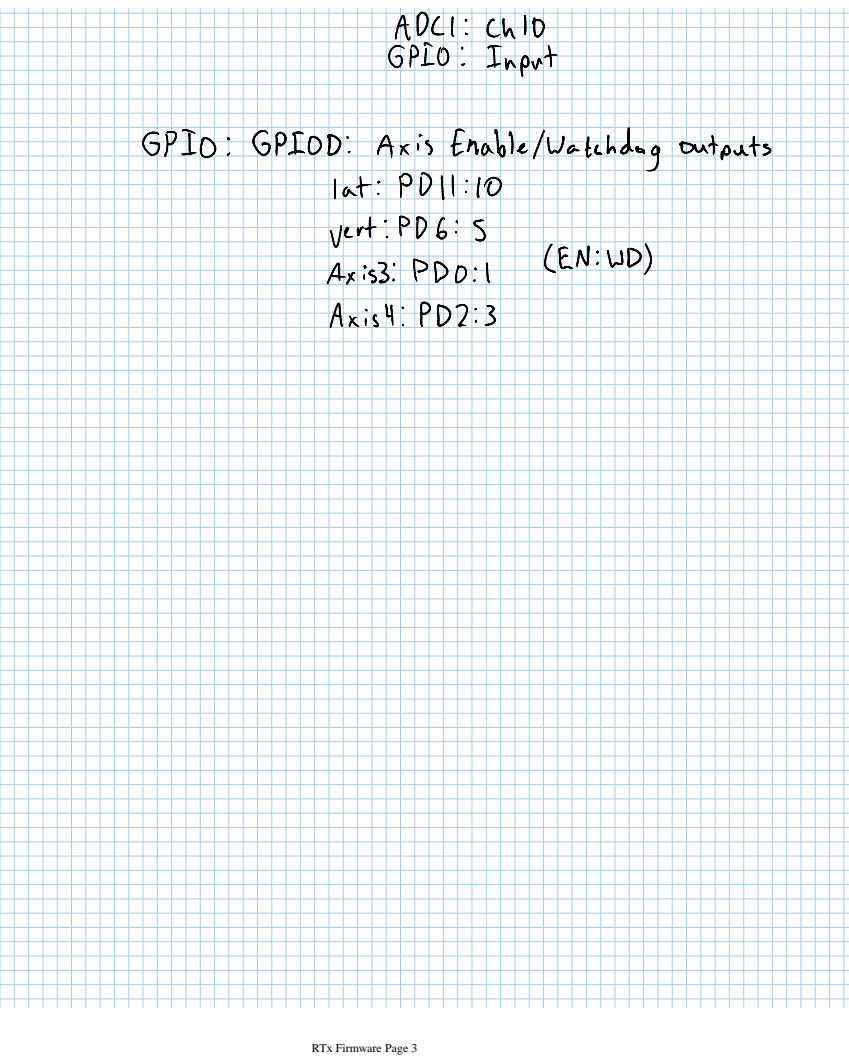
[picture p71: page 3]
