psas/rocket-tracks/Documentation/Firmware/Dynamic Modeling.pdf

# Dynamic Modeling

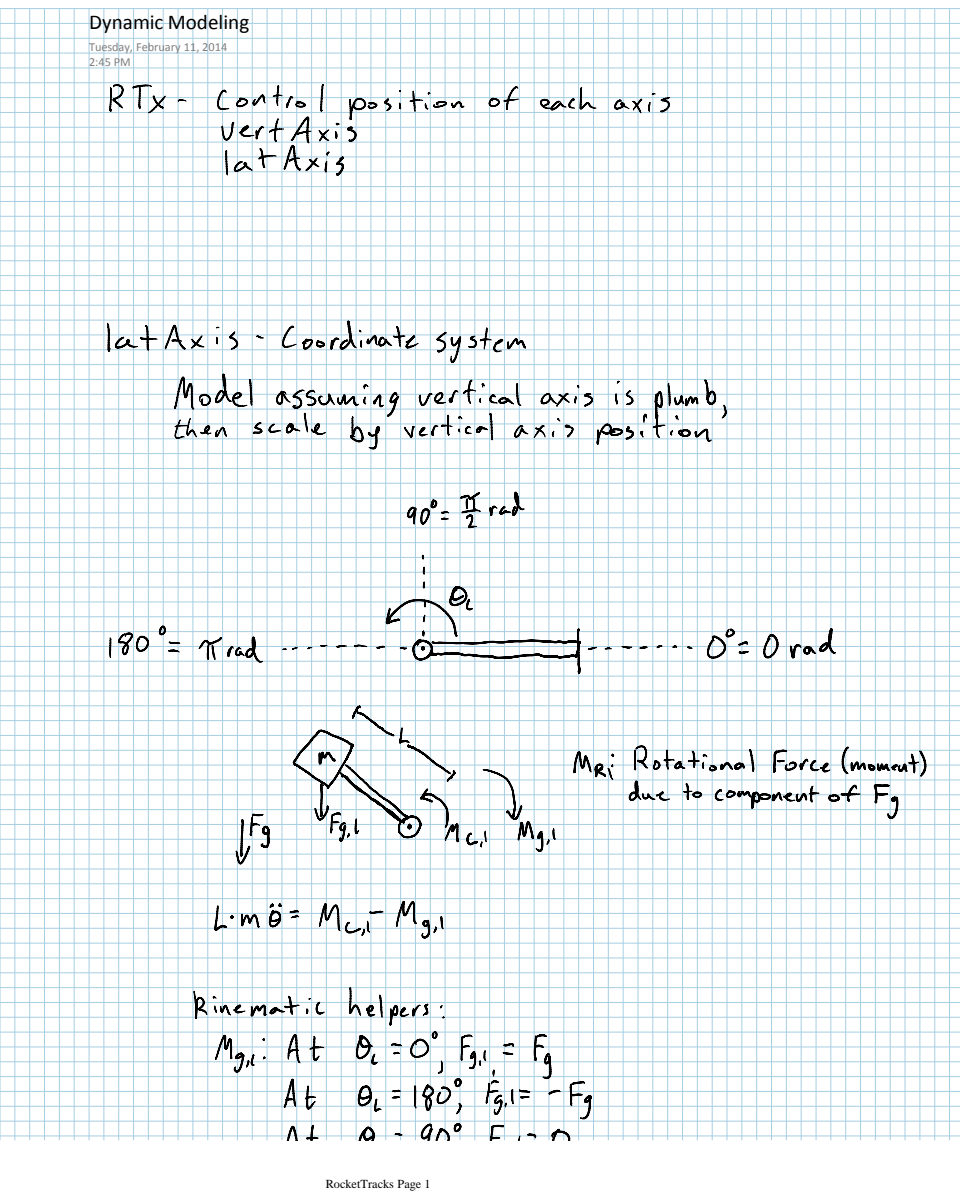
[picture p72: page 1]
Tuesday, February 11, 2014 2:45 PM; RocketTracks Page 1

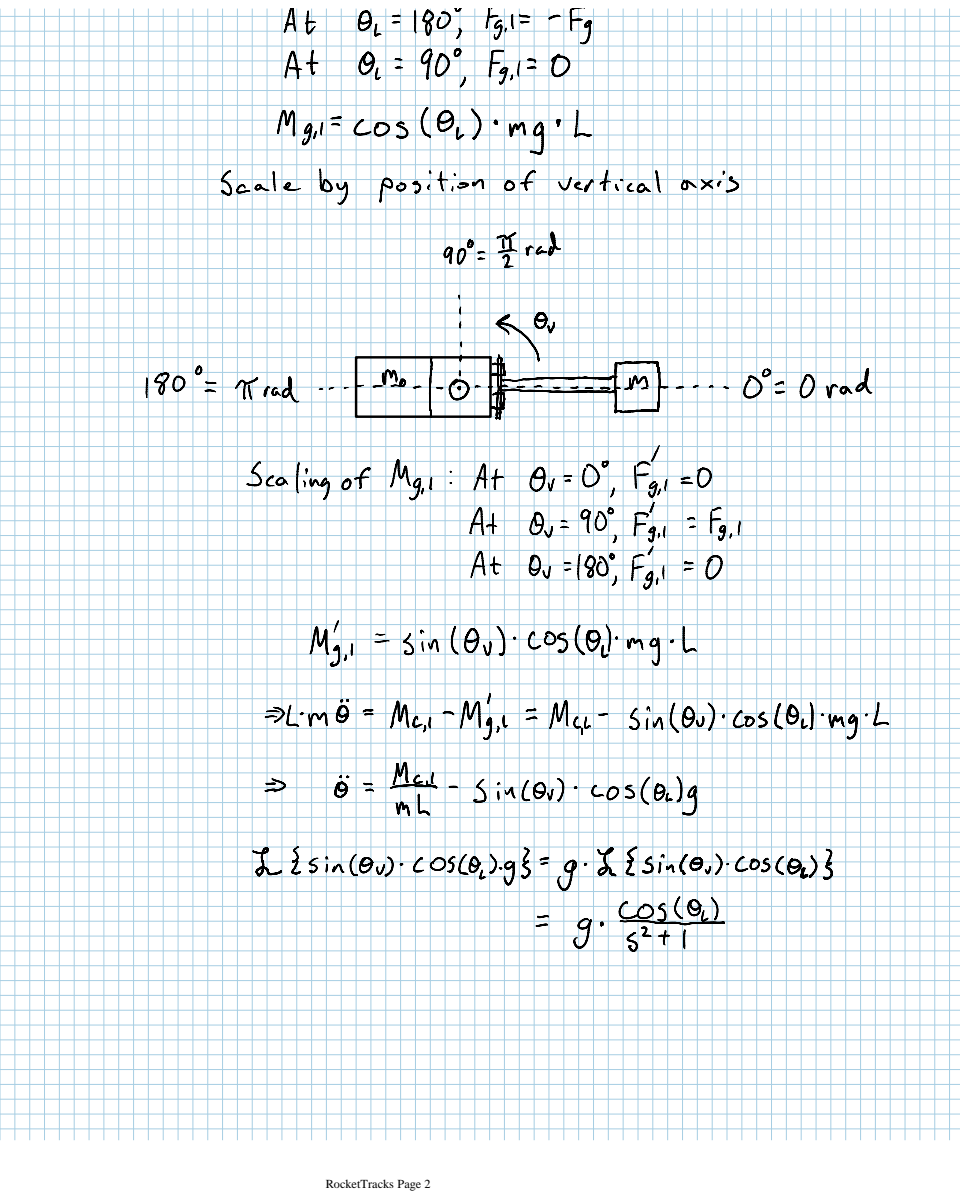
[picture p73: page 2]

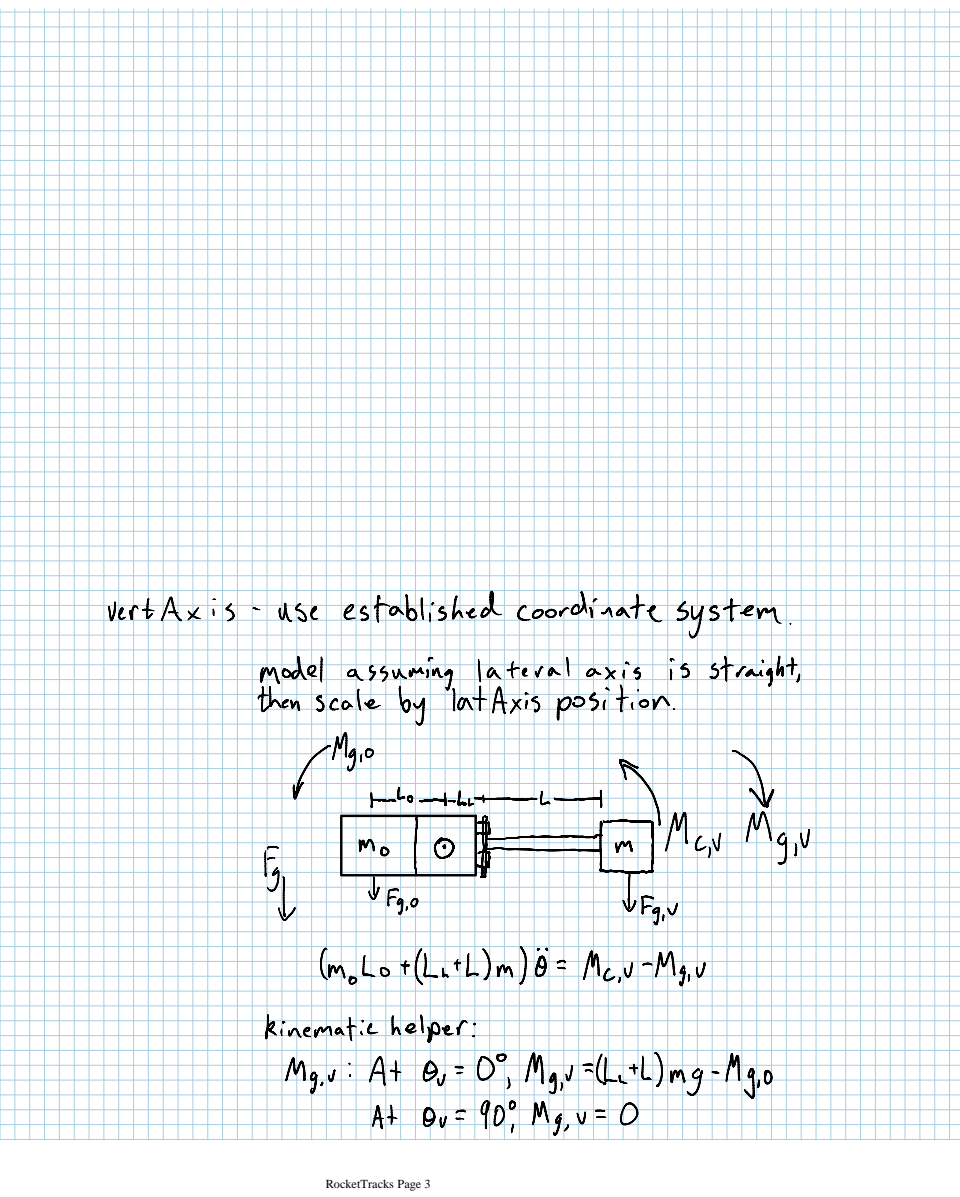
[picture p74: page 3]

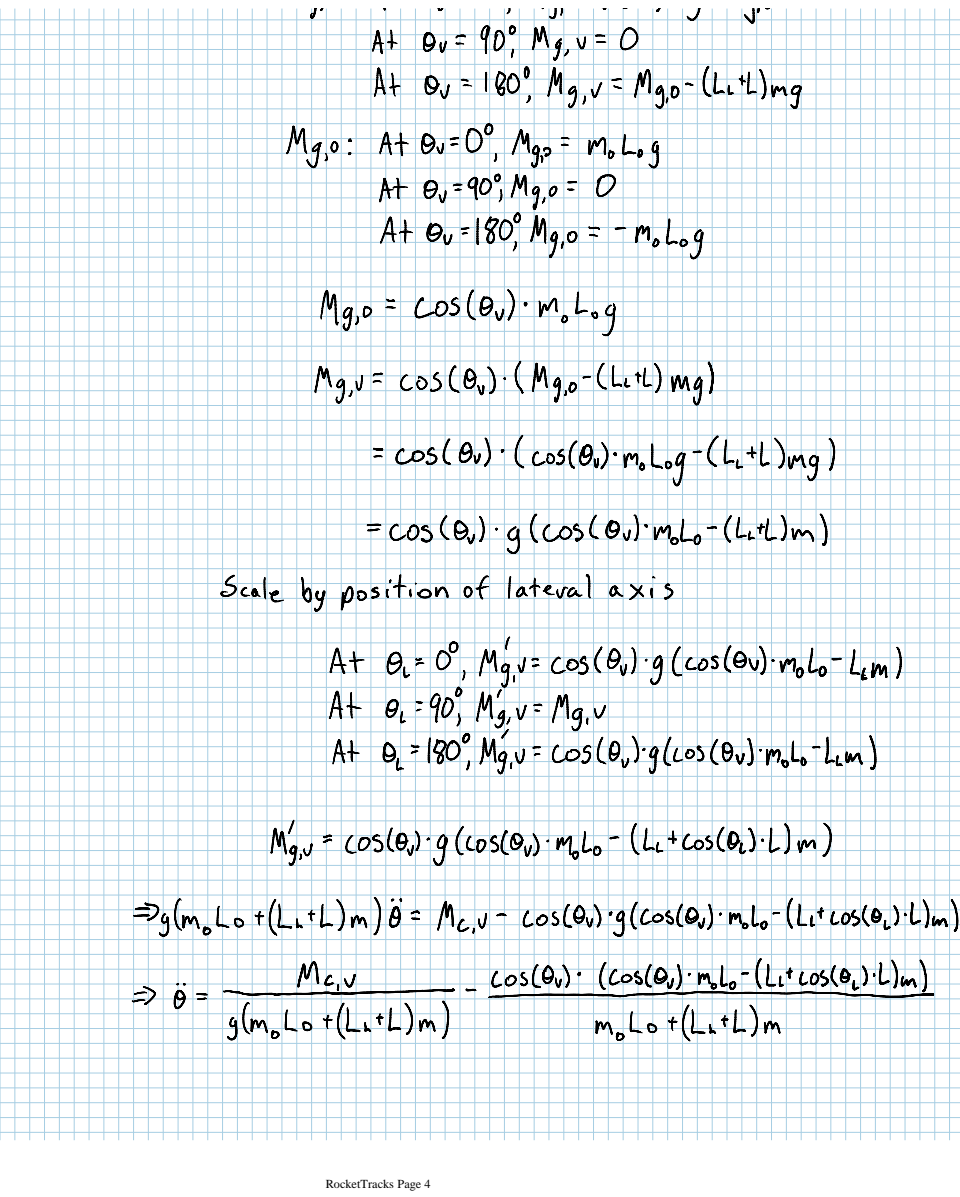
[picture p75: page 4]
