psas/rocket-tracks/Documentation/Firmware/Dynamic Modeling/Dynamic Modeling VIII.pdf

# Dynamic Modeling VIII

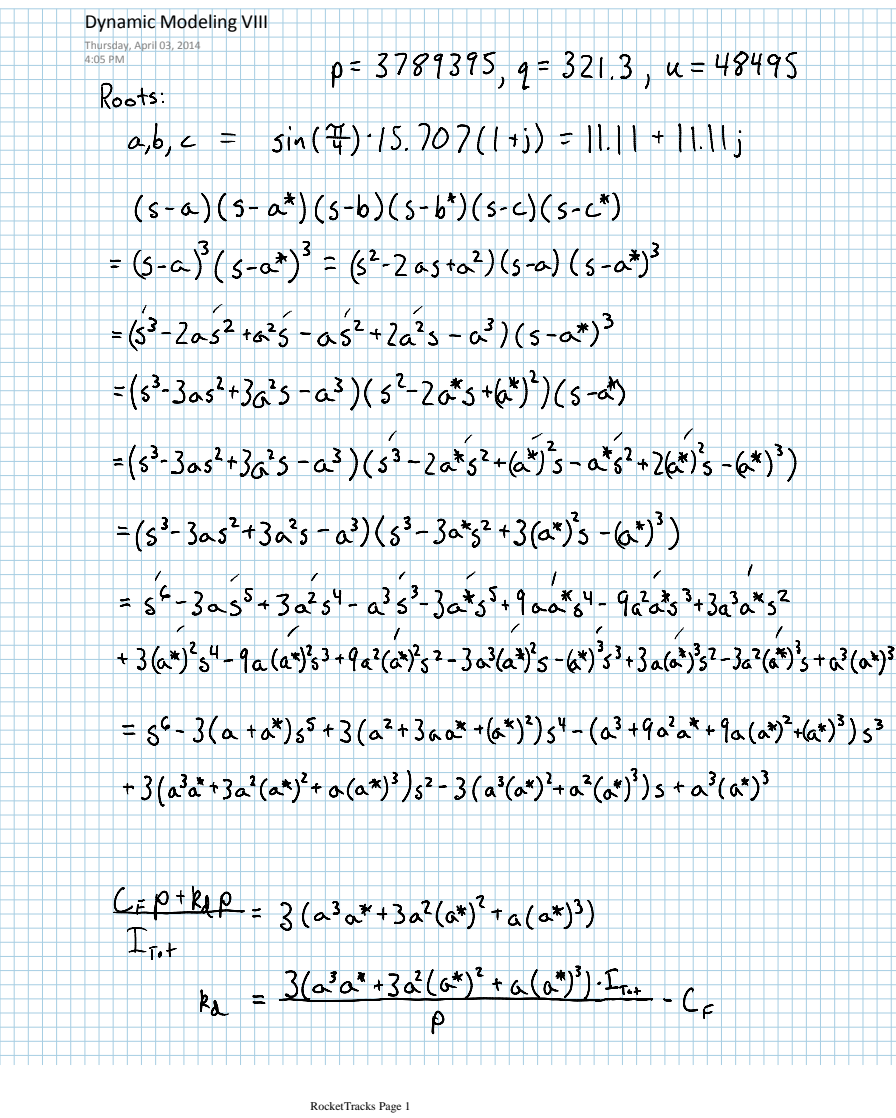
[picture p76: page 1]
RocketTracks Page 1

Thursday, April 03, 2014
4:05 PM

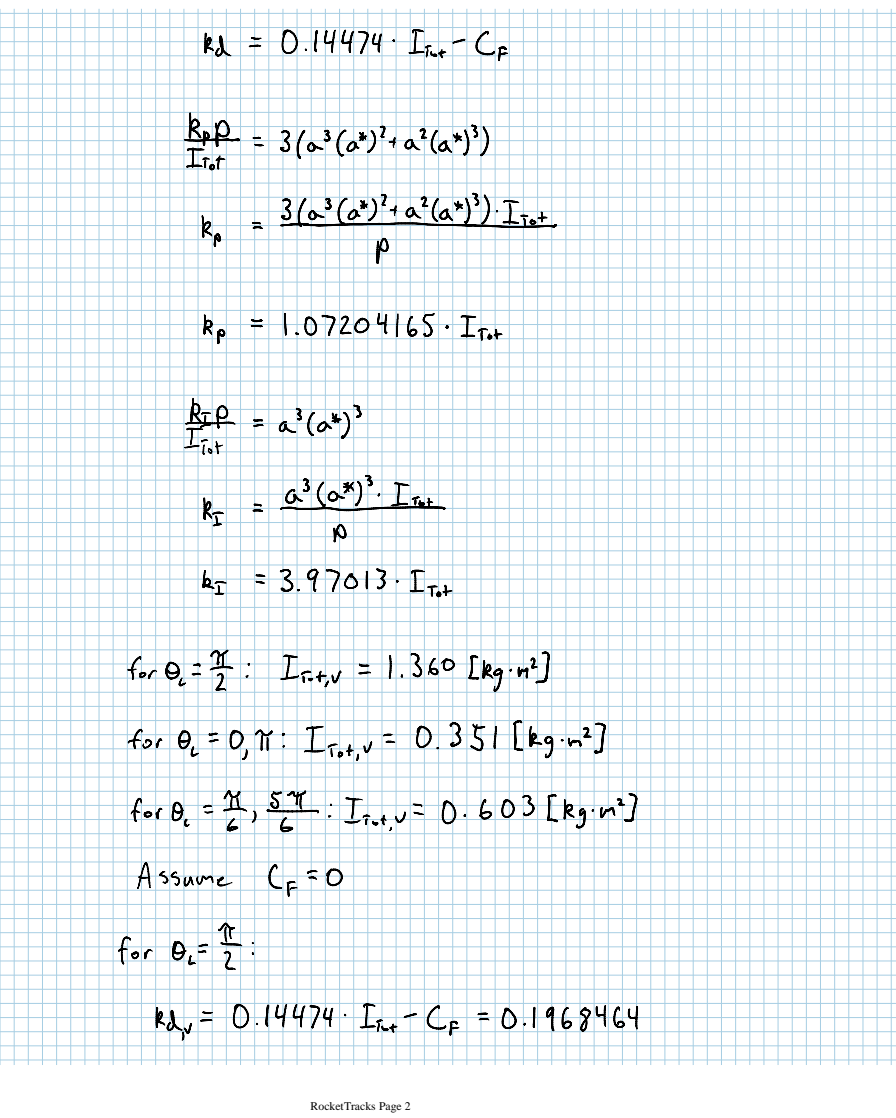
[picture p77: page 2]

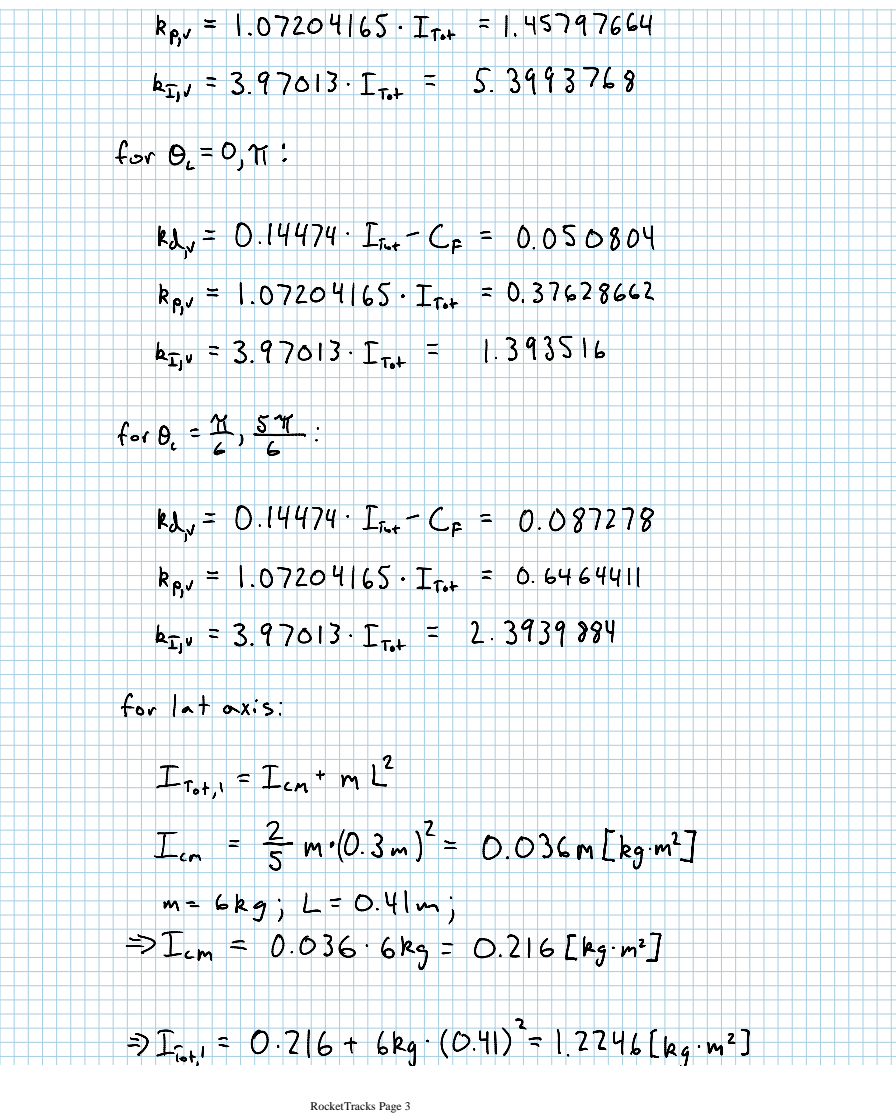
[picture p78: page 3]

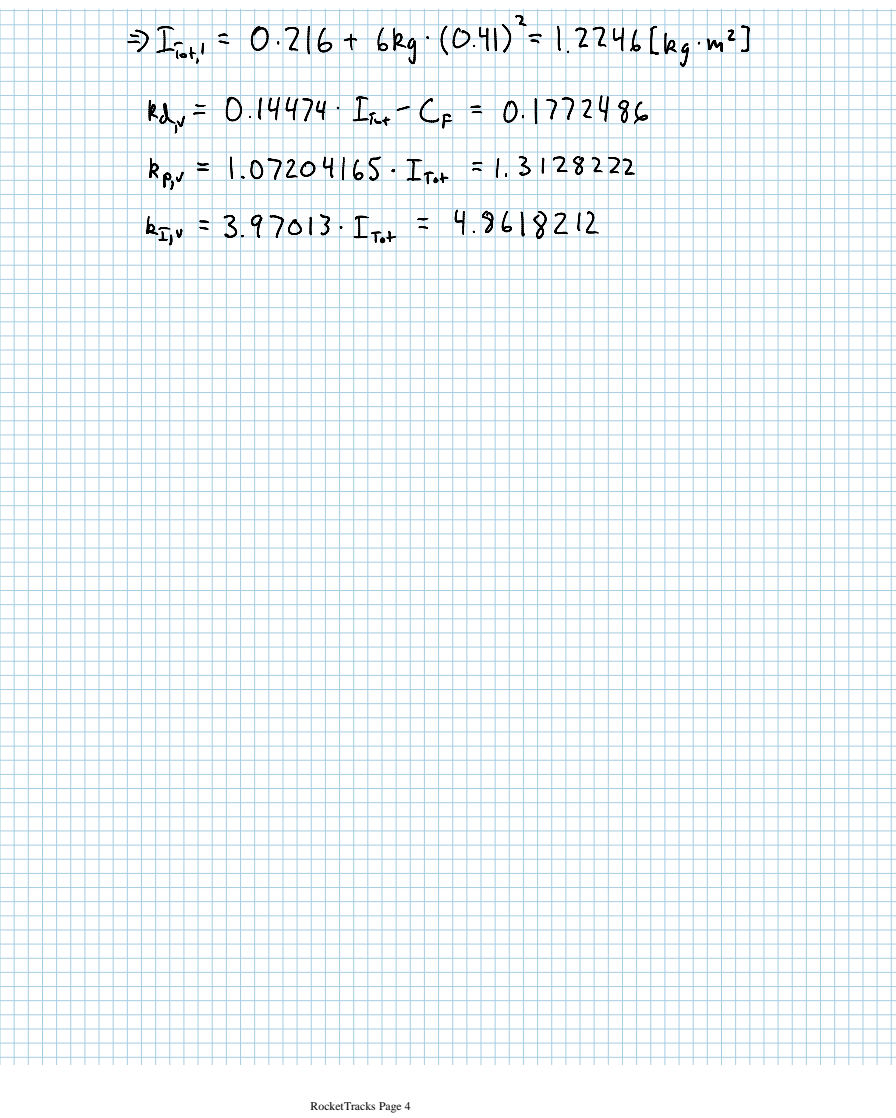
[picture p79: page 4]
