psas/rocket-tracks/Documentation/Firmware/Dynamic Modeling/Dynamic Modeling VII.pdf

# Dynamic Modeling VII

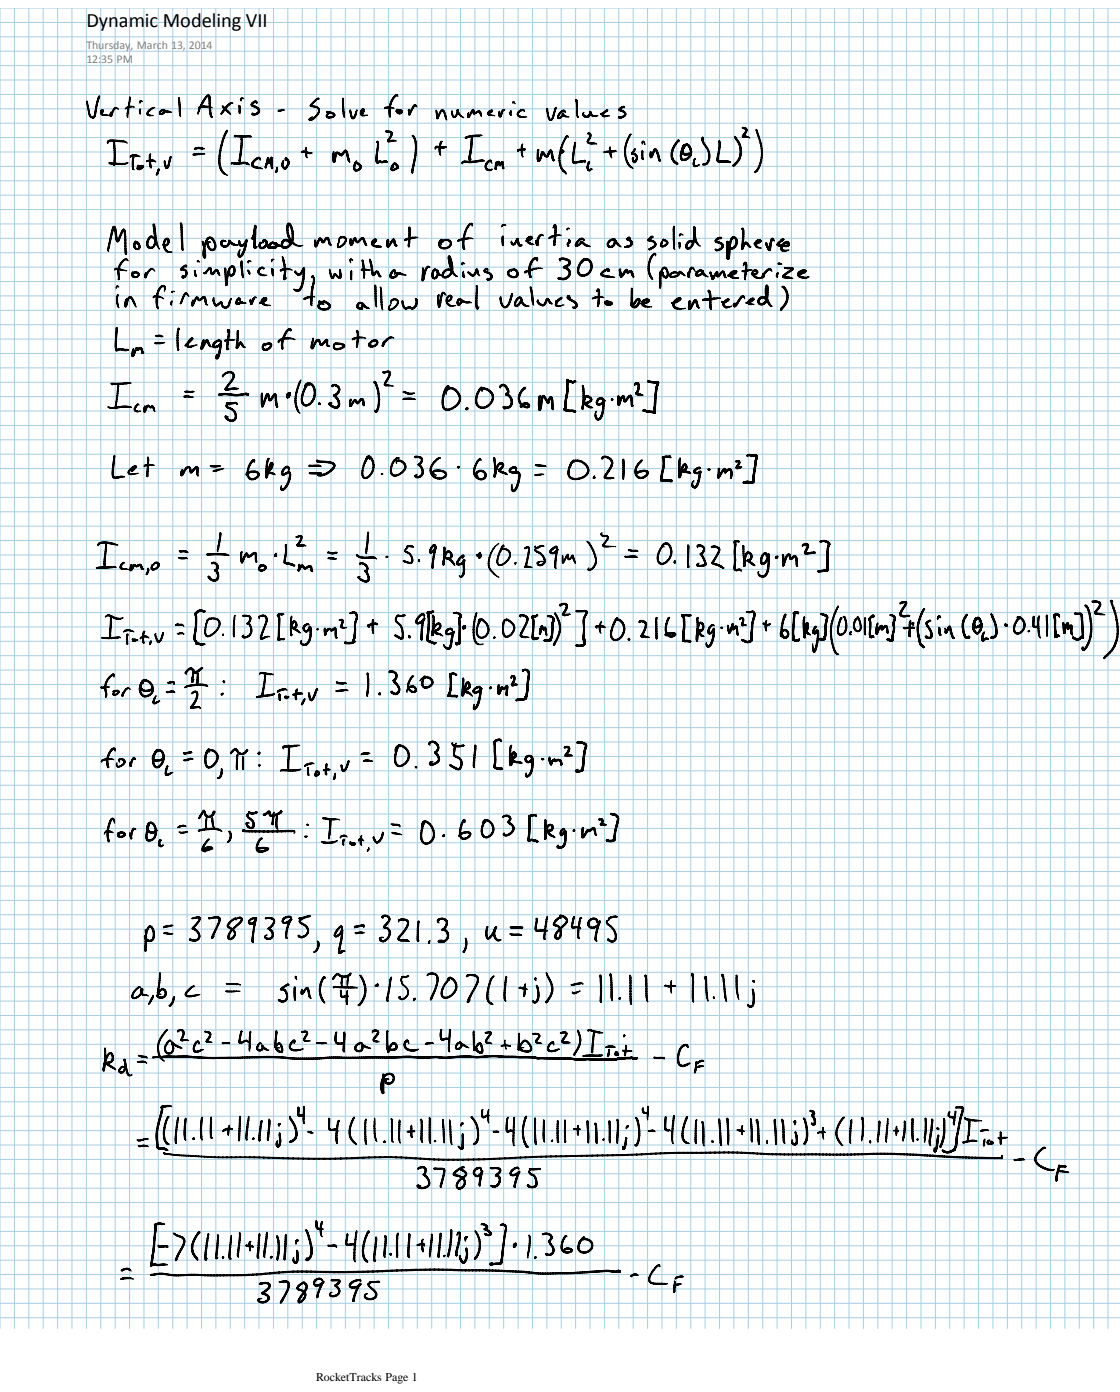
[picture p80: page 1]
Thursday, March 13, 2014 12:35 PM; RocketTracks Page 1

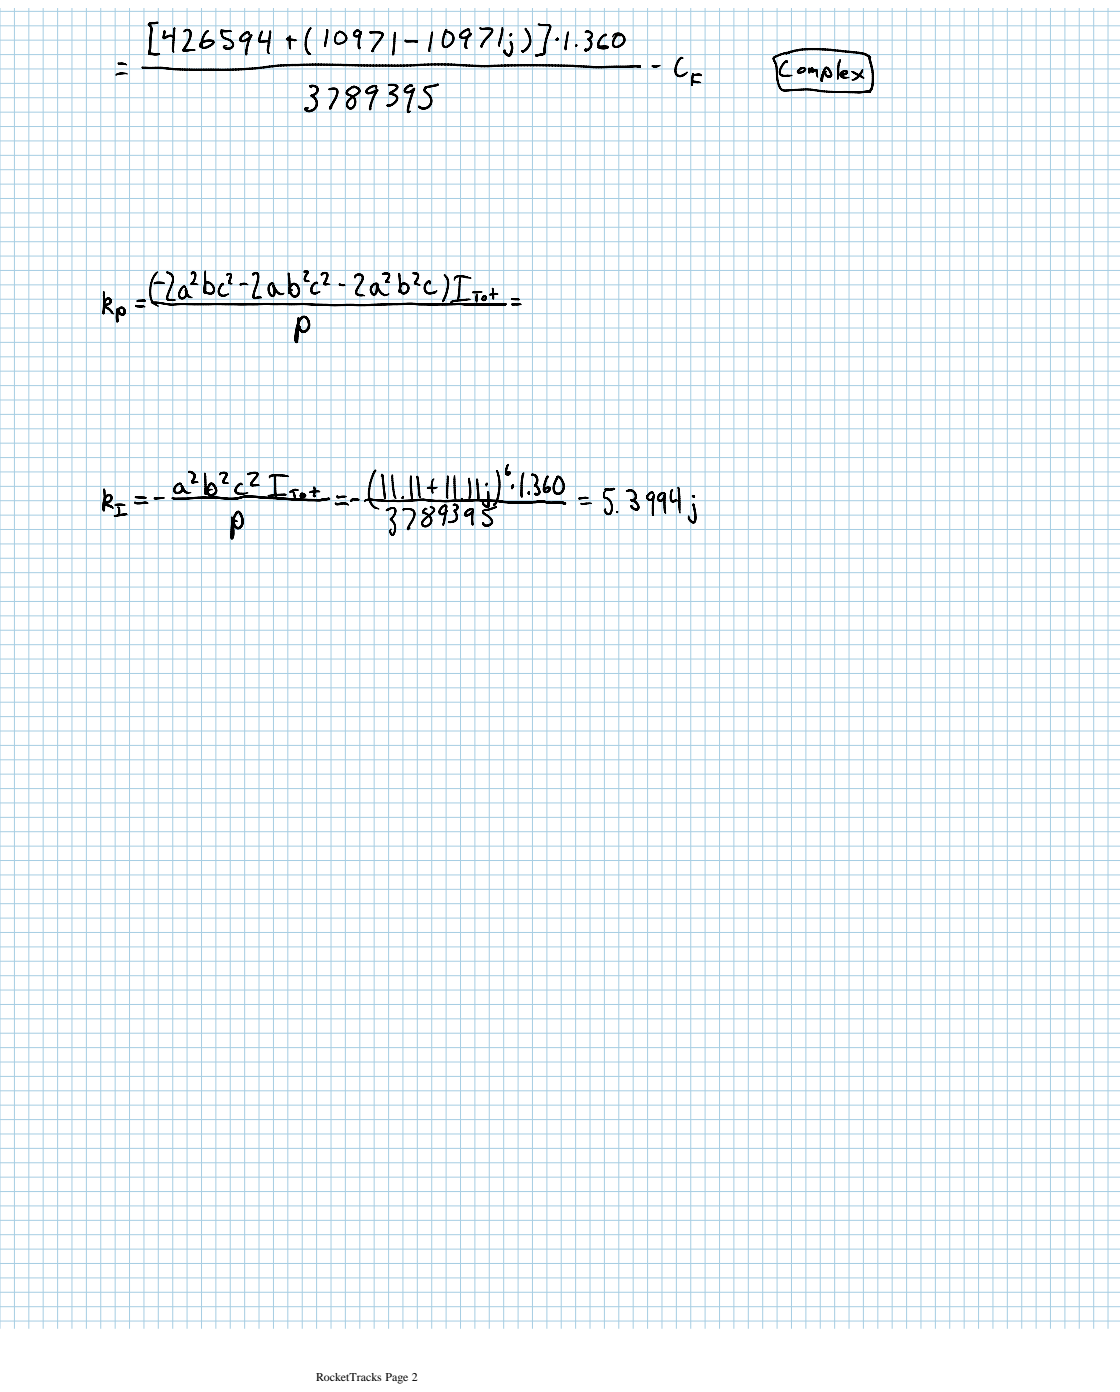
[picture p81: page 2]
RocketTracks Page 2
