psas/rocket-tracks/Documentation/Firmware/Dynamic Modeling/Dynamic Modeling VI.pdf

# Dynamic Modeling VI

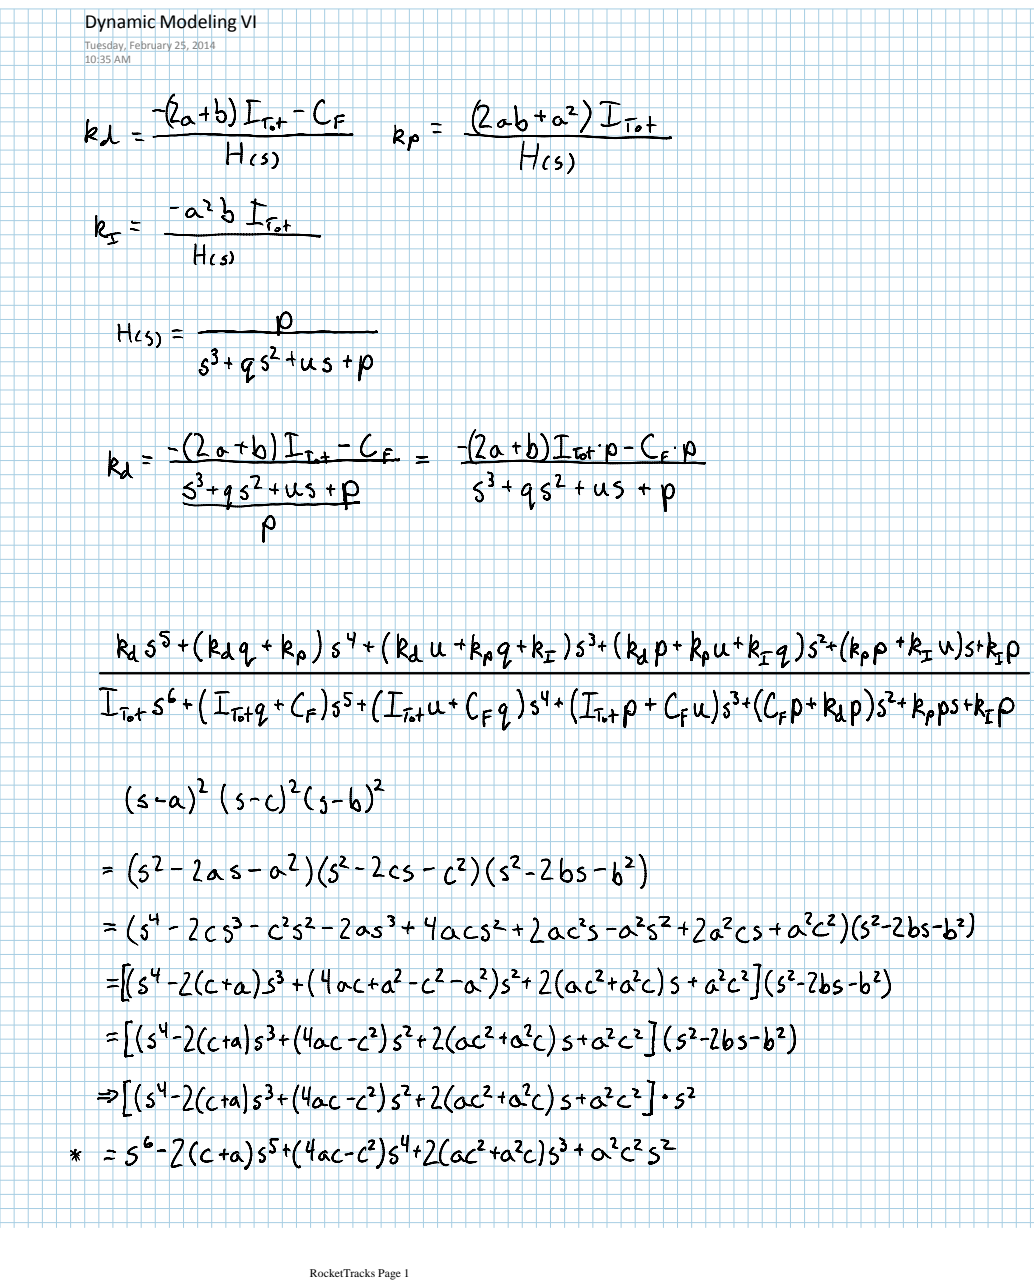
[picture p82: page 1]
RocketTracks Page 1

Tuesday, February 25, 2014
10:35 AM

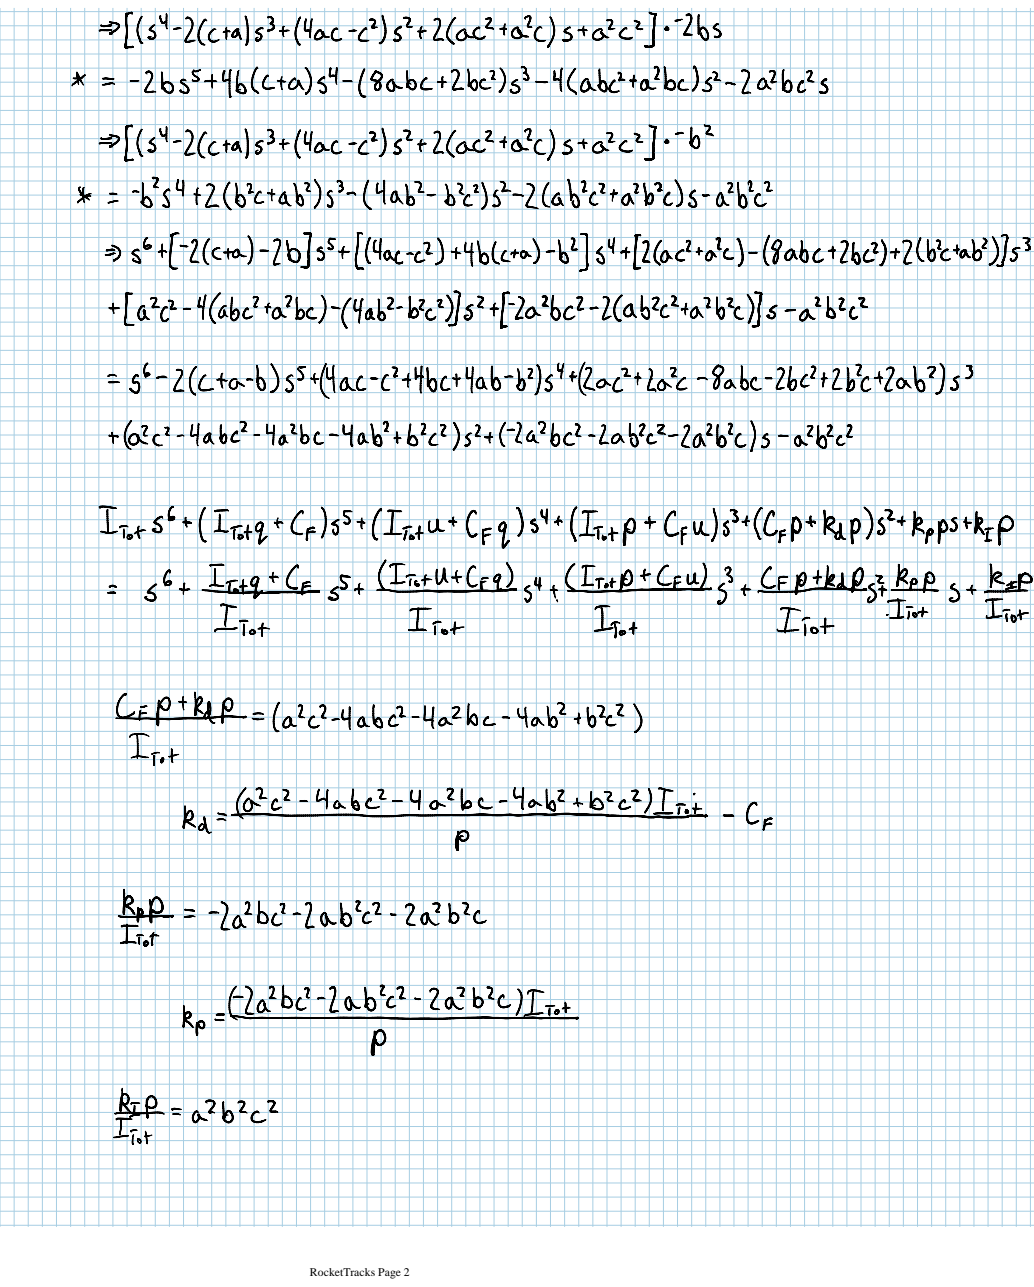
[picture p83: page 2]

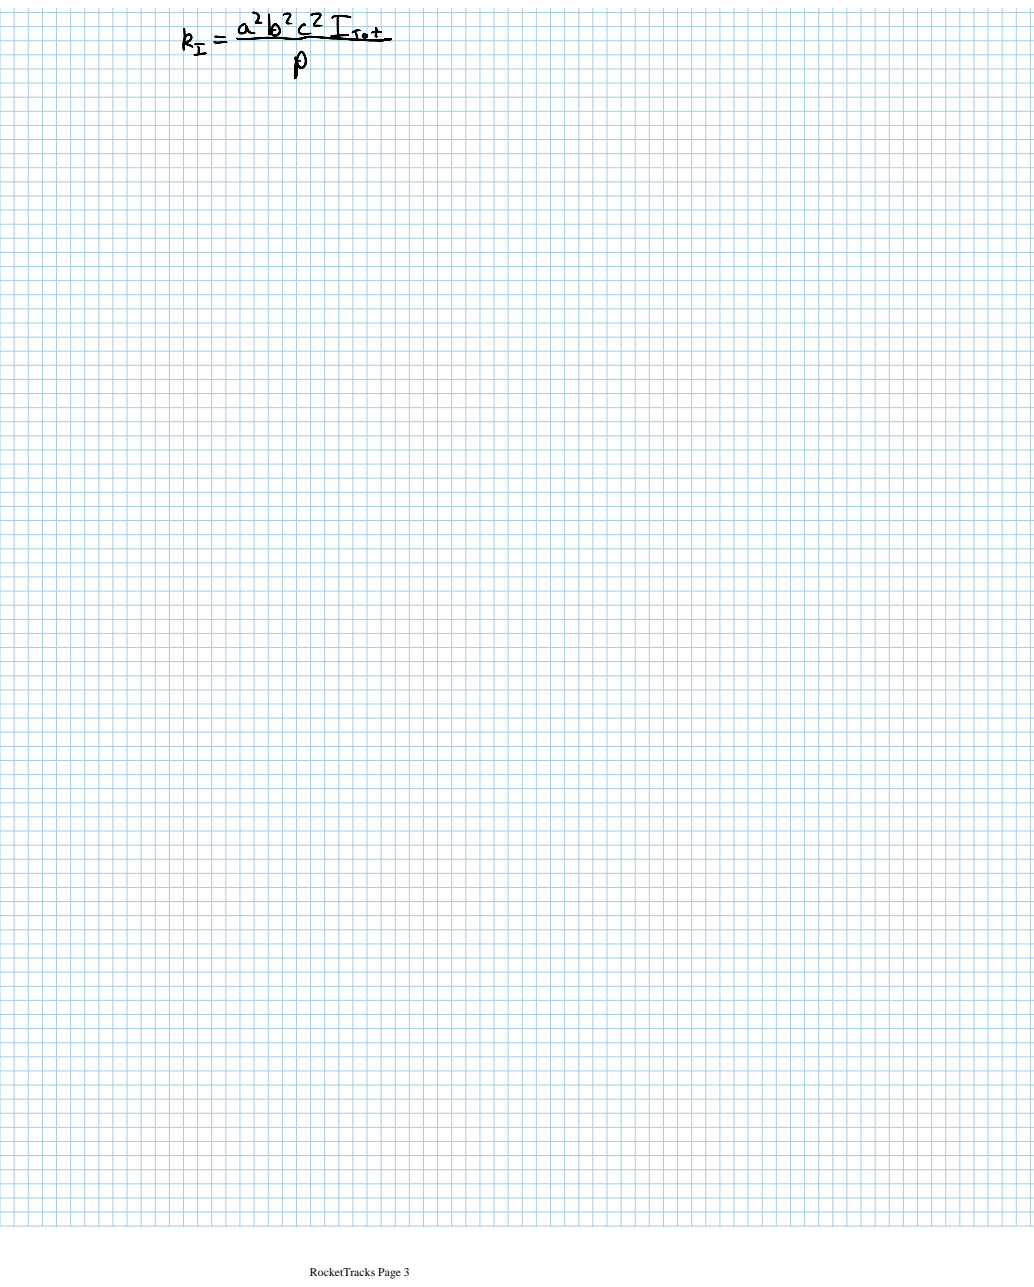
[picture p84: page 3]
