psas/rocket-tracks/Documentation/Firmware/Dynamic Modeling/Dynamic Modeling IV.pdf

# Dynamic Modeling IV

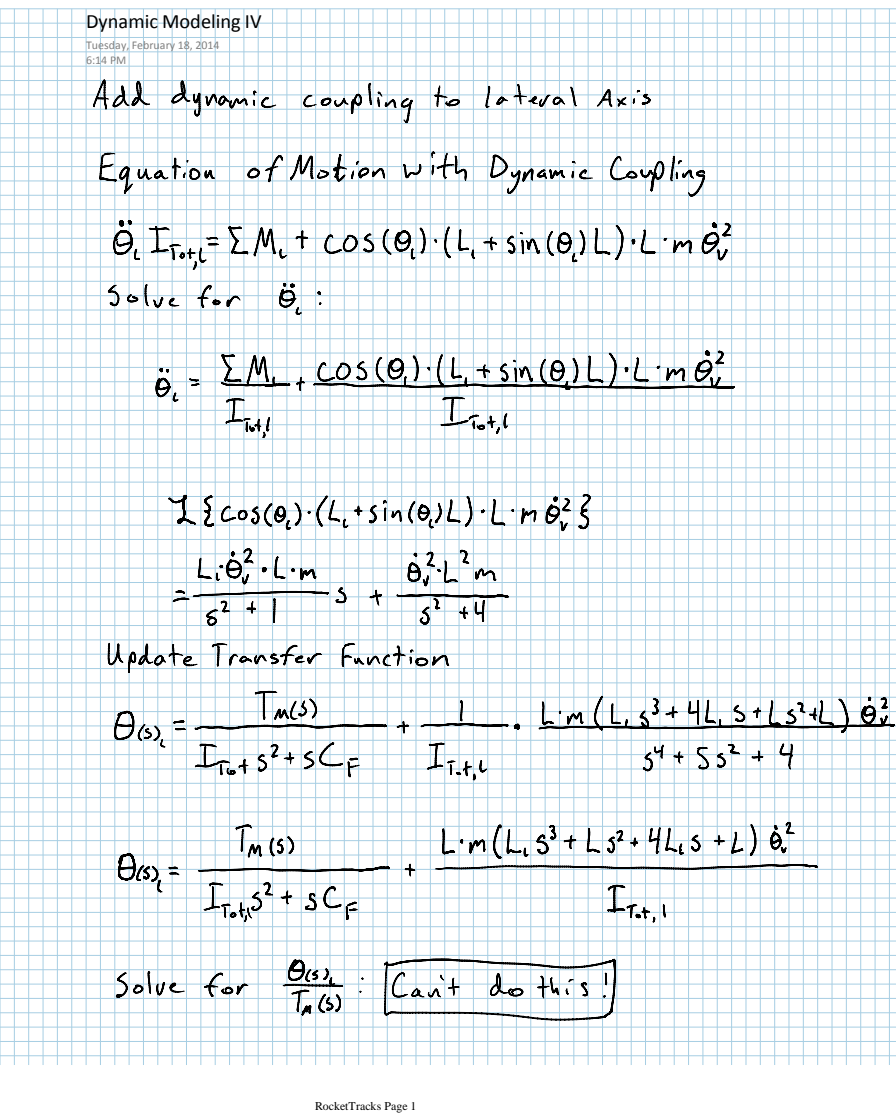
[picture p85: page 1]
Tuesday, February 18, 2014 6:14 PM; RocketTracks Page 1
