psas/rocket-tracks/RTx_Main_Power/Simulations/RTx_Charger_Alternative.asc

Cap_array: cap; 1
E-Stop: csw; ""
IC1: TL331
Main_Switch: csw; ""
Q1: nmos; STW11NM80
R1: res; 10k
R2: res; 230k
Relay1: Relay2
Relay2: Relay2; SAS-4410
Relay3: Relay2; SAS-4410
TEH70: res; ""
VBAT: voltage; 24
X2: dashed_line2
X21: dashed_line2
X22: dashed_line2
X23: dashed_line2
X24: dashed_line2
X25: dashed_line2
X26: dashed_line2
X27: dashed_line2
Named nets: FUSE
Off-board capacitor array
