psas/rocket-tracks/RTx_Main_Power/Simulations/RTx_Charger.asc

Cap_array: cap; 1
DPST_Relay_Latch: Relay; G4W-2214P-US-HP
IC1: TL331
Q1: nmos; STW11NM80
R1: res; 10k
R2: res; 230k
Relay1: Relay2; SAS-4410
Relay2: Relay2
Relay3: Relay2; SAS-4410
TEH70: res; 10
Toggle_Switch: csw; ""
VBAT: voltage; 24
X1: dashed_line2
X2: dashed_line2
X3: dashed_line
X4: dashed_line
X5: dashed_line
X6: dashed_line2
X7: dashed_line
X8: dashed_line
X9: dashed_line2
X10: dashed_line
X11: dashed_line
X12: dashed_line
X13: dashed_line
X14: dashed_line
X15: dashed_line
X16: dashed_line
X17: dashed_line
X18: dashed_line
X19: dashed_line
X20: dashed_line
Off-board, high current relay
Off-board, high current relay
Off-board capacitor array
