psas/rocket-tracks/RTx_Controller_Board/simulations/ESD.asc

C1: cap; 0.1µ
C2: cap; 0
C3: cap; 150p
C4: cap; 7p
D1: schottky
R1: res; 200
R2: res; 330
R3: res; 100Meg
R4: res; 2
V1: voltage; PULSE(8k 0v 0.1u)
V2: voltage; PULSE(8k 0)
Named nets: 0
.tran 0.0001
