psas/rocket-tracks/RTx_Controller_Board/simulations/ESD_Switching.asc

C1: cap; 0.1µ; Rser=1
R1: res; 200
V1: voltage; PULSE(0 3.3 0 10n 10n 0.5m 1m 5)
Named nets: 0, Vout
.tran 0.01
