psas/rocket-tracks/RTx_Controller_Board/simulations/PowerInput.asc

C1: cap; 0.1µ
C2: cap; 50µ
L1: ind; 10µ; Rser=7
V1: voltage; 36
Named nets: 0
.tran 0.01 startup
