psas/rocket-tracks/RTx_Controller_Board/RTxController.brd

## EAGLE design RTx_Controller_Board/RTxController.brd (2014-05-15)

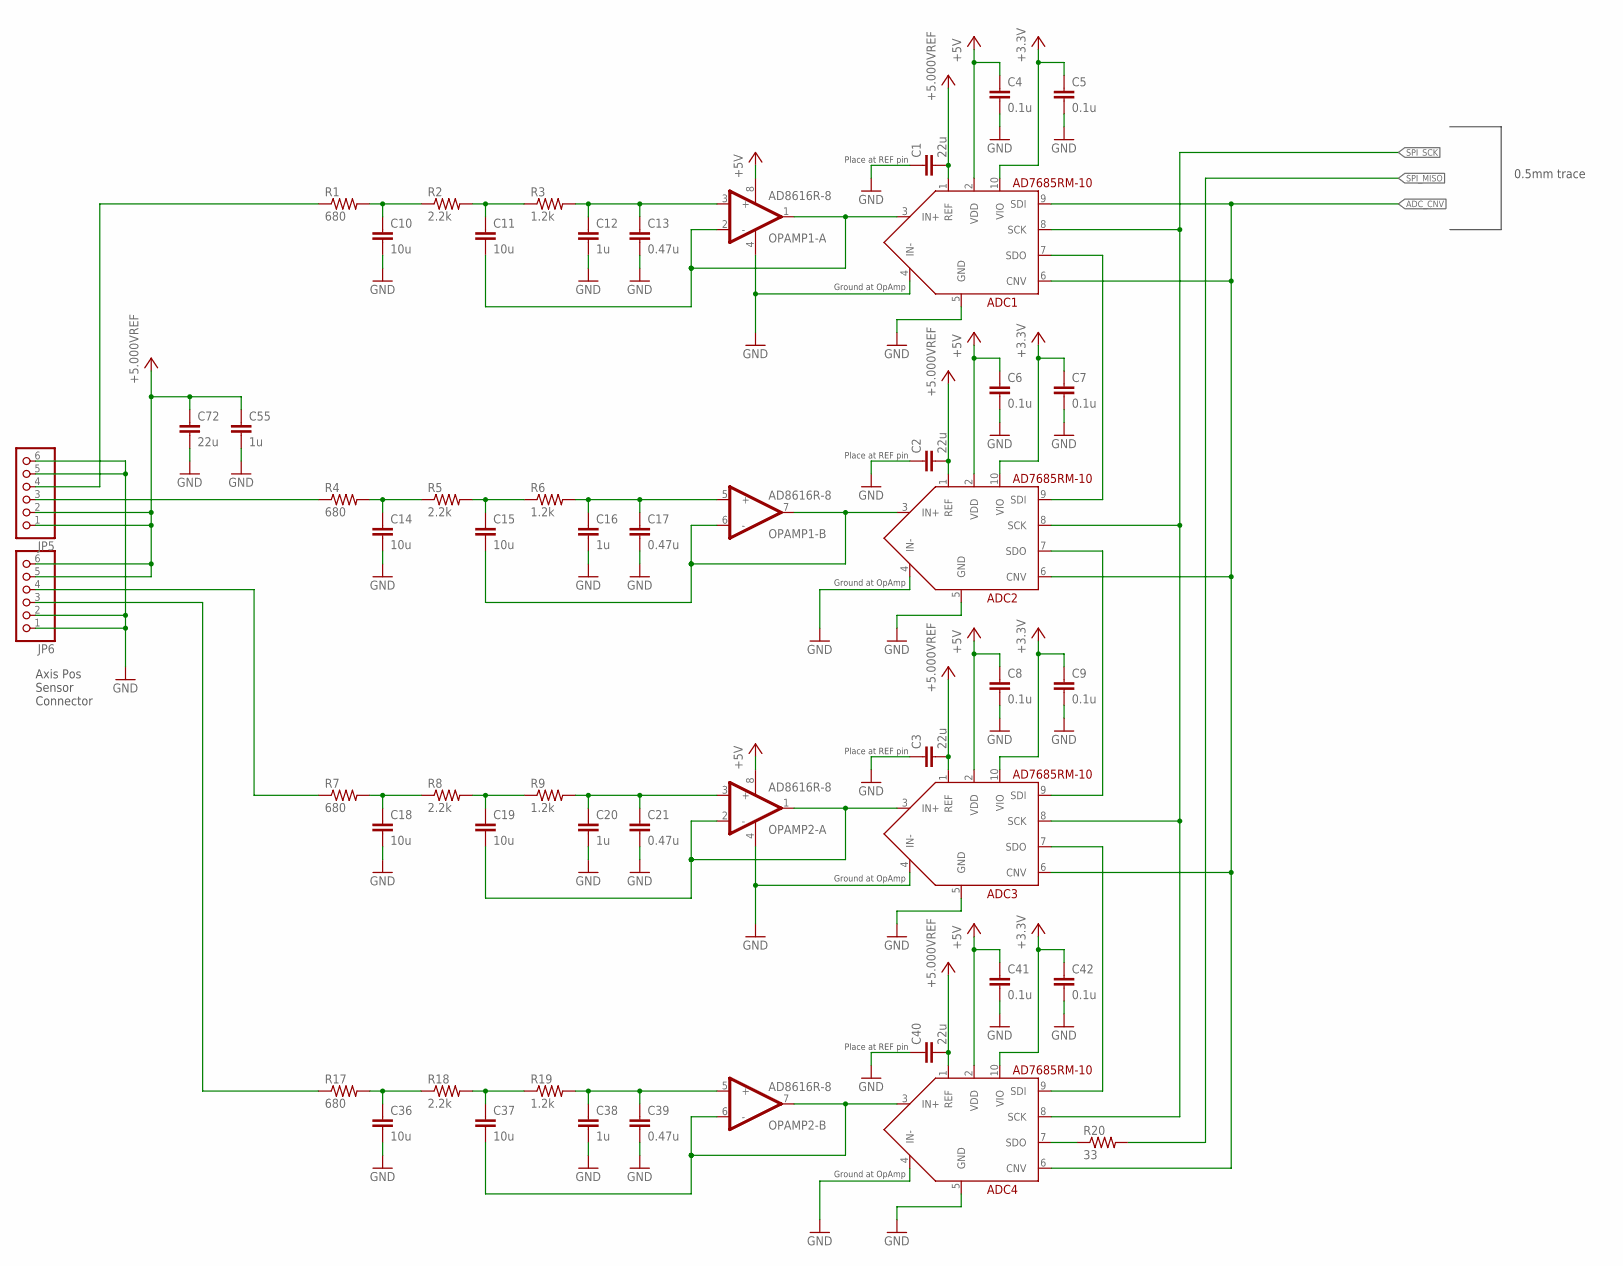
[picture p86: schematic RTxController.sch, sheet 1, Analog]

Parts:
ADC1, ADC2, ADC3, ADC4: AD7685RM-10; MSOP-10
C1, C2, C3, C40, C72: 22u; C1206
C4, C5, C6, C7, C8, C9, C41, C42: 0.1u; C0402
C10, C11, C14, C15, C18, C19, C36, C37: 10u; C1206
C12, C16, C20, C38, C55: 1u; C0805
C13, C17, C21, C39: 0.47u; C0805
JP5, JP6: PINHD-1X6; 1X06
OPAMP1, OPAMP2: AD8616R-8; SOIC8
R1, R4, R7, R17: 680; R0402
R2, R5, R8, R18: 2.2k; R0402
R3, R6, R9, R19: 1.2k; R0402
R20: 33; R0402

Connections:
+3.3V: ADC1.10 (VIO), ADC2.10 (VIO), ADC3.10 (VIO), ADC4.10 (VIO), C5.1, C7.1, C9.1, C42.1; also elsewhere on the board
+5.000VREF: ADC1.1 (REF), ADC2.1 (REF), ADC3.1 (REF), ADC4.1 (REF), C1.2, C2.2, C3.2, C40.2, C55.1, C72.1, JP5.1, JP5.2, JP6.5, JP6.6; also elsewhere on the board
+5V: ADC1.2 (VDD), ADC2.2 (VDD), ADC3.2 (VDD), ADC4.2 (VDD), C4.1, C6.1, C8.1, C41.1, OPAMP1.8 (V+), OPAMP2.8 (V+); also elsewhere on the board
ADC1_IN+: ADC1.3 (IN+), C11.2, OPAMP1.1 (OUT_A), OPAMP1.2 (-)
ADC2_IN+: ADC2.3 (IN+), C15.2, OPAMP1.6 (-), OPAMP1.7 (OUT_B)
ADC3_IN+: ADC3.3 (IN+), C19.2, OPAMP2.1 (OUT_A), OPAMP2.2 (-)
ADC4_IN: ADC4.3 (IN+), C37.2, OPAMP2.6 (-), OPAMP2.7 (OUT_B)
ADC_CNV: ADC1.6 (CNV), ADC1.9 (SDI), ADC2.6 (CNV), ADC3.6 (CNV), ADC4.6 (CNV); also elsewhere on the board
AXIS3_IN: JP6.4, R7.1
AXIS4_IN: JP6.3, R17.1
GND: ADC1.4 (IN-), ADC1.5 (GND), ADC2.4 (IN-), ADC2.5 (GND), ADC3.4 (IN-), ADC3.5 (GND), ADC4.4 (IN-), ADC4.5 (GND), C1.1, C2.1, C3.1, C4.2, C5.2, C6.2, C7.2, C8.2, C9.2, C10.2, C12.2, C13.2, C14.2, C16.2, C17.2, C18.2, C20.2, C21.2, C36.2, C38.2, C39.2, C40.1, C41.2, C42.2, C55.2, C72.2, JP5.5, JP5.6, JP6.1, JP6.2, OPAMP1.4 (V-), OPAMP2.4 (V-); also elsewhere on the board
LAT_AXIS_IN: JP5.4, R1.1
unnamed: C12.1, C13.1, OPAMP1.3 (+), R3.2
unnamed: C16.1, C17.1, OPAMP1.5 (+), R6.2
unnamed: C38.1, C39.1, OPAMP2.5 (+), R19.2
unnamed: C11.1, R2.2, R3.1
unnamed: C37.1, R18.2, R19.1
unnamed: C15.1, R5.2, R6.1
unnamed: C36.1, R17.2, R18.1
unnamed: C14.1, R4.2, R5.1
unnamed: C20.1, C21.1, OPAMP2.3 (+), R9.2
unnamed: C19.1, R8.2, R9.1
unnamed: C18.1, R7.2, R8.1
unnamed: C10.1, R1.2, R2.1
SDO1: ADC1.7 (SDO), ADC2.9 (SDI)
SDO2: ADC2.7 (SDO), ADC3.9 (SDI)
SDO3: ADC3.7 (SDO), ADC4.9 (SDI)
SDO4: ADC4.7 (SDO), R20.1
SPI_MISO: R20.2; also elsewhere on the board
SPI_SCK: ADC1.8 (SCK), ADC2.8 (SCK), ADC3.8 (SCK), ADC4.8 (SCK); also elsewhere on the board
VERT_AXIS_IN: JP5.3, R4.1

Notes on the sheet:
Axis Pos Sensor Connector
Ground at OpAmp
Place at REF pin
0.5mm trace

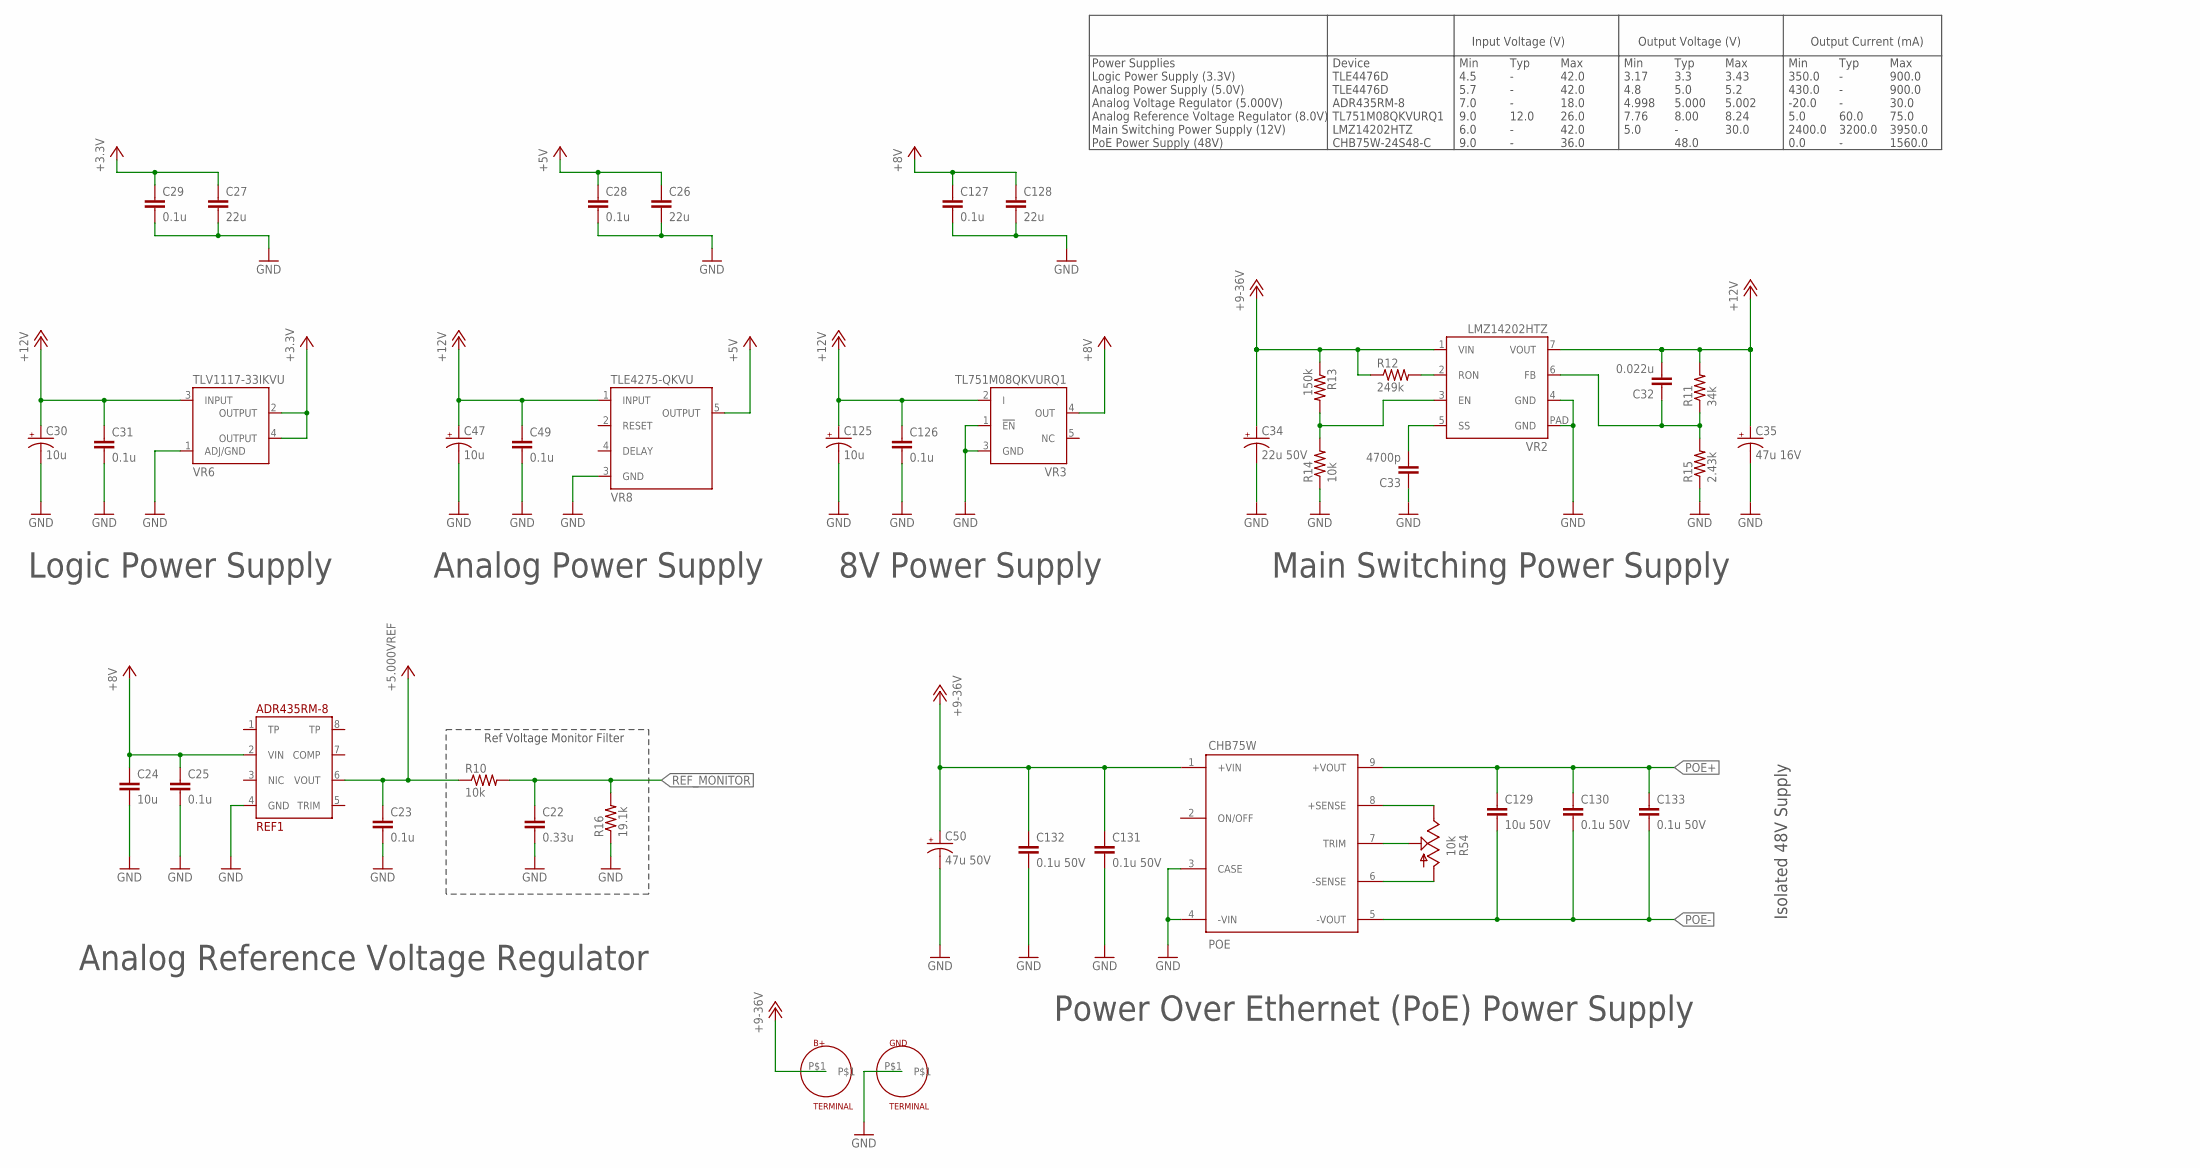
[picture p87: schematic RTxController.sch, sheet 2, Power]

Parts:
B+: TERMINAL; TERMINAL_RELAY
C22: 0.33u; C0603
C23, C25, C28, C29, C31, C49, C126, C127: 0.1u; C0402
C24: 10u; C1206
C26, C27, C128: 22u; C1206
C30, C47, C125: 10u; PANASONIC_B
C32: 0.022u; C0402
C33: 4700p; C0402
C34: 22u 50V; PANASONIC_B
C35: 47u 16V; PANASONIC_B
C50: 47u 50V; PANASONIC_C
C129: 10u 50V; C1206
C130, C131, C132, C133: 0.1u 50V; C0402
GND: TERMINAL; TERMINAL_RELAY
POE: CHB75W
R10: 10k; R0402
R11: 34k; R0603
R12: 249k; R0603
R13: 150k; R0603
R14: 10k; R0603
R15: 2.43k; R0603
R16: 19.1k; R0402
R54: 10k; 3223W
REF1: ADR435RM-8; SOIC8
VR2: LMZ14202HTZ; PFM-7
VR3: TL751M08QKVURQ1; PG-TO252-5-11
VR6: TLV1117-33IKVU; PG-TO252-3-11
VR8: TLE4275-QKVU; PG-TO252-5-11

Connections:
+3.3V: C27.1, C29.1, VR6.2 (OUTPUT), VR6.4 (OUTPUT); also elsewhere on the board
+5.000VREF: C23.1, R10.1, REF1.6 (VOUT); also elsewhere on the board
+5V: C26.1, C28.1, VR8.5 (OUTPUT); also elsewhere on the board
+8V: C24.1, C25.1, C127.1, C128.1, REF1.2 (VIN), VR3.4 (OUT)
+9-36V: B+.P$1, C34.+, C50.+, C131.1, C132.1, POE.1 (+VIN), R12.1, R13.1, VR2.1 (VIN)
+12V: C30.+, C31.1, C32.2, C35.+, C47.+, C49.1, C125.+, C126.1, R11.2, VR2.7 (VOUT), VR3.2 (I), VR6.3 (INPUT), VR8.1 (INPUT)
GND: C22.2, C23.2, C24.2, C25.2, C26.2, C27.2, C28.2, C29.2, C30.-, C31.2, C33.1, C34.-, C35.-, C47.-, C49.2, C50.-, C125.-, C126.2, C127.2, C128.2, C131.2, C132.2, GND.P$1, POE.3 (CASE), POE.4 (-VIN), R14.1, R15.1, R16.1, REF1.4 (GND), VR2.4 (GND), VR2.PAD (GND), VR3.1 (!EN!), VR3.3 (GND), VR6.1 (ADJ/GND), VR8.3 (GND); also elsewhere on the board
unnamed: R12.2, VR2.2 (RON)
unnamed: R13.2, R14.2, VR2.3 (EN)
unnamed: C33.2, VR2.5 (SS)
unnamed: C32.1, R11.1, R15.2, VR2.6 (FB)
unnamed: POE.7 (TRIM), R54.2 (S)
unnamed: POE.6 (-SENSE), R54.1 (A)
unnamed: POE.8 (+SENSE), R54.3 (E)
POE+: C129.1, C130.1, C133.1, POE.9 (+VOUT); also elsewhere on the board
POE-: C129.2, C130.2, C133.2, POE.5 (-VOUT); also elsewhere on the board
REF_MONITOR: C22.1, R10.2, R16.2; also elsewhere on the board

Notes on the sheet:
Logic Power Supply
Main Switching Power Supply
Analog Reference Voltage Regulator
Power Over Ethernet (PoE) Power Supply
Isolated 48V Supply
8V Power Supply
Ref Voltage Monitor Filter
Power Supplies Logic Power Supply (3.3V) Analog Power Supply (5.0V) Analog Voltage Regulator (5.000V) Analog Reference Voltage Regulator (8.0V) Main Switching Power Supply (12V) PoE Power Supply (48V)
Device TLE4476D TLE4476D ADR435RM-8 TL751M08QKVURQ1 LMZ14202HTZ CHB75W-24S48-C
Min 4.5 5.7 7.0 9.0 6.0 9.0
Typ - - - 12.0 - -
Max 42.0 42.0 18.0 26.0 42.0 36.0
Min 3.17 4.8 4.998 7.76 5.0
Typ 3.3 5.0 5.000 8.00 - 48.0
Max 3.43 5.2 5.002 8.24 30.0
Min 350.0 430.0 -20.0 5.0 2400.0 0.0
Typ - - - 60.0 3200.0 -
Max 900.0 900.0 30.0 75.0 3950.0 1560.0
Input Voltage (V) Output Voltage (V) Output Current (mA)
Analog Power Supply

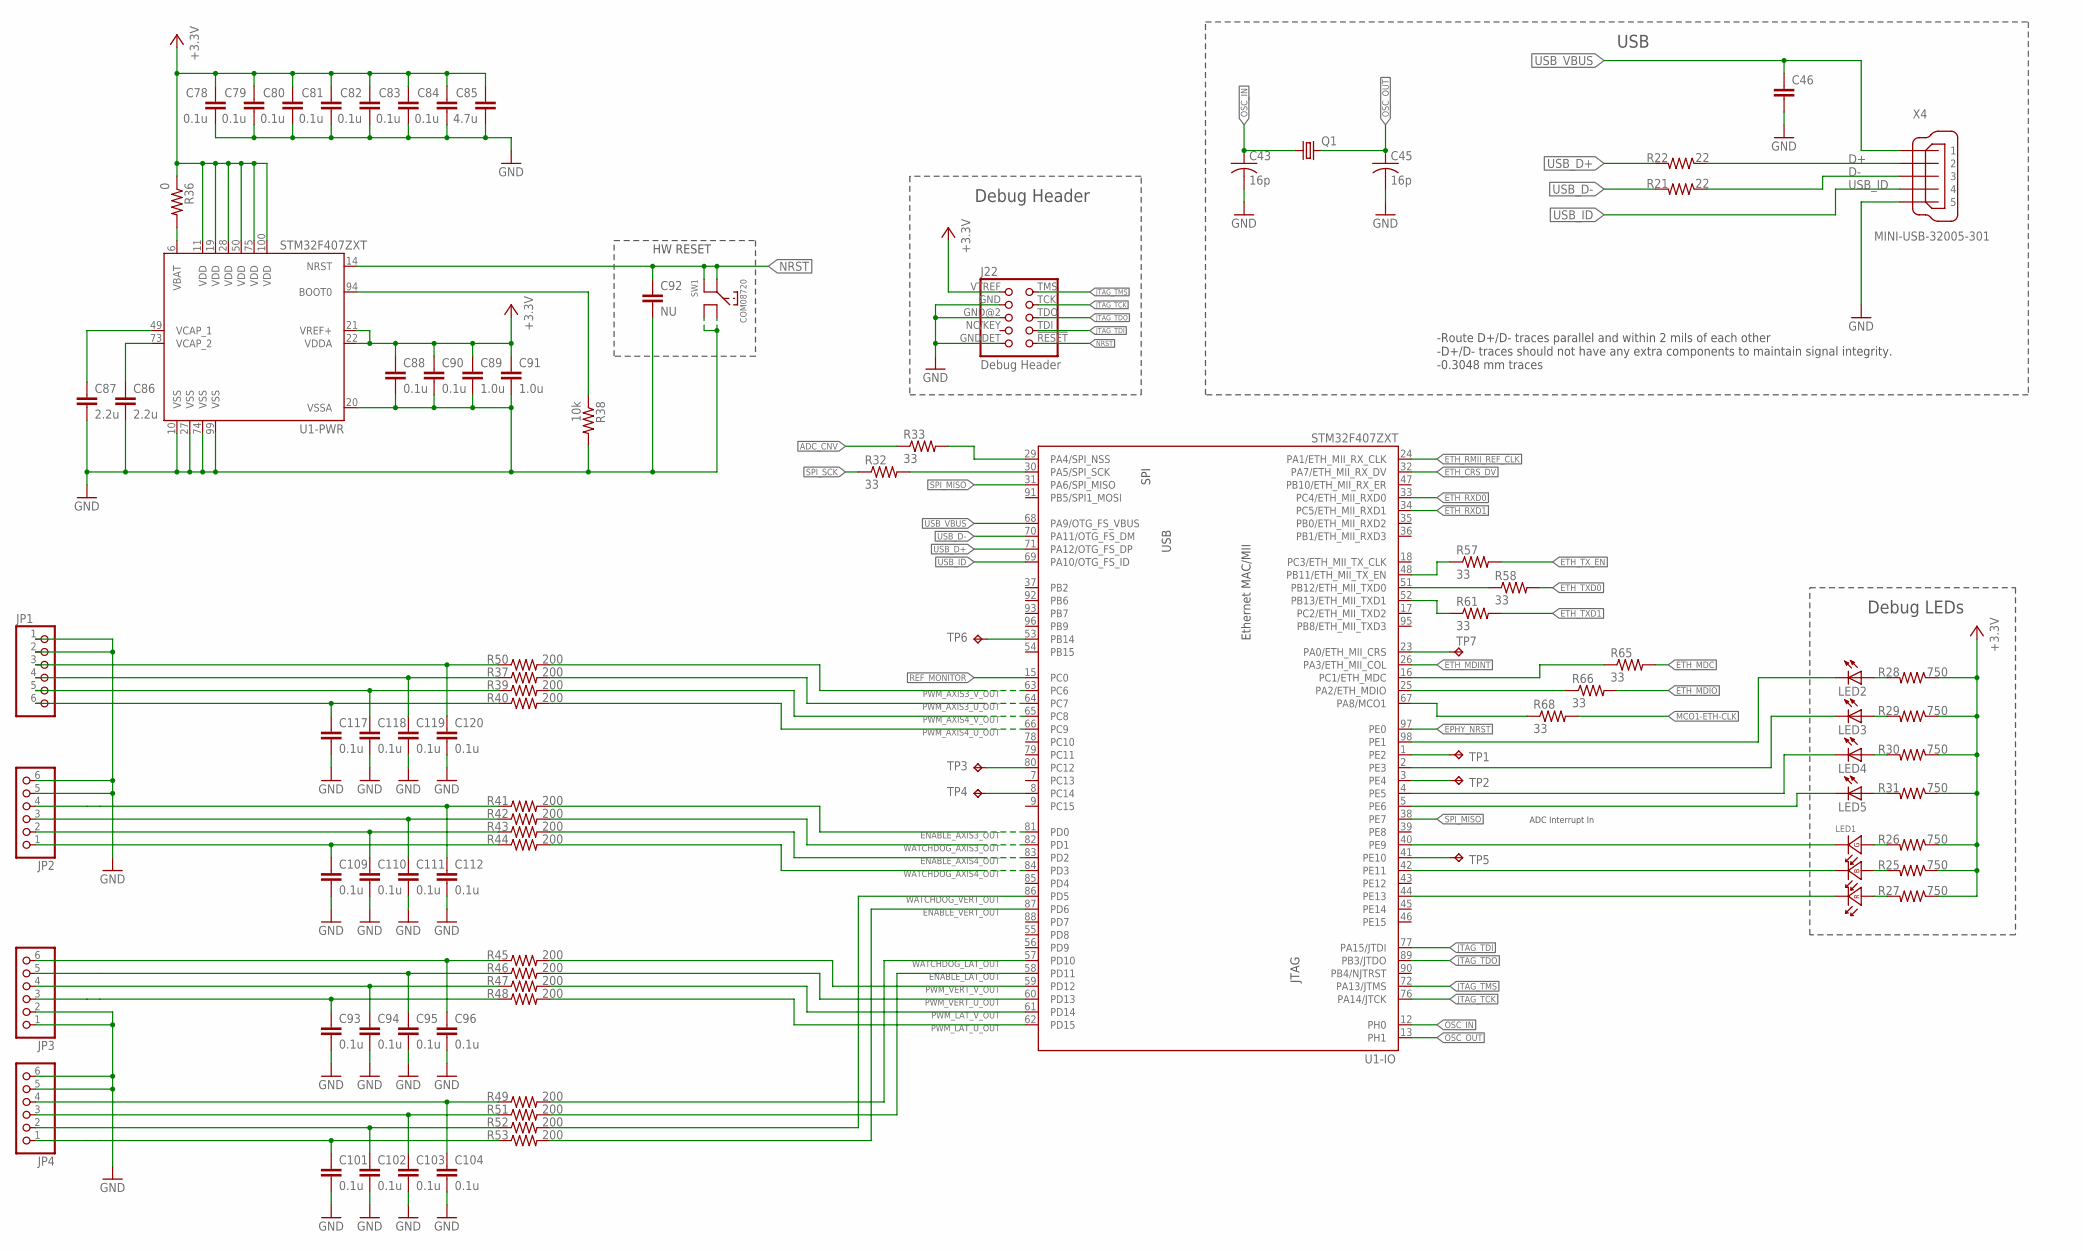
[picture p88: schematic RTxController.sch, sheet 3, MCU]

Parts:
C43, C45: 16p; C0402
C46: C-EUC0603; C0603
C78, C79, C80, C81, C82, C83, C84, C88, C90: 0.1u; C0402
C85: 4.7u; C0603
C86, C87: 2.2u; C0402
C89, C91: 1.0u; C0402
C92: NU; C0402
C93, C94, C95, C96, C101, C102, C103, C104, C109, C110, C111, C112, C117, C118, C119, C120: 0.1u; C0603
J22: Debug Header; 1.27MM_2X5
JP1, JP2, JP3, JP4: PINHD-1X6; 1X06
LED1: LED_RGB_PLCC-6; PLCC-6
LED2, LED3, LED4, LED5: LEDCHIP-LED0603; CHIP-LED0603
Q1: CRYSTALCTS406; CTS406
R21, R22: 22; R0402
R25, R26, R27, R28, R29, R30, R31: 750; R0402
R32, R33, R57, R58, R61, R65, R66, R68: 33; R0402
R36: 0; R0603
R37, R39, R40, R41, R42, R43, R44, R45, R46, R47, R48, R49, R50, R51, R52, R53: 200; R0603
R38: 10k; R0603
SW1: COM08720
TP1, TP2, TP3, TP4, TP5, TP6, TP7: TPTP06R; TP06R
U1: STM32F407ZXT; LQFP-100
X4: MINI-USB-32005-301; 32005-301

Connections:
+3.3V: C78.1, C79.1, C80.1, C81.1, C82.1, C83.1, C84.1, C85.1, C88.1, C89.1, C90.1, C91.1, J22.VTREF, R25.1, R26.1, R27.1, R28.1, R29.1, R30.1, R31.1, R36.1, U1.11 (VDD), U1.19 (VDD), U1.21 (VREF+), U1.22 (VDDA), U1.28 (VDD), U1.50 (VDD), U1.75 (VDD), U1.100 (VDD); also elsewhere on the board
ADC_CNV: R33.1; also elsewhere on the board
BOOT0: R38.1, U1.94 (BOOT0)
D+: R22.1, X4.2
D-: R21.1, X4.3
ENABLE_AXIS3_OUT: R41.2, U1.81 (PD0)
ENABLE_AXIS4_OUT: R43.2, U1.83 (PD2)
ENABLE_LAT_OUT: R51.2, U1.58 (PD11)
ENABLE_VERT_OUT: R53.2, U1.87 (PD6)
EPHY_NRST: U1.97 (PE0); also elsewhere on the board
ETH_CRS_DV: U1.32 (PA7/ETH_MII_RX_DV); also elsewhere on the board
ETH_MDC: R65.2; also elsewhere on the board
ETH_MDINT: U1.26 (PA3/ETH_MII_COL); also elsewhere on the board
ETH_MDIO: R66.2; also elsewhere on the board
ETH_RMII_REF_CLK: U1.24 (PA1/ETH_MII_RX_CLK); also elsewhere on the board
ETH_RXD0: U1.33 (PC4/ETH_MII_RXD0); also elsewhere on the board
ETH_RXD1: U1.34 (PC5/ETH_MII_RXD1); also elsewhere on the board
ETH_TXD0: R58.2; also elsewhere on the board
ETH_TXD1: R61.2; also elsewhere on the board
ETH_TX_EN: R57.2; also elsewhere on the board
GND: C43.2, C45.2, C46.2, C78.2, C79.2, C80.2, C81.2, C82.2, C83.2, C84.2, C85.2, C86.2, C87.2, C88.2, C89.2, C90.2, C91.2, C92.2, C93.2, C94.2, C95.2, C96.2, C101.2, C102.2, C103.2, C104.2, C109.2, C110.2, C111.2, C112.2, C117.2, C118.2, C119.2, C120.2, J22.GND, J22.GND@2 (GND), J22.GNDDET, JP1.1, JP1.2, JP2.5, JP2.6, JP3.1, JP3.2, JP4.5, JP4.6, R38.2, SW1.2, SW1.4, U1.10 (VSS), U1.20 (VSSA), U1.27 (VSS), U1.74 (VSS), U1.99 (VSS), X4.5; also elsewhere on the board
JTAG_TCK: J22.TCK, U1.76 (PA14/JTCK)
JTAG_TDI: J22.TDI, U1.77 (PA15/JTDI)
JTAG_TDO: J22.TDO, U1.89 (PB3/JTDO)
JTAG_TMS: J22.TMS, U1.72 (PA13/JTMS)
MCO1-ETH-CLK: R68.2; also elsewhere on the board
unnamed: LED2.A, R28.2
unnamed: LED3.A, R29.2
unnamed: LED1.3 (A), R26.2
unnamed: LED1.4 (A), R25.2
unnamed: LED1.1 (A), R27.2
unnamed: C96.1, JP3.6, R45.1
unnamed: R36.2, U1.6 (VBAT)
unnamed: C95.1, JP3.5, R46.1
unnamed: C94.1, JP3.4, R47.1
unnamed: C93.1, JP3.3, R48.1
unnamed: C104.1, JP4.4, R49.1
unnamed: C103.1, JP4.3, R51.1
unnamed: C102.1, JP4.2, R52.1
unnamed: C101.1, JP4.1, R53.1
unnamed: C112.1, JP2.4, R41.1
unnamed: C111.1, JP2.3, R42.1
unnamed: C110.1, JP2.2, R43.1
unnamed: C109.1, JP2.1, R44.1
unnamed: LED4.A, R30.2
unnamed: LED5.A, R31.2
unnamed: LED1.5 (K), U1.42 (PE11)
unnamed: LED1.2 (K), U1.40 (PE9)
unnamed: LED1.6 (K), U1.44 (PE13)
unnamed: C120.1, JP1.3, R50.1
unnamed: C119.1, JP1.4, R37.1
unnamed: C118.1, JP1.5, R39.1
unnamed: C117.1, JP1.6, R40.1
unnamed: LED5.C, U1.5 (PE6)
unnamed: LED4.C, U1.4 (PE5)
unnamed: LED3.C, U1.2 (PE3)
unnamed: LED2.C, U1.98 (PE1)
unnamed: R33.2, U1.29 (PA4/SPI_NSS)
unnamed: R57.1, U1.48 (PB11/ETH_MII_TX_EN)
unnamed: R61.1, U1.52 (PB13/ETH_MII_TXD1)
unnamed: R58.1, U1.51 (PB12/ETH_MII_TXD0)
unnamed: R65.1, U1.16 (PC1/ETH_MDC)
unnamed: R66.1, U1.25 (PA2/ETH_MDIO)
unnamed: R68.1, U1.67 (PA8/MCO1)
NRST: C92.1, J22.!RESET, SW1.1, SW1.3, U1.14 (NRST)
OSC_IN: C43.1, Q1.1, U1.12 (PH0)
OSC_OUT: C45.1, Q1.3 (2), U1.13 (PH1)
PWM_AXIS3_U_OUT: R37.2, U1.64 (PC7)
PWM_AXIS3_V_OUT: R50.2, U1.63 (PC6)
PWM_AXIS4_U_OUT: R40.2, U1.66 (PC9)
PWM_AXIS4_V_OUT: R39.2, U1.65 (PC8)
PWM_LAT_U_OUT: R48.2, U1.62 (PD15)
PWM_LAT_V_OUT: R47.2, U1.61 (PD14)
PWM_VERT_U_OUT: R46.2, U1.60 (PD13)
PWM_VERT_V_OUT: R45.2, U1.59 (PD12)
REF_MONITOR: U1.15 (PC0); also elsewhere on the board
SPI_MISO: U1.31 (PA6/SPI_MISO), U1.38 (PE7); also elsewhere on the board
SPI_SCK: R32.1; also elsewhere on the board
SPI_SCK_MCU: R32.2, U1.30 (PA5/SPI_SCK)
TP1: TP1.TP, U1.1 (PE2)
TP2: TP2.TP, U1.3 (PE4)
TP3: TP3.TP, U1.80 (PC12)
TP4: TP4.TP, U1.8 (PC14)
TP5: TP5.TP, U1.41 (PE10)
TP6: TP6.TP, U1.53 (PB14)
TP7: TP7.TP, U1.23 (PA0/ETH_MII_CRS)
USB_D+: R22.2, U1.71 (PA12/OTG_FS_DP)
USB_D-: R21.2, U1.70 (PA11/OTG_FS_DM)
USB_ID: U1.69 (PA10/OTG_FS_ID), X4.4
USB_VBUS: C46.1, U1.68 (PA9/OTG_FS_VBUS), X4.1
VCAP_1: C87.1, U1.49 (VCAP_1)
VCAP_2: C86.1, U1.73 (VCAP_2)
WATCHDOG_AXIS3_OUT: R42.2, U1.82 (PD1)
WATCHDOG_AXIS4_OUT: R44.2, U1.84 (PD3)
WATCHDOG_LAT_OUT: R49.2, U1.57 (PD10)
WATCHDOG_VERT_OUT: R52.2, U1.86 (PD5)

Notes on the sheet:
HW RESET
ADC Interrupt In
Debug Header
USB
Debug LEDs
-Route D+/D- traces parallel and within 2 mils of each other -D+/D- traces should not have any extra components to maintain signal integrity. -0.3048 mm traces

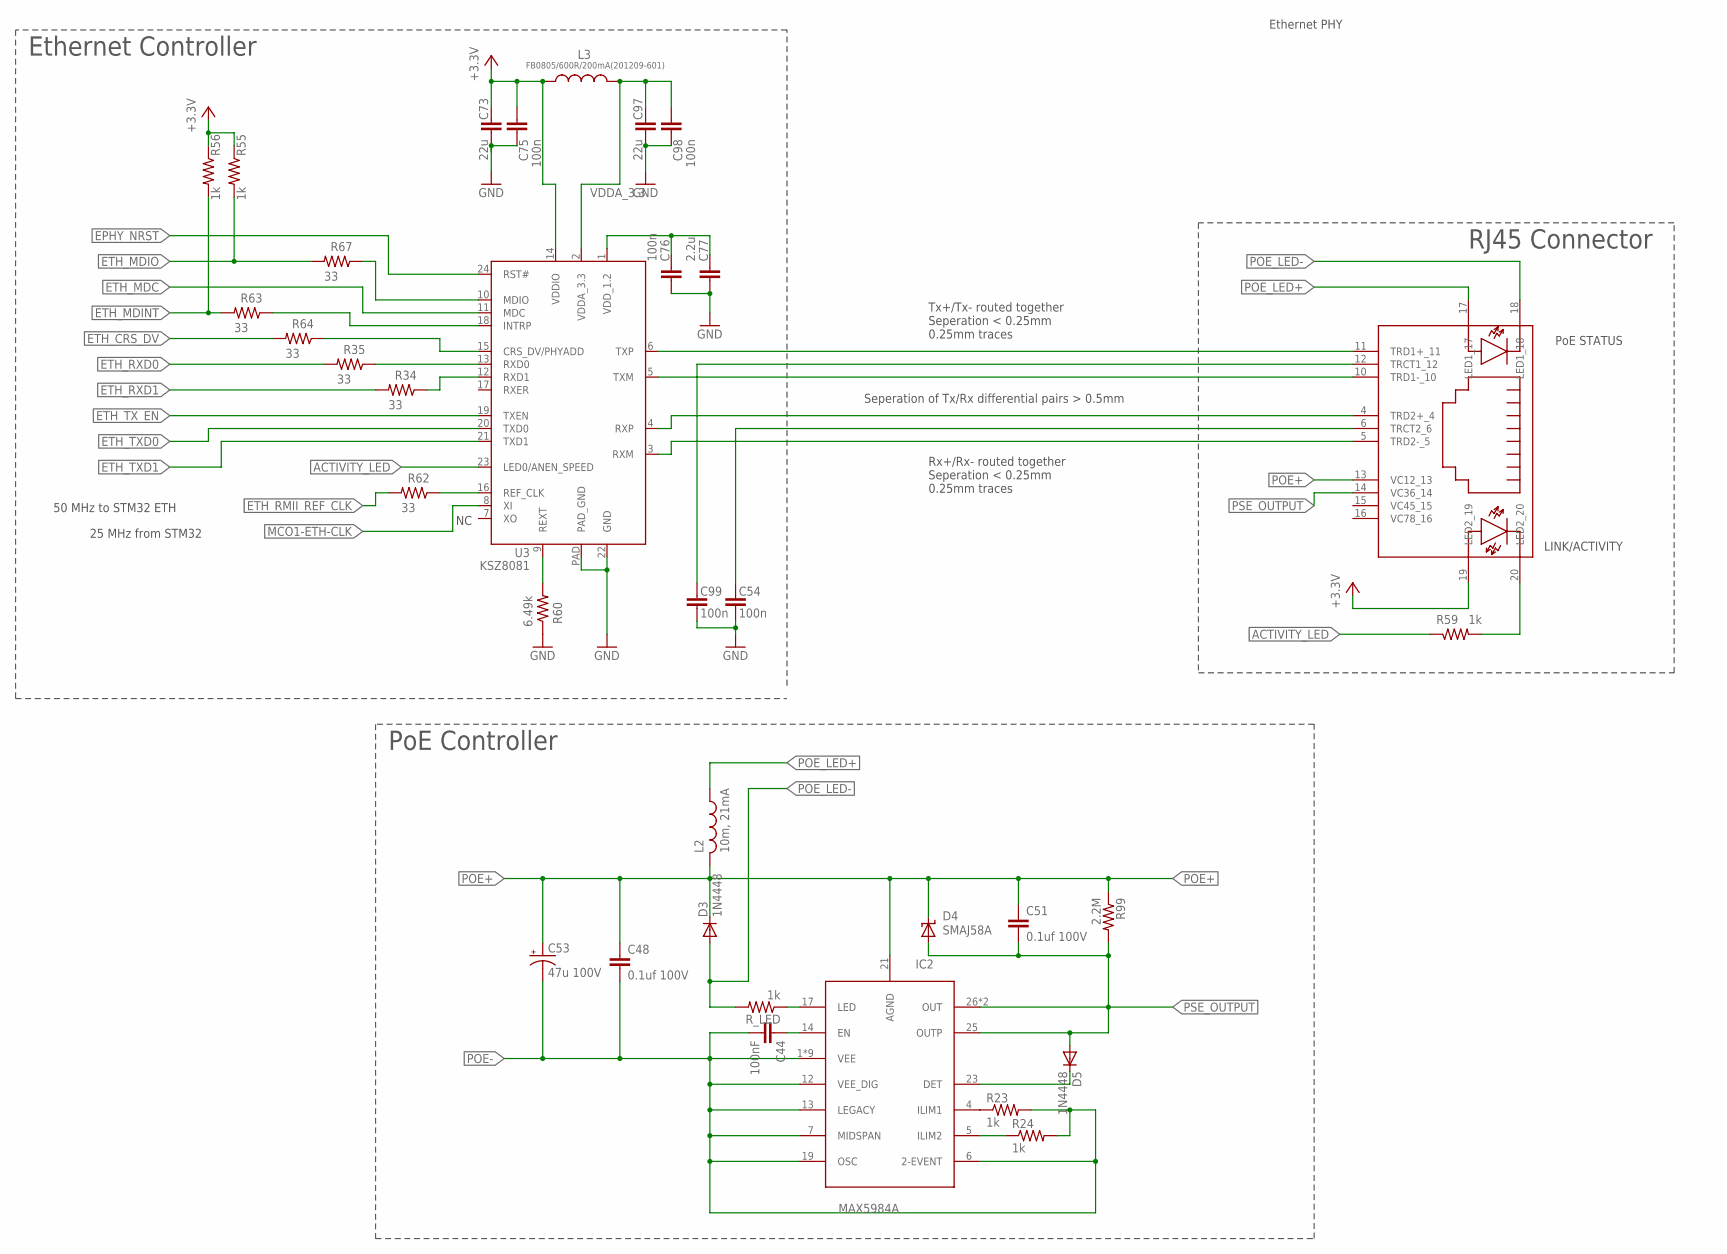
[picture p89: schematic RTxController.sch, sheet 4, ETH]

Parts:
C44: 100nF; C0805K
C48, C51: 0.1uf 100V; C0805K
C53: 47u 100V; PANASONIC_C
C54, C75, C76, C98, C99: 100n; 0402-C-NOSILK
C73, C97: 22u; 1206-C
C77: 2.2u; 0402-C-NOSILK
D3, D5: 1N4448; SOD-123
D4: SMAJ58A; SMBJ
IC2: MAX5984A; TQFN-28
L2: 10m, 21mA; 0204V
L3: FB0805/600R/200mA(201209-601); 0805-C-NOSILK
R23, R24: 1k; R0603
R34, R35, R62, R63, R64, R67: 33; 0402-C-NOSILK
R55, R56, R59: 1k; 0402-C-NOSILK
R60: 6.49k; 0402-C-NOSILK
R99: 2.2M; R0603
R_LED: 1k; R0603
U3: KSZ8081; QFN-24
X8: 0826-1X1T-GJ-F; MAGJACK-RJ45

Connections:
+3.3V: C73.2, C75.2, L3.2, R55.1, R56.1, U3.14 (VDDIO), X8.19 (LED2_19); also elsewhere on the board
ACTIVITY_LED: R59.1, U3.23 (LED0/ANEN_SPEED)
EPHY_NRST: U3.24 (RST#); also elsewhere on the board
ETH_CRS_DV: R64.2; also elsewhere on the board
ETH_MDC: U3.11 (MDC); also elsewhere on the board
ETH_MDINT: R56.2, R63.2; also elsewhere on the board
ETH_MDIO: R55.2, R67.2; also elsewhere on the board
ETH_RMII_REF_CLK: R62.2; also elsewhere on the board
ETH_RXD0: R35.2; also elsewhere on the board
ETH_RXD1: R34.2; also elsewhere on the board
ETH_TXD0: U3.20 (TXD0); also elsewhere on the board
ETH_TXD1: U3.21 (TXD1); also elsewhere on the board
ETH_TX_EN: U3.19 (TXEN); also elsewhere on the board
GND: C54.1, C73.1, C75.1, C76.2, C77.2, C97.1, C98.1, C99.1, R60.1, U3.22 (GND), U3.PAD (PAD_GND); also elsewhere on the board
MCO1-ETH-CLK: U3.8 (XI); also elsewhere on the board
unnamed: R59.2, X8.20 (LED2_20)
unnamed: U3.6 (TXP), X8.11 (TRD1+_11)
unnamed: U3.5 (TXM), X8.10 (TRD1-_10)
unnamed: U3.4 (RXP), X8.4 (TRD2+_4)
unnamed: U3.3 (RXM), X8.5 (TRD2-_5)
unnamed: IC2.17 (LED), R_LED.1
unnamed: C44.1, IC2.14 (EN)
unnamed: D5.P$2 (C), IC2.23 (DET)
unnamed: IC2.4 (ILIM1), R23.1
unnamed: IC2.5 (ILIM2), R24.1
unnamed: R35.1, U3.13 (RXD0)
unnamed: R34.1, U3.12 (RXD1)
unnamed: R62.1, U3.16 (REF_CLK)
unnamed: R60.2, U3.9 (REXT)
unnamed: C76.1, C77.1, U3.1 (VDD_1.2)
unnamed: C99.2, X8.12 (TRCT1_12)
unnamed: R63.1, U3.18 (INTRP)
unnamed: R64.1, U3.15 (CRS_DV/PHYADD)
unnamed: R67.1, U3.10 (MDIO)
POE+: C48.1, C51.1, C53.+, D3.P$2 (C), D4.C, IC2.21 (AGND), L2.2, R99.1, X8.13 (VC12_13); also elsewhere on the board
POE-: C44.2, C48.2, C53.-, IC2.1 (VEE), IC2.2 (VEE), IC2.3 (VEE), IC2.6 (2-EVENT), IC2.7 (MIDSPAN), IC2.8 (VEE), IC2.9 (VEE), IC2.10 (VEE), IC2.11 (VEE), IC2.12 (VEE_DIG), IC2.13 (LEGACY), IC2.15 (VEE), IC2.19 (OSC), IC2.PAD (VEE), R23.2, R24.2; also elsewhere on the board
POE_LED+: L2.1, X8.17 (LED1_17)
POE_LED-: D3.P$1 (A), R_LED.2, X8.18 (LED1_18)
PSE_OUTPUT: C51.2, D4.A, D5.P$1 (A), IC2.25 (OUTP), IC2.26 (OUT), IC2.27 (OUT), R99.2, X8.14 (VC36_14)
VDDA: C54.2, X8.6 (TRCT2_6)
VDDA_3.3: C97.2, C98.2, L3.1, U3.2 (VDDA_3.3)

Notes on the sheet:
Ethernet PHY
LINK/ACTIVITY
25 MHz from STM32
50 MHz to STM32 ETH
PoE STATUS
PoE Controller
Ethernet Controller
RJ45 Connector
Tx+/Tx- routed together Seperation < 0.25mm 0.25mm traces
Rx+/Rx- routed together Seperation < 0.25mm 0.25mm traces
Seperation of Tx/Rx differential pairs > 0.5mm

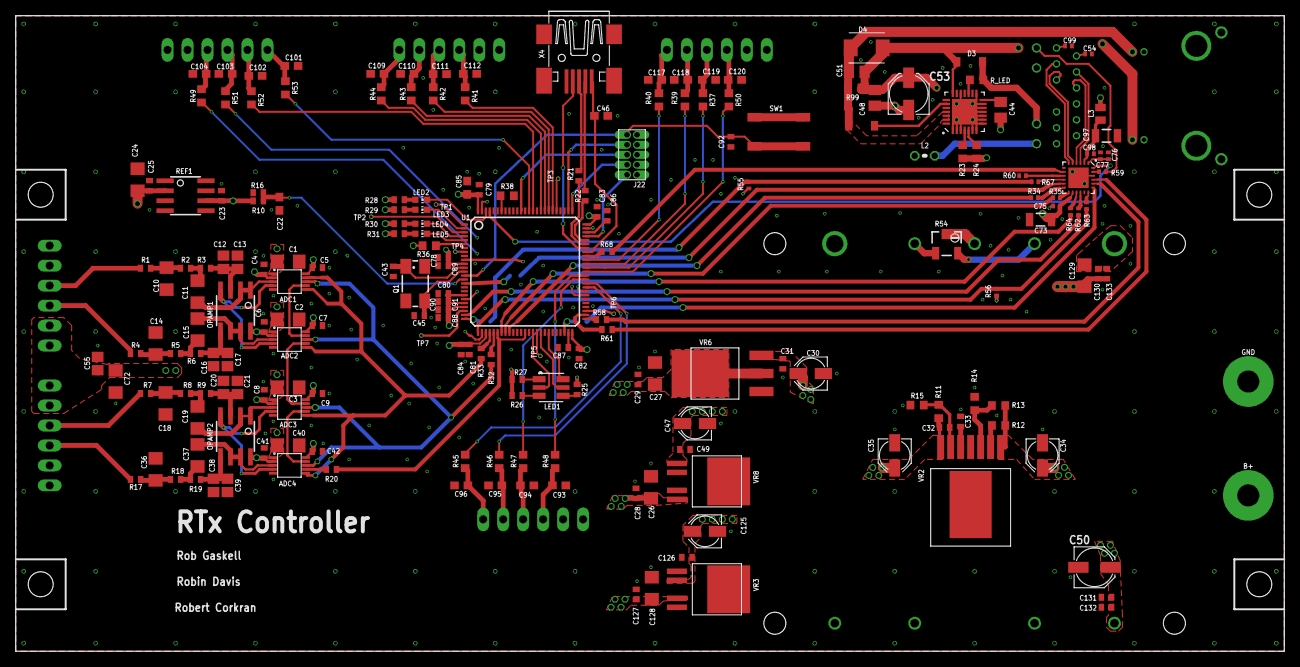
[picture p90: board RTxController.brd from above]

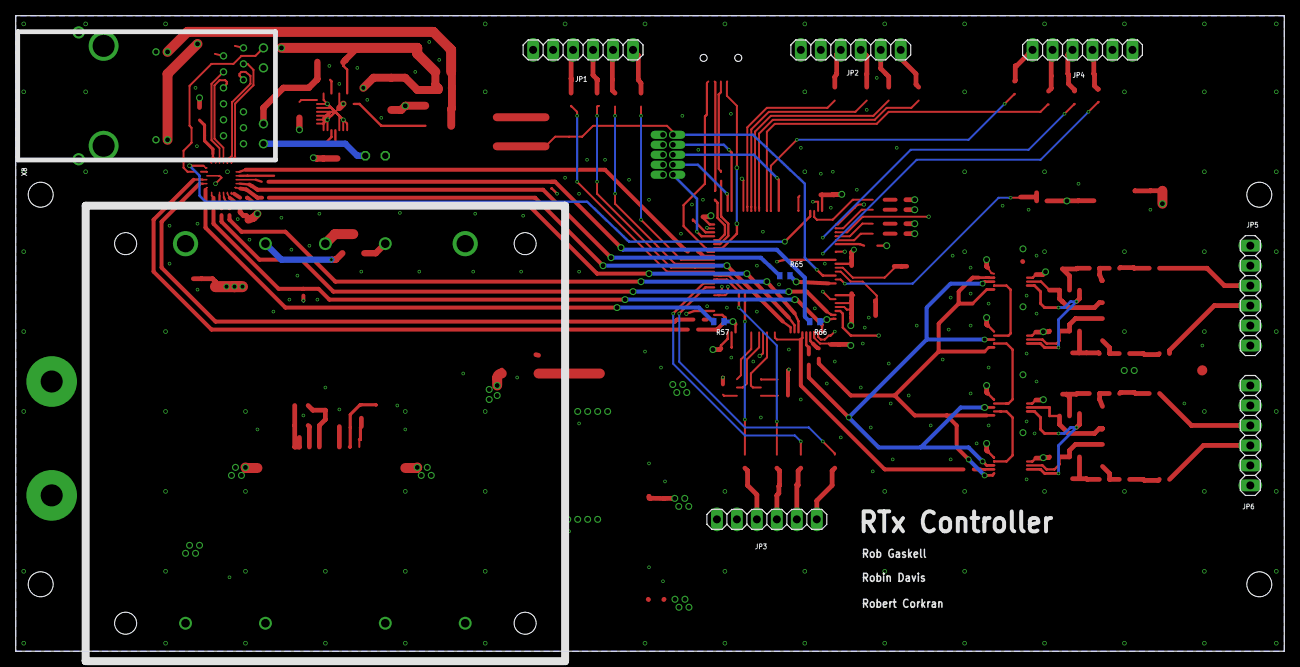
[picture p91: board RTxController.brd from below]

Board: 4 copper layers, 161.3 x 80.8 mm, 217 parts (11 on the bottom side), 159 nets.
