psas/rocket-tracks/RTx_Main_Power/RTx_Charger.brd

## EAGLE design RTx_Main_Power/RTx_Charger.brd (2014-04-26)

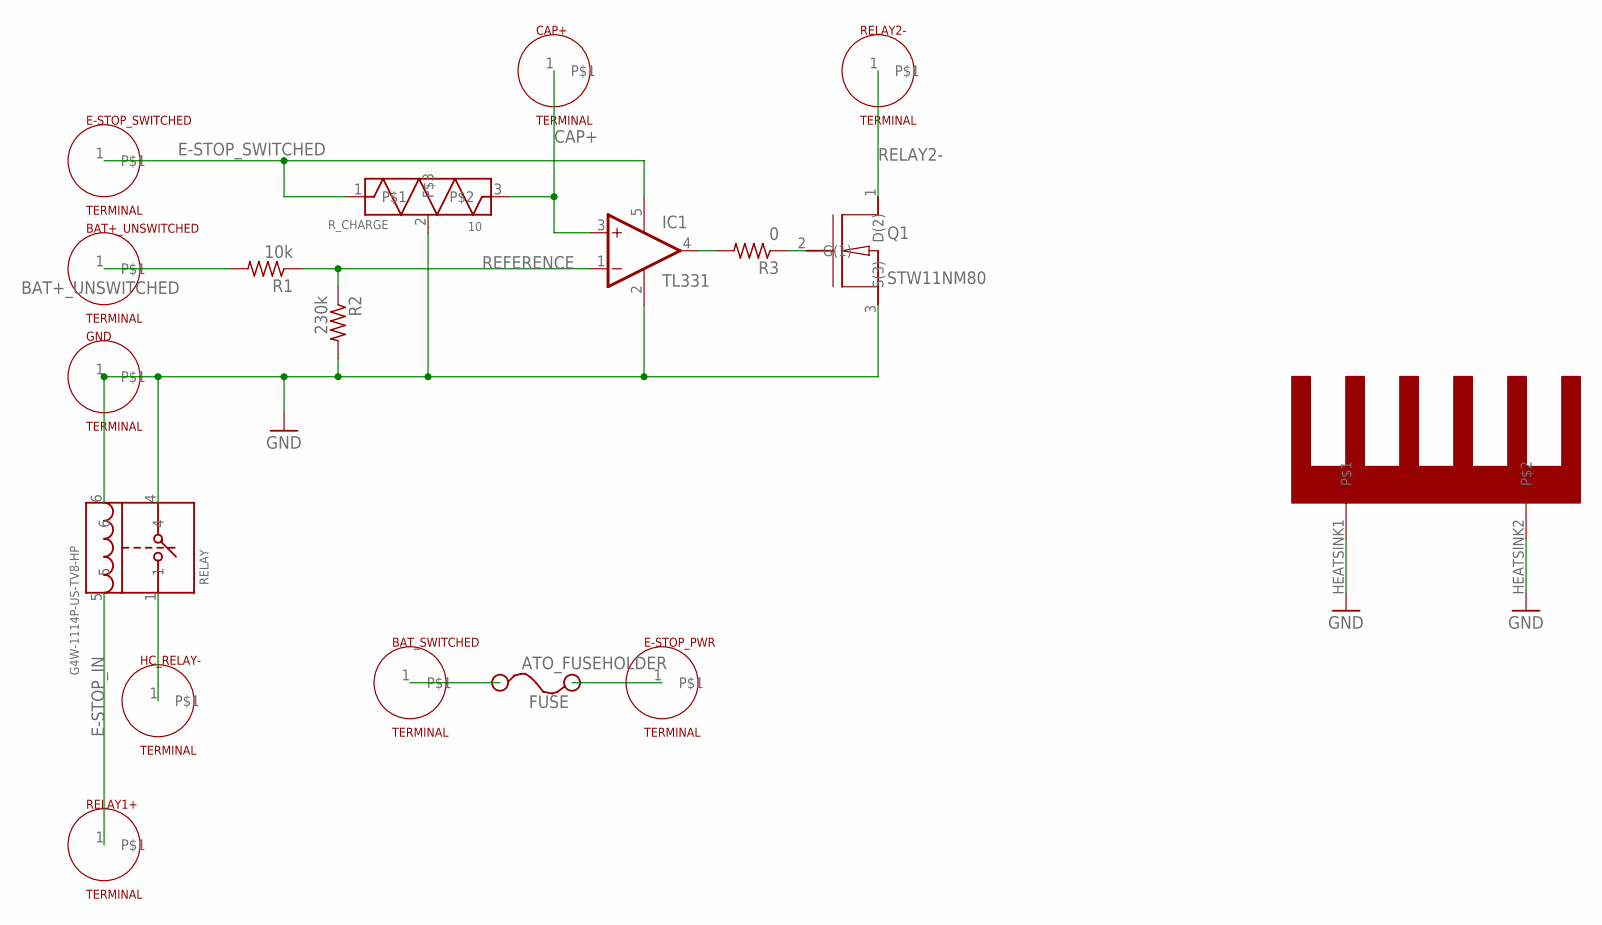
[picture p92: schematic RTx_Charger.sch]

Parts:
BAT+_UNSWITCHED: TERMINAL; TERMINAL_STUD
BAT_SWITCHED: TERMINAL; TERMINAL_NO-STUD
CAP+: TERMINAL; TERMINAL_STUD
E-STOP_PWR: TERMINAL; TERMINAL_STUD
E-STOP_SWITCHED: TERMINAL; TERMINAL_NO-STUD
FUSE: ATO_FUSEHOLDER; ATO_BLADE_FUSE
GND: TERMINAL; TERMINAL_STUD
HC_RELAY-: TERMINAL; TERMINAL_NO-STUD
HEATSINK: WA-T247-101E
IC1: TL331; DBV-R-PDSO-G5
Q1: STW11NM80; TO-247
R1: 10k; R1206
R2: 230k; R1206
R3: 0; R1206
RELAY: G4W-1114P-US-TV8-HP
RELAY1+, RELAY2-: TERMINAL; TERMINAL_NO-STUD
R_CHARGE: 10; TEH70

Connections:
BAT+_UNSWITCHED: BAT+_UNSWITCHED.1, R1.2
BAT_SWITCHED: BAT_SWITCHED.1, FUSE.2.1 (C), FUSE.2.2 (C), FUSE.2.3 (C), FUSE.2.4 (C)
CAP+: CAP+.1, IC1.3 (+IN), R_CHARGE.3
E-STOP_IN: RELAY.5, RELAY1+.1
E-STOP_PWR: E-STOP_PWR.1, FUSE.1.1 (A), FUSE.1.2 (A), FUSE.1.3 (A), FUSE.1.4 (A)
E-STOP_SWITCHED: E-STOP_SWITCHED.1, IC1.5 (V+), R_CHARGE.1
GND: GND.1, HEATSINK.HEATSINK1, HEATSINK.HEATSINK2, IC1.2 (GND), Q1.3 (S(3)), R2.2, RELAY.4, RELAY.6, R_CHARGE.2
HC_RELAY-: HC_RELAY-.1, RELAY.1
unnamed: IC1.4 (OUT), R3.2
unnamed: Q1.2 (G(1)), R3.1
REFERENCE: IC1.1 (-IN), R1.1, R2.1
RELAY2-: Q1.1 (D(2)), RELAY2-.1

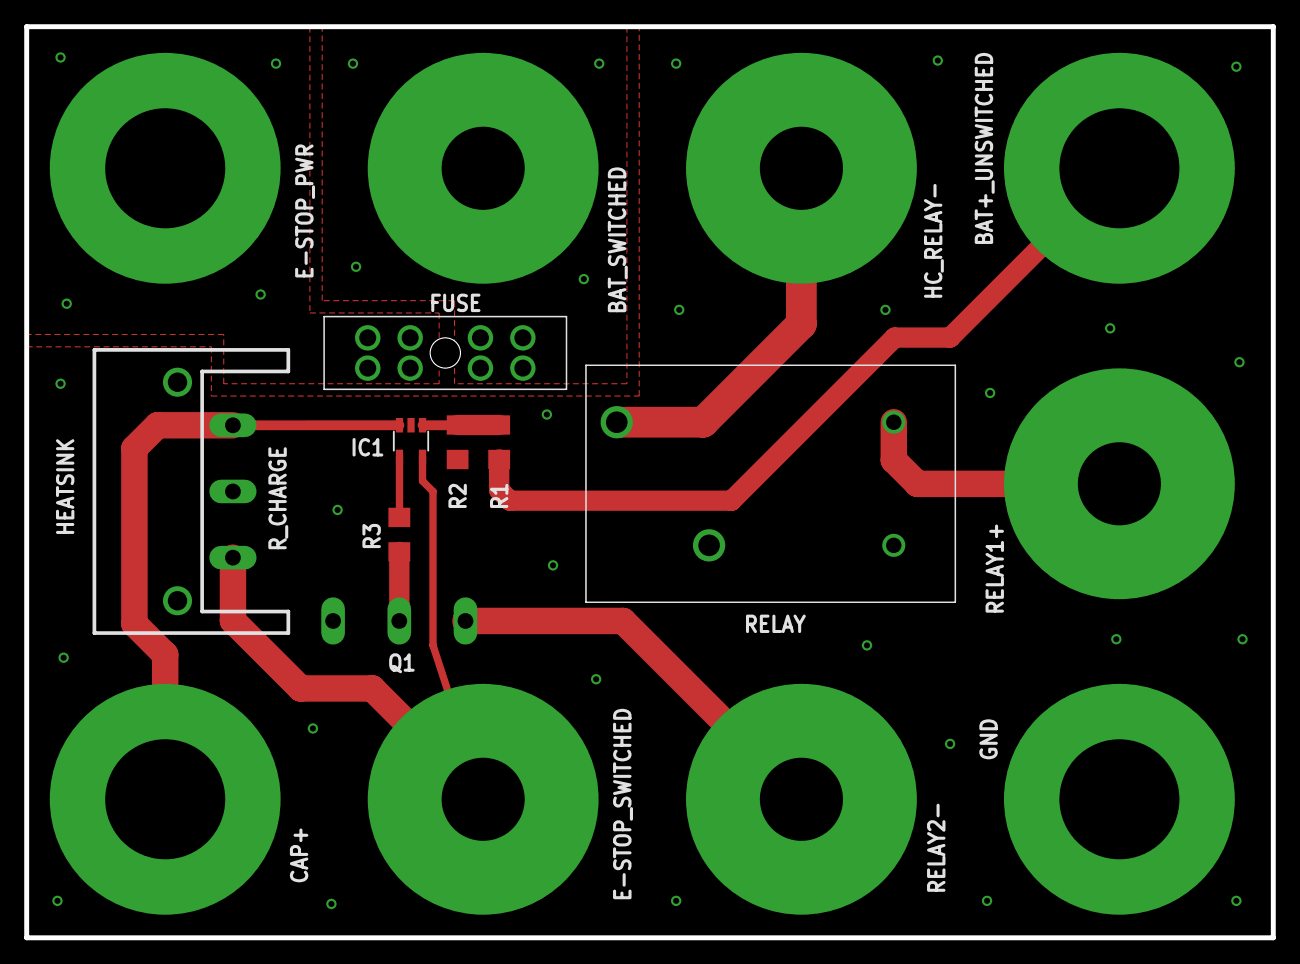
[picture p93: board RTx_Charger.brd from above]

Board: 2 copper layers, 102.9 x 75.2 mm, 18 parts (0 on the bottom side), 12 nets.
