psas/rocket-tracks/RTx_Manual_Control/RTxManualControl.brd

## EAGLE design RTx_Manual_Control/RTxManualControl.brd (2014-02-26)

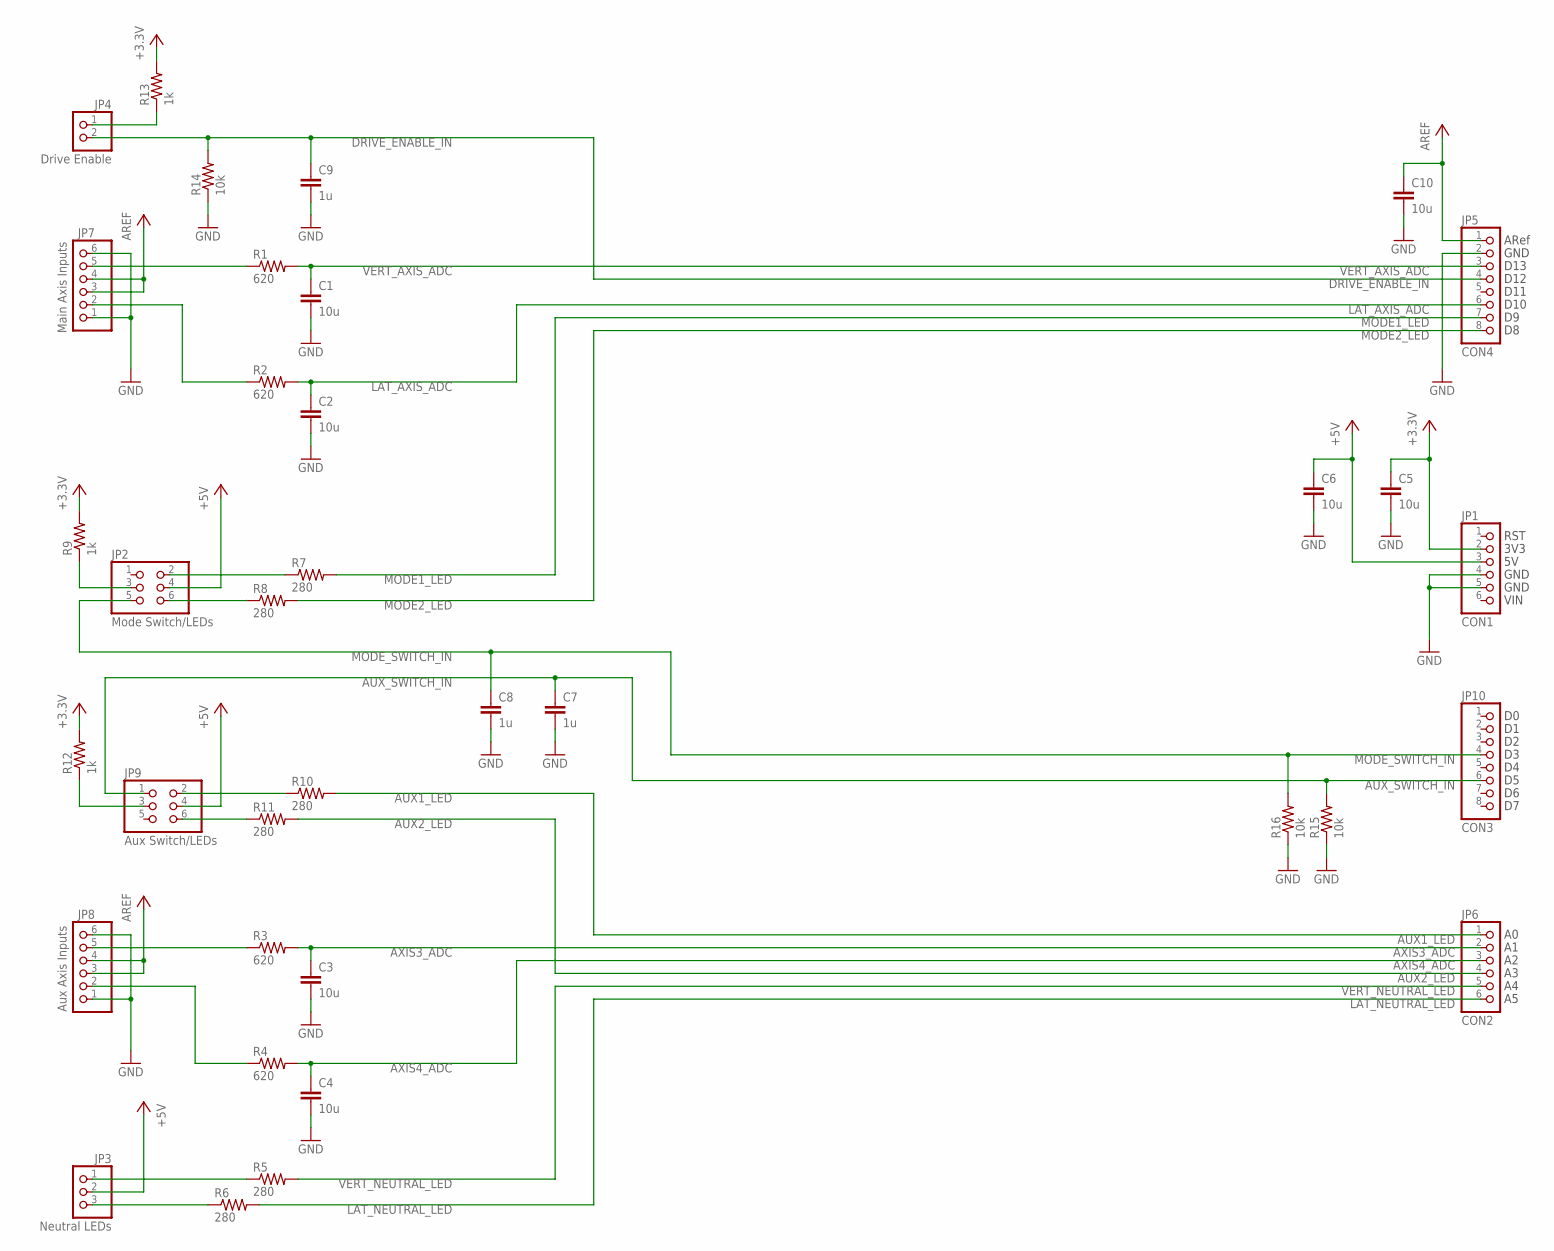
[picture p94: schematic RTxManualControl.sch]

Parts:
C1, C2, C3, C4, C5, C6, C10: 10u; C1206
C7, C8, C9: 1u; C1206
JP1: CON1; 1X06
JP2: Mode Switch/LEDs; 2X03
JP3: Neutral LEDs; 1X03
JP4: Drive Enable; 1X02
JP5: CON4; 1X08
JP6: CON2; 1X06
JP7: Main Axis Inputs; 1X06
JP8: Aux Axis Inputs; 1X06
JP9: Aux Switch/LEDs; 2X03
JP10: CON3; 1X08
R1, R2, R3, R4: 620; R1206
R5, R6, R7, R8, R10, R11: 280; R1206
R9, R12, R13: 1k; R1206
R14, R15, R16: 10k; R1206

Connections:
+3.3V: C5.1, JP1.2, R9.2, R12.2, R13.2
+5V: C6.1, JP1.3, JP2.4, JP3.2, JP9.4
AREF: C10.1, JP5.1, JP7.3, JP7.4, JP8.3, JP8.4
AUX1_LED: JP6.1, R10.2
AUX1_LED_CONN: JP9.2, R10.1
AUX2_LED: JP6.4, R11.2
AUX2_LED_CONN: JP9.6, R11.1
AUX_SWITCH_IN: C7.1, JP9.1, JP10.6, R15.2
AUX_SWITCH_PULLUP: JP9.3, R12.1
AXIS3_ADC: C3.1, JP6.2, R3.2
AXIS3_CONN: JP8.5, R3.1
AXIS4_ADC: C4.1, JP6.3, R4.2
AXIS4_CONN: JP8.2, R4.1
DRIVE_ENABLE_IN: C9.1, JP4.2, JP5.4, R14.2
DRIVE_ENABLE_PULLUP: JP4.1, R13.1
GND: C1.2, C2.2, C3.2, C4.2, C5.2, C6.2, C7.2, C8.2, C9.2, C10.2, JP1.4, JP1.5, JP5.2, JP7.1, JP7.6, JP8.1, JP8.6, R14.1, R15.1, R16.1
LAT_AXIS_ADC: C2.1, JP5.6, R2.2
LAT_AXIS_CONN: JP7.2, R2.1
LAT_NEAUTRAL_LED_CONN: JP3.3, R6.1
LAT_NEUTRAL_LED: JP6.6, R6.2
MODE1_LED: JP5.7, R7.2
MODE1_LED_CONN: JP2.2, R7.1
MODE2_LED: JP5.8, R8.2
MODE2_LED_CONN: JP2.6, R8.1
MODE_SWITCH_IN: C8.1, JP2.5, JP10.4, R16.2
MODE_SWITCH_PULLUP: JP2.3, R9.1
VERT_AXIS_ADC: C1.1, JP5.3, R1.2
VERT_AXIS_CONN: JP7.5, R1.1
VERT_NEUTRAL_LED: JP6.5, R5.2
VERT_NEUTRAL_LED_CONN: JP3.1, R5.1

Notes on the sheet:
ARef
GND
D13
D12
D11
D10
RST
3V3
VIN

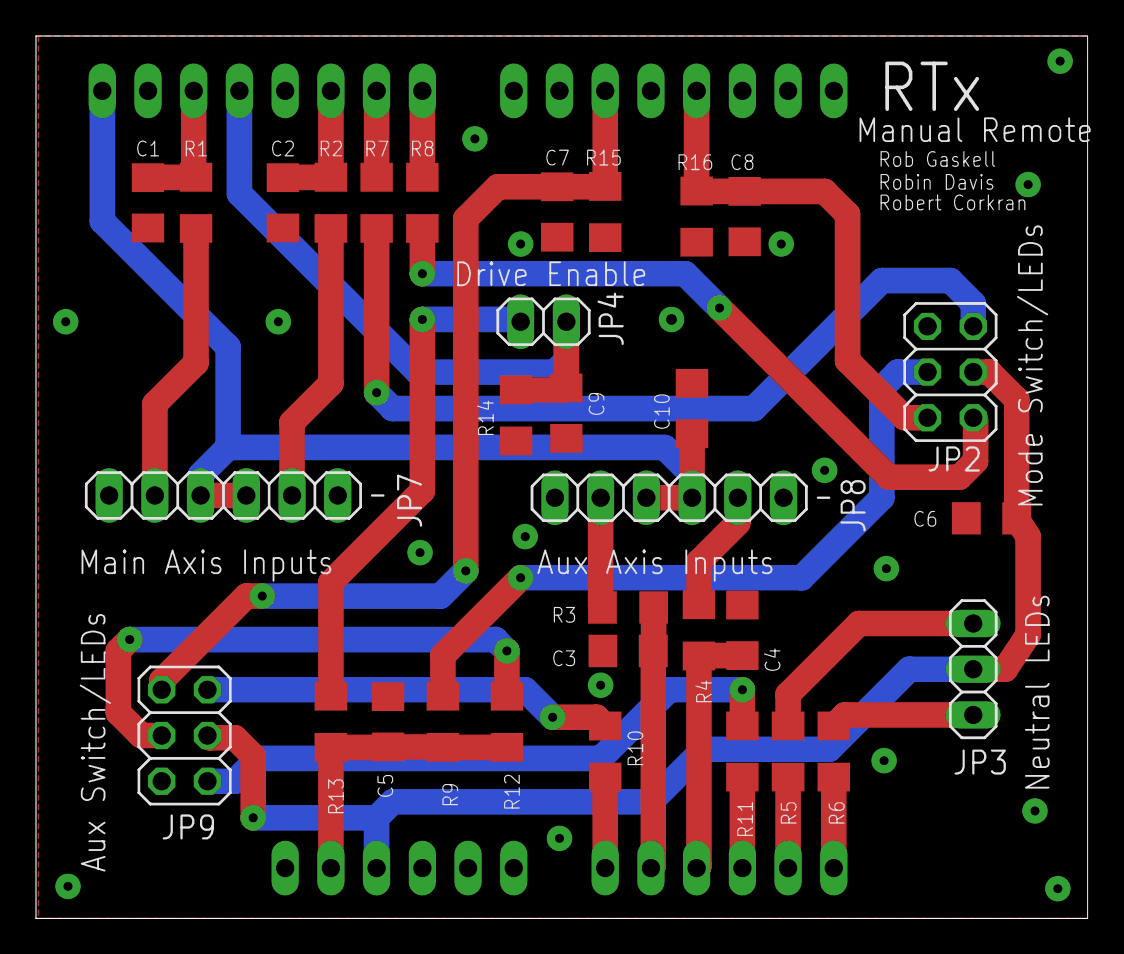
[picture p95: board RTxManualControl.brd from above]

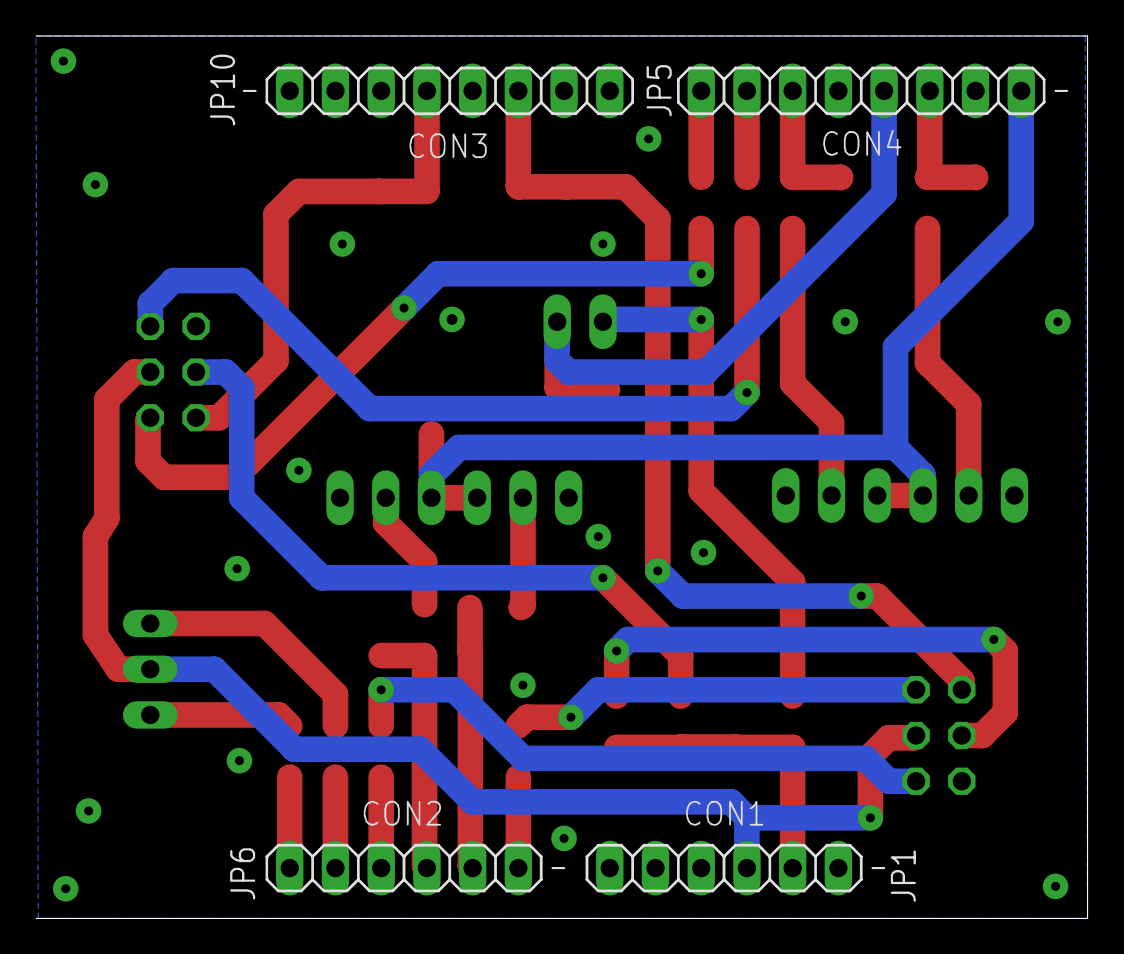
[picture p96: board RTxManualControl.brd from below]

Board: 2 copper layers, 58.4 x 49.0 mm, 36 parts (4 on the bottom side), 30 nets.
