psas/rocket-tracks/Rtx_Power_Filter/Rtx_Power_Filter.brd

## EAGLE design Rtx_Power_Filter/Rtx_Power_Filter.brd (2014-02-26)

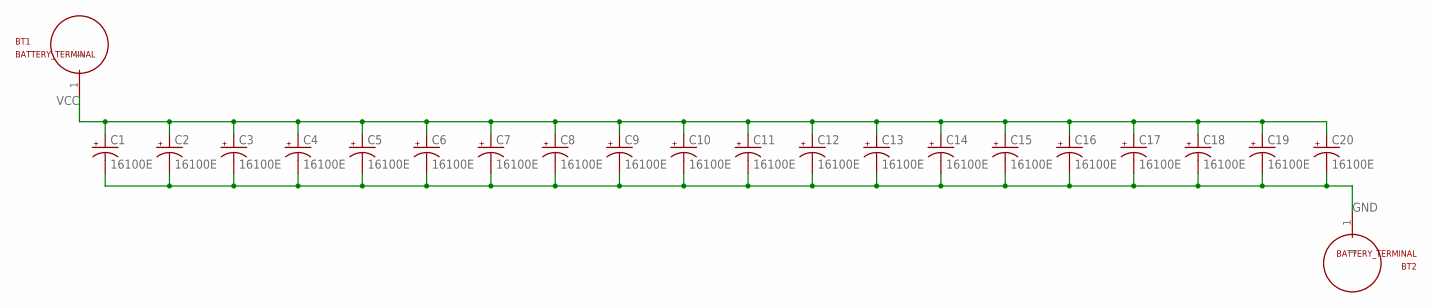
[picture p97: schematic Rtx_Power_Filter.sch]

Parts:
BT1, BT2: BATTERY_TERMINAL
C1, C2, C3, C4, C5, C6, C7, C8, C9, C10, C11, C12, C13, C14, C15, C16, C17, C18, C19, C20: 16100E; 16100

Connections:
GND: BT2.1, C1.-, C2.-, C3.-, C4.-, C5.-, C6.-, C7.-, C8.-, C9.-, C10.-, C11.-, C12.-, C13.-, C14.-, C15.-, C16.-, C17.-, C18.-, C19.-, C20.-
VCC: BT1.1, C1.+, C2.+, C3.+, C4.+, C5.+, C6.+, C7.+, C8.+, C9.+, C10.+, C11.+, C12.+, C13.+, C14.+, C15.+, C16.+, C17.+, C18.+, C19.+, C20.+

Board: 2 copper layers, 22 parts (0 on the bottom side), 2 nets, no tracks yet.
