psas/rocket-tracks/RTx_LPC_Firmware/src/include/target.h

/******************************************************************************
 * File name:		target.h
 *
 * Description: Header file for target.c
 *
 * Author:		Dan Kirkpatrick
 * Date:		2/28/2012
 *****************************************************************************/

#ifndef _TARGET_H
#define _TARGET_H

void targetGPIOResetPins(void);
void targetSetPinsForApplication(void);

#endif // End _TARGET_H
