psas/rocket-tracks/RTx_LPC_Firmware/PWM_TEST.elf.asm

PWM_TEST.elf:     file format elf32-littlearm

Disassembly of section startup:

00000000 <startup>:
   0:	ea00000f 	b	44 <start>
   4:	e59ff014 	ldr	pc, [pc, #20]	; 20 <_undf>
   8:	e59ff014 	ldr	pc, [pc, #20]	; 24 <_swi>
   c:	e59ff014 	ldr	pc, [pc, #20]	; 28 <_pabt>
  10:	e59ff014 	ldr	pc, [pc, #20]	; 2c <_dabt>
  14:	e1a00000 	nop			(mov r0,r0)
  18:	e51ff120 	ldr	pc, [pc, #-288]	; ffffff00 <__ethram_beg__+0x801fff00>
  1c:	e59ff00c 	ldr	pc, [pc, #12]	; 30 <_fiq>
  20:	00000034 	andeq	r0, r0, r4, lsr r0
  24:	00000dfc 	streqd	r0, [r0], -ip
  28:	00000038 	andeq	r0, r0, r8, lsr r0
  2c:	0000003c 	andeq	r0, r0, ip, lsr r0
  30:	00000040 	andeq	r0, r0, r0, asr #32
  34:	eafffffe 	b	34 <__undf>
  38:	eafffffe 	b	38 <__pabt>
  3c:	eafffffe 	b	3c <__dabt>
  40:	eafffffe 	b	40 <F_BIT>
Disassembly of section prog:

00000044 <start>:
      44:	e59f00b8 	ldr	r0, [pc, #184]	; 104 <IRQ_STACK_SIZE+0x4>
      48:	e321f0db 	msr	CPSR_c, #219	; 0xdb
      4c:	e1a0d000 	mov	sp, r0
      50:	e2400004 	sub	r0, r0, #4	; 0x4
      54:	e321f0d7 	msr	CPSR_c, #215	; 0xd7
      58:	e1a0d000 	mov	sp, r0
      5c:	e2400004 	sub	r0, r0, #4	; 0x4
      60:	e321f0d1 	msr	CPSR_c, #209	; 0xd1
      64:	e1a0d000 	mov	sp, r0
      68:	e2400004 	sub	r0, r0, #4	; 0x4
      6c:	e321f0d2 	msr	CPSR_c, #210	; 0xd2
      70:	e1a0d000 	mov	sp, r0
      74:	e2400c01 	sub	r0, r0, #256	; 0x100
      78:	e321f0d3 	msr	CPSR_c, #211	; 0xd3
      7c:	e1a0d000 	mov	sp, r0
      80:	e2400c01 	sub	r0, r0, #256	; 0x100
      84:	e321f0df 	msr	CPSR_c, #223	; 0xdf
      88:	e1a0d000 	mov	sp, r0
      8c:	e321f0d3 	msr	CPSR_c, #211	; 0xd3
      90:	e3a01000 	mov	r1, #0	; 0x0
      94:	e1a0b001 	mov	fp, r1
      98:	e1a07001 	mov	r7, r1
      9c:	e59f104c 	ldr	r1, [pc, #76]	; f0 <prog+0xac>
      a0:	e59f304c 	ldr	r3, [pc, #76]	; f4 <prog+0xb0>
      a4:	e0533001 	subs	r3, r3, r1
      a8:	0a000003 	beq	bc <.end_clear_loop>
      ac:	e3a02000 	mov	r2, #0	; 0x0

000000b0 <.clear_loop>:
      b0:	e4c12001 	strb	r2, [r1], #1
      b4:	e2533001 	subs	r3, r3, #1	; 0x1
      b8:	cafffffc 	bgt	b0 <.clear_loop>

000000bc <.end_clear_loop>:
      bc:	e59f1034 	ldr	r1, [pc, #52]	; f8 <prog+0xb4>
      c0:	e59f2034 	ldr	r2, [pc, #52]	; fc <prog+0xb8>
      c4:	e59f3034 	ldr	r3, [pc, #52]	; 100 <IRQ_STACK_SIZE>
      c8:	e0533001 	subs	r3, r3, r1
      cc:	0a000003 	beq	e0 <.end_set_loop>

000000d0 <.set_loop>:
      d0:	e4d24001 	ldrb	r4, [r2], #1
      d4:	e4c14001 	strb	r4, [r1], #1
      d8:	e2533001 	subs	r3, r3, #1	; 0x1
      dc:	cafffffb 	bgt	d0 <.set_loop>

000000e0 <.end_set_loop>:
      e0:	e3a00000 	mov	r0, #0	; 0x0
      e4:	e3a01000 	mov	r1, #0	; 0x0
      e8:	eb000006 	bl	108 <main>

000000ec <endless_loop>:
      ec:	eafffffe 	b	ec <endless_loop>
      f0:	40000004 	andmi	r0, r0, r4
      f4:	400000c8 	andmi	r0, r0, r8, asr #1
      f8:	40000000 	andmi	r0, r0, r0
      fc:	00002c58 	andeq	r2, r0, r8, asr ip
     100:	40000002 	andmi	r0, r0, r2
     104:	40007ffc 	strmid	r7, [r0], -ip

00000108 <main>:
     108:	e1a0c00d 	mov	ip, sp
     10c:	e92dd800 	stmdb	sp!, {fp, ip, lr, pc}
     110:	e24cb004 	sub	fp, ip, #4	; 0x4
     114:	e24dd00c 	sub	sp, sp, #12	; 0xc
     118:	e3a03000 	mov	r3, #0	; 0x0
     11c:	e54b3012 	strb	r3, [fp, #-18]
     120:	e3a03000 	mov	r3, #0	; 0x0
     124:	e54b3011 	strb	r3, [fp, #-17]
     128:	e3a03000 	mov	r3, #0	; 0x0
     12c:	e50b3010 	str	r3, [fp, #-16]
     130:	e3a03000 	mov	r3, #0	; 0x0
     134:	e50b3018 	str	r3, [fp, #-24]
     138:	eb000264 	bl	ad0 <targetInit>
     13c:	eb000a20 	bl	29c4 <pllstart_seventytwomhz>
     140:	e3a00002 	mov	r0, #2	; 0x2
     144:	e3a01000 	mov	r1, #0	; 0x0
     148:	e3a02efa 	mov	r2, #4000	; 0xfa0
     14c:	eb00040f 	bl	1190 <pwmInitSingleEdge>
     150:	e3a00000 	mov	r0, #0	; 0x0
     154:	e3a01000 	mov	r1, #0	; 0x0
     158:	e3a02000 	mov	r2, #0	; 0x0
     15c:	e3a03000 	mov	r3, #0	; 0x0
     160:	eb0004b2 	bl	1430 <pwmSetMatchControlReg>
     164:	e3a00001 	mov	r0, #1	; 0x1
     168:	e3a01000 	mov	r1, #0	; 0x0
     16c:	e3a02000 	mov	r2, #0	; 0x0
     170:	e3a03000 	mov	r3, #0	; 0x0
     174:	eb0004ad 	bl	1430 <pwmSetMatchControlReg>
     178:	e3a00002 	mov	r0, #2	; 0x2
     17c:	e3a01000 	mov	r1, #0	; 0x0
     180:	e3a02000 	mov	r2, #0	; 0x0
     184:	e3a03000 	mov	r3, #0	; 0x0
     188:	eb0004a8 	bl	1430 <pwmSetMatchControlReg>
     18c:	e3a00003 	mov	r0, #3	; 0x3
     190:	e3a01000 	mov	r1, #0	; 0x0
     194:	e3a02000 	mov	r2, #0	; 0x0
     198:	e3a03000 	mov	r3, #0	; 0x0
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
    2c3c:	e92d4003 	stmdb	sp!, {r0, r1, lr}
    2c40:	ebffffb3 	bl	2b14 <__aeabi_idiv>
    2c44:	e8bd4006 	ldmia	sp!, {r1, r2, lr}
    2c48:	e0030092 	mul	r3, r2, r0
    2c4c:	e0411003 	sub	r1, r1, r3
    2c50:	e12fff1e 	bx	lr

00002c54 <__aeabi_idiv0>:
    2c54:	e12fff1e 	bx	lr
