psas/rocket-tracks/(commit log)

2013-11-15 Initial Check-In.
    [Chain and Sprockets.xlsx, PWM_driver.sch, h_bridge_pad.csv, motorController.brd, motorController.sch, motorFeedback.brd, motorFeedback.sch]
2013-11-17 Renamed Motor_Feedback folder.
    [motorFeedback.brd, motorFeedback.sch]
2014-01-12 Renamed Motor_Feedback_Board to RTx_Controller_Board, rocket_tracks_controller to RTx_LPC_Firmware.
    [RTxController.brd, RTxController.sch]
2014-01-12 Moved all non-Capstone files to archive. Consolidated datasheet folders.
    [Chain and Sprockets.xlsx, PWM_driver.sch, h_bridge_pad.csv, motorController.brd, motorController.sch]
2014-01-17 Added Ethernet switch. Removed DSLR USB connection.
2014-01-25 Cleaned up LPF/ADC schematic page, added 4th axis ADC support. Started LPF documentation.
    [Axis Feedback LPFs.xlsx, RTxController.brd, RTxController.sch]
2014-01-25 Initial check-in of RTx Controller Design.docx. Need explanation of ADC resolution requirements.
    [Axis Feedback LPFs.xlsx]
2014-01-27 Added details for ADC voltage supplies and ARef regulator.
2014-01-29 Changed ARef to 5.000V.
    [RTxController.brd, RTxController.sch]
2014-01-29 Initial check-in. Daughter board to interface manual control box with Olimex STM32-E407 board.
    [RTxManualControl.brd, RTxManualControl.sch]
2014-02-01 Completed draft of schematic without LPF component values. Need to determine LPF values, verify processor pinouts.
    [RTxManualControl.brd, RTxManualControl.sch]
2014-02-02 Changed pinout of Neutral LED connector. Added supply rail decoupling cap values, ARef decoupling cap.
    [RTxManualControl.brd, RTxManualControl.sch]
2014-02-02 Initial check-in. Needs Axis Manual Input section completed, and board overview description added.
2014-02-03 Initial check-in of pre-Capstone documents.
    [Chain+and+Sprockets.xlsx]
2014-02-04 Initial check-in. New FMEA folder containing FMEA documentation. Added the most recent WPR and the most recent Gantt chart.
    [fmea.xlsx]
2014-02-05 Initial check-in datasheet for USB ESD protection. Added initial USB setup to schematic.
    [RTxController.brd, RTxController.sch]
2014-02-06 Initial check-in of datasheet for USB ESD protection (better component selected). Updated USB in hardware to incorperate new esd chip.
    [RTxController.brd, RTxController.sch]
2014-02-08 Development of Ethernet PHY.
    [RTxController.brd, RTxController.sch]
2014-02-09 Added USB section to documentation. Adjusted schedule slightly due to my delay from traveling.
    [fmea.xlsx]
2014-02-09 Removed irrelevant sections from Manual Input ADC section.
2014-02-10 Added MagJack port to Eagle library.
    [RTxController.brd, RTxController.sch]
2014-02-12 Updated Ethernet PHY components and schematic.
    [RTxController.brd, RTxController.sch]
2014-02-13 updated FMEA
    [fmea.xlsx]
2014-02-14 Completed FMEA of manual remote
    [fmea.xlsx]
2014-02-16 updated WPR.Updated RTx manual remote PCB.
    [RTxManualControl.brd, RTxManualControl.sch]
2014-02-17 Completed board layout. Ready for design review.
    [RTxManualControl.brd]
2014-02-17 Initial check-in. Rework of dynamics with friction, coupling.
2014-02-17 Corrected equation for lateral axis moment due to coupling with vertical axis motion.
2014-02-17 Added Ethernet pinouts to MCU.
    [RTxController.brd, RTxController.sch]
2014-02-18 adjusted schedule to account for unexpected midterms this week. changed drill size on vias for manual controller board.
2014-02-18 Added dynamic coupling to vertical axis, solved for new PID coefficients. Higher-order terms have coefficients != 1, will this be a problem?
2014-02-19 Solved system transfer function for Vertical Axis with dynamic coupling. Can't solve Plant transfer function for lateral axis with dynamic coupling.
2014-02-20 fixed format of controller documentation
    [RTxManualControl.brd]
2014-02-20 Fixed stop mask on vias. Updated FMEA for R14.
    [RTxManualControl.brd, fmea.xlsx]
2014-02-21 Added CPU to schematic, completed pin-out of GMD signals, Ethernet signals, USB signals. Needs JTAG connector, ESD protection.
    [RTxController.brd, RTxController.sch]
2014-02-21 Initial check-in of Rtx_power_filter. Updated schedule reflecting meeting 2/20. Updated silkscreen on manual remote board.
    [RTxManualControl.brd, Rtx_Power_Filter.brd, Rtx_Power_Filter.sch]
2014-02-22 Replaced design rules for OshPark.
    [RTxManualControl.brd]
2014-02-23 Completed RTx Power Filter Board.
    [Rtx_Power_Filter.brd, Rtx_Power_Filter.sch]
2014-02-24 Added LPF to transfer function. Need method to solve for PID coefficients.
2014-02-25 Added values for manual input LPF components. Completed RTx Manual Remote Design document.
    [RTxManualControl.brd, RTxManualControl.sch]
2014-02-26 Added PoE power supply to controller board.
    [RTxController.brd, RTxController.sch]
2014-02-26 Made the bplace text the right way.
    [Rtx_Power_Filter.brd]
2014-02-26 Changed values to place layers for header labels.
    [RTxManualControl.brd]
2014-02-26 Generated BOM for Manual Control board. Corrected capacitor value formatting.
    [RTxManualControl.brd, RTxManualControl.sch, RTxManualControlBOM.xlsx]
2014-02-26 Added partial list of Digikey part numbers.
    [RTxManualControlBOM.xlsx]
2014-02-26 Added headers/socket part numbers.
    [RTxManualControlBOM.xlsx]
2014-02-27 Completed RTxManualControlBOM.xlsx for order.
    [RTxManualControlBOM.xlsx]
2014-02-27 Updated schedule to reflect changes in battery subsystem.
2014-02-28 Added 8V power supply. Updated Ethernet documentation.
    [RTxController.brd, RTxController.sch]
2014-03-05 Added SWD connector, values for output pin ESD protection components.
    [RTxController.brd, RTxController.sch]
2014-03-05 Simulations for ESD protection circuits.
2014-03-05 Solved for PID gains with LPF term factored into transfer function.
2014-03-11 Added capacitance to 8V and 48V PoE power supplies. Need to verify SPI daisy-chain pinout.
    [RTxController.brd, RTxController.sch]
2014-03-11 Work on FMEA of RTx Controller Schematic
    [fmea.xlsx]
2014-03-13 Updates made to FMEA.
    [fmea.xlsx]
2014-03-15 Made modifications to address issues recorded and closed.
    [RTxController.brd, RTxController.sch]
2014-03-18 Closed issues related to Power page of schematic.
    [RTxController.brd, RTxController.sch]
2014-03-18 Cleaned up schematic, began layout of RTx Controller PCB.
    [RTxController.brd, RTxController.sch]
2014-03-19 Placed additional components.
    [RTxController.brd]
2014-03-21 minor updates made to USB documentation and FMEA.
    [fmea.xlsx]
2014-03-24 Updated FMEA. Updated USB on schematic to include border. Updated documentation on USB.
    [RTxController.sch, fmea.xlsx]
2014-03-26 Updated FMEA.
    [fmea.xlsx]
2014-03-28 Added charger schematic and board along with part datasheets.
    [RTx_Charger.brd, RTx_Charger.sch]
2014-03-28 Added power supply table to schematic. Modified various components to be surface mount.
    [RTxController.brd, RTxController.sch]
2014-03-28 Included power supply table.
2014-03-28 Revert "Added power supply table to schematic. Modified various components to be surface mount."
    This reverts commit e3ac1e6c28b3b33263b1681ea2489635cc48a7dc.
    [RTxController.brd, RTxController.sch]
2014-03-28 Revert "Added charger schematic and board along with part datasheets."
    This reverts commit c83723e76ca39845fbcdc11e1f686fe063c81314.
    [RTx_Charger.brd, RTx_Charger.sch]
2014-03-28 Precharge circuit and datasheets.
    [RTx_Charger.brd, RTx_Charger.sch]
2014-03-30 updated layout of Rtx Controller Board.
    [RTxController.brd, RTxController.sch, fmea.xlsx]
2014-03-31 Most recent WPR.docx. Updated charger circuit to reflect potential issue fix.
    [RTx_Charger.brd, RTx_Charger.sch]
2014-04-01 LTSpice main power charging circuit.
2014-04-01 Proposed solution eliminating all but the high-current relay which bypasses the charge resistor.
2014-04-01 Updated power supply documentation. Included alternative charger schematic.
    [Power Requirements - Controller Board.xlsx, RTx_Charger_Alternative.brd, RTx_Charger_Alternative.sch]
2014-04-01 Ethernet and PoE controllers completely redone.
    [RTxController.brd, RTxController.sch]
2014-04-02 Ethernet pinout.
    [RTxController.brd, RTxController.sch]
2014-04-02 Added LEDs and testpoints to processor for debugging. Fixed JTAG connector.
    [RTxController.brd, RTxController.sch]
2014-04-03 Updated USB portion of schematic to include crystal and fixed capacitance. Initial check in of crystal datasheet.
    [RTxController.brd, RTxController.sch]
2014-04-04 Added folder for Sightline data.
    [Sightline tracking 001.xlsx]
2014-04-04 Sightline tracking sample video.
2014-04-04 small changes made to layout.
    [RTxController.brd]
2014-04-05 updates made to PCB layout
    [RTxController.brd]
2014-04-05 Added voltage divider to inverting input of opamp.
    [RTx_Charger_Alternative.brd, RTx_Charger_Alternative.sch]
2014-04-08 Updated controller schematic with high speed signal routing information. Added termination resistor to SPI_SCK line. Included Sightline documentation. Added avionics library, node4-2.lbr, to RTx cont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
    [RTxController.brd, RTxController.sch, RTx_Charger_Alternative.brd, RTx_Charger_Alternative.sch]
2014-04-10 Changes to RTx charger board.
    [RTx_Charger_Alternative.sch, RTx_Charger_Alternative2.brd]
2014-04-10 updates made to RTx layout
    [RTxController.brd]
2014-04-10 minor updates made
    [RTxController.brd]
2014-04-13 Rtx Controller board updated, all that remains are power planes and rework by Rob. Initial check in of crystal.lbr.
    [RTxController.brd, RTxController.sch]
2014-04-13 Repositioned LDO's created power planes.
    [RTxController.brd, RTxController.sch]
2014-04-14 High speed signal routing information added to schematic. Updated Precharge board.
    [RTxController.sch, RTx_Charger_Alternative.brd, RTx_Charger_Alternative.sch, RTx_Charger_Alternative2.brd]
2014-04-15 Added termination resistors to RMII bus, adjusted width of digital signals.
    [RTxController.brd, RTxController.sch]
2014-04-15 Created RTx Charger BOM.
    [RTxChargerBOM.xlsx]
2014-04-15 Reduced board width.
    [RTxController.brd, RTxController.sch]
2014-04-15 Updated schematic PDF, created layout PDF.
2014-04-16 PoE power supply ON/OFF connection changed to open circuit, to remain ON.
    [RTxController.brd, RTxController.sch]
2014-04-16 Additional RTx Controller layout performed.
    [RTxController.brd, RTxController.sch]
2014-04-18 Cleared all non-ground airwires, replaced dual LDO with 3.3V and 5V LDO's, reconfigured power planes.
    [RTxController.brd, RTxController.sch]
2014-04-18 Added "temp_library.lbr" to eagle folder. Updated Power requirements excel documentation.
    [Power Requirements - Controller Board.xlsx]
2014-04-19 Board layout ready for design review.
    [RTxController.brd, RTxController.sch]
2014-04-19 Updated parts in temp_library.lbr (RJ45, 8V power supply, and 48V power supply).
2014-04-19 Closed additional issues raised in layout review.
    [RTxController.brd, RTxController.sch]
2014-04-19 Layout ready for silkscreen cleanup. Updated schedule.
    [RTxController.brd, RTxController.sch]
2014-04-20 Updated Rtx Controller silkscreen
    [RTxController.brd]
2014-04-20 Closed all remaining issues from layout review.
    [RTxController.brd, RTxController.sch]
2014-04-22 Added drawing of E-Stop control circuit for addition to Main Power board.
2014-04-23 Replaced non-existent capacitors with available parts.
    [RTxController.brd, RTxController.sch]
2014-04-23 Initial check-in of Controller Board BOM.
    [RTxControllerBoardBOM.xlsx]
2014-04-23 Updated controller board BOM part numbers.
    [RTxControllerBoardBOM.xlsx]
2014-04-24 Added Robin's part #'s. Needs MAXIM POE Controller supplier.
    [RTxControllerBoardBOM.xlsx]
2014-04-24 Added E-Stop circuit to Main Power board.
2014-04-25 Added TP to Pin 6 of POE Controller.
    [RTxController.brd, RTxController.sch]
2014-04-25 Changed PoE controller to variant A.
    [RTxController.brd, RTxController.sch, RTxControllerBoardBOM.xlsx]
2014-04-25 Final commit for order.
    [RTxController.brd]
2014-04-25 Changed font to vector, 25 mils, 20% -- now go fix all the prettiness.
    [RTxController.brd]
2014-04-25 Added additional terminals to RTx_Charger board.
    [RTx_Charger.brd, RTx_Charger.sch, RTx_Charger_Alternative.brd, RTx_Charger_Alternative.sch]
2014-04-25 Added terminals for connectors to BOM.
    [RTxControllerBoardBOM.xlsx]
2014-04-25 updated RTx Controller Board silkscreen.
    [RTxController.brd]
2014-04-25 Text fixed and ready to order.
    [RTxController.brd, RTxController.sch, RTxControllerBoardBOM.xlsx]
2014-04-25 RTx_Charger board layout changed.
    [RTx_Charger.brd, RTx_Charger.sch]
2014-04-26 Completed charger board and BOM.
    [RTxChargerBOM.xlsx, RTx_Charger.brd, RTx_Charger.sch]
2014-04-26 Charger board completed.
2014-04-26 Added panel-mount D-Sub to BOM.
    [RTxChargerBOM.xlsx]
2014-05-09 Added packet information captured by wireshark to Sightline folder.
    [Sightline tracking 001.xlsx]
2014-05-13 Created test plan document.
    [Test plan.xlsx]
2014-05-15 Initial check in of System FMEA. Updated signal names to match system FMEA in schematic.
    [RTxController.brd, RTxController.sch]
2014-05-15 Added test cases for Firmware.
    [Test plan.xlsx]
2014-05-16 Added gerber files for RTx Controller stencil.
    [RTxControllerBoardBOM.xlsx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]
2014-05-17 Initial check-in of poster materials. updated FMEA
    [fmea_external.xlsx, fmea_system_level.xlsx]
2014-05-26 Block diagram for poster.
    [Test plan.xlsx]
2014-05-26 Updated poster2 power point.
2014-05-28 Added pictures of the RTx controller board.
2014-06-03 Precharge circuit spice schematic labeled with Eagle schematic labels.
2014-06-10 initial check in of power point
2014-06-12 Completed documentation for Capstone.
    [Axis Feedback LPFs.xlsx]
2014-06-12 Reorganized documentation folder.
    [Chain+and+Sprockets.xlsx, Power Requirements - Controller Board.xlsx]
